Krish28062000/Active-vibration-control-hand-exoskeleton/docs/images/social_preview.png

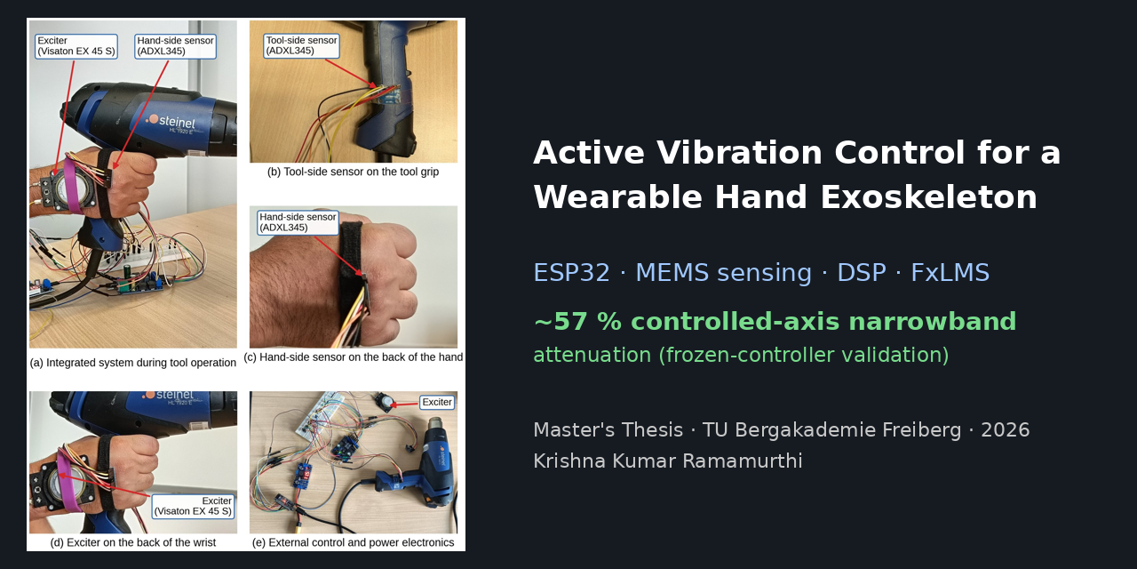
docs/images/social_preview.png
