Krish28062000/Active-vibration-control-hand-exoskeleton/data/01_sensor_validation/static_gravity_validation.xlsx

Sheet: Freeze Summary
TEST 01 — Static Triaxial Gravity Verification and Calibration Identification
Item | Freeze-status conclusion
Dataset | Latest selected ±X/±Y/±Z results; n=3 per pose; N=3200 per record
ADXL1 role | Tool/reference sensor
ADXL2 role | Hand/error sensor
Digital integrity | PASS — expected register state, no clipping, no late samples, no stuck data
Short-term repeatability | PASS — excellent for all selected active-axis poses
Axis polarity | PASS for all selected orientations
Raw absolute response | Axis-dependent; calibration required before final quantitative comparison
Dominant systematic effect | Z-axis static bias: negative for ADXL1, positive for ADXL2
Current coefficients | CANDIDATE ONLY — identified from the selected calibration dataset
Thesis freeze status | FREEZE methodology + raw findings; freeze final corrected accuracy only after independent validation
Scientific verdict
The selected six-position dataset demonstrates a stable and repeatable dual-ADXL345 measurement chain. Improved physical alignment reduced several transverse components, while the characteristic Z-axis polarity asymmetry remained. This supports a systematic offset/sensitivity interpretation rather than random instability. The present dataset is therefore suitable for identifying candidate per-axis bias and scale coefficients. However, the same data must not be used as independent proof of corrected accuracy. A fresh post-calibration six-position verification is required before the corrected sensor accuracy is frozen for the thesis.
KPI | ADXL1 | ADXL2 | Interpretation
Maximum active-axis repeat CV (%) | 0.125 | 0.134 | Both < 0.2% in selected dataset
Candidate Z bias (m/s²) | -0.689 | 1.523 | Large, opposite-sign static bias
Candidate Z bias (mg) | -70.237 | 155.274 | Preliminary installed-system estimate
Candidate Z span error (%) | -2.858 | -1.146 | Far smaller than the raw +Z/−Z error
Selected records | 18.000 | 18.000 | 36 total records
Invalid selected records | 0.000 | 0.000 | All selected records structurally valid
Important: the final two mislabeled −Z records in the 10:44 log are NOT part of the selected dataset. They are preserved in the Excluded Superseded sheet.

Sheet: Selected Results
Sensor | Role | Orientation | Active axis | Mean X (m/s²) | Mean Y (m/s²) | Mean Z (m/s²) | Vector norm (m/s²) | Active mean (m/s²) | Active error (%) | Norm error (%) | Between-repeat SD active | Active CV (%) | Raw transverse magnitude | Valid repeats | Status
ADXL1 | Tool/reference | +X | X | 9.6295 | -0.3378 | -0.0915 | 9.6394 | 9.6295 | -1.8060 | -1.7060 | 0.0036 | 0.0379 | 0.3499 | 3 | COMPLETE
ADXL1 | Tool/reference | -X | X | -9.5102 | 0.5747 | -0.9444 | 9.5774 | -9.5102 | 3.0230 | -2.3370 | 0.0064 | 0.0672 | 1.1055 | 3 | COMPLETE
ADXL1 | Tool/reference | +Y | Y | -0.2187 | 9.8075 | -1.4193 | 9.9149 | 9.8075 | 0.0090 | 1.1040 | 0.0011 | 0.0112 | 1.4360 | 3 | COMPLETE
ADXL1 | Tool/reference | -Y | Y | 0.2489 | -9.5546 | -2.4756 | 9.8750 | -9.5546 | 2.5700 | 0.6970 | 0.0119 | 0.1246 | 2.4881 | 3 | COMPLETE
ADXL1 | Tool/reference | +Z | Z | 0.7166 | 0.1705 | 8.8376 | 8.8725 | 8.8376 | -9.8820 | -9.5250 | 0.0110 | 0.1248 | 0.7366 | 3 | COMPLETE
ADXL1 | Tool/reference | -Z | Z | 0.2017 | 0.0421 | -10.2152 | 10.2184 | -10.2152 | -4.1660 | 4.1990 | 0.0035 | 0.0344 | 0.2060 | 3 | COMPLETE
ADXL2 | Hand/error | +X | X | 9.8054 | -0.2317 | 1.5060 | 9.9277 | 9.8054 | -0.0130 | 1.2350 | 0.0035 | 0.0359 | 1.5238 | 3 | COMPLETE
ADXL2 | Hand/error | -X | X | -9.9235 | 0.8846 | 0.9486 | 10.0117 | -9.9235 | -1.1920 | 2.0910 | 0.0035 | 0.0356 | 1.2971 | 3 | COMPLETE
ADXL2 | Hand/error | +Y | Y | 0.0006 | 10.2268 | 0.1351 | 10.2304 | 10.2268 | 4.2850 | 4.3210 | 0.0022 | 0.0215 | 0.1351 | 3 | COMPLETE
ADXL2 | Hand/error | -Y | Y | -0.2651 | -9.6018 | 0.3026 | 9.6142 | -9.6018 | 2.0890 | -1.9620 | 0.0032 | 0.0334 | 0.4022 | 3 | COMPLETE
ADXL2 | Hand/error | +Z | Z | 0.0035 | 0.3134 | 11.2170 | 11.2245 | 11.2170 | 14.3810 | 14.4580 | 0.0150 | 0.1339 | 0.3134 | 3 | COMPLETE
ADXL2 | Hand/error | -Z | Z | -0.3386 | -0.0223 | -8.1715 | 8.1806 | -8.1715 | 16.6730 | -16.5810 | 0.0080 | 0.0974 | 0.3394 | 3 | COMPLETE

Sheet: Calibration Parameters
Sensor | Role | Axis | +g selected mean | −g selected mean | Candidate bias b (m/s²) | Candidate bias (mg) | Measured sensitivity ratio s | Span error (%) | Correction gain K=1/s | Correction equation | Freeze status | Constant | Value
ADXL1 | Tool/reference | X | 9.629546 | -9.510226 | 0.059660 | 6.083627 | 0.975857 | -2.414321 | 1.024741 | aX,corr = 1.024741 × (aX,raw − (0.059660)) | Candidate — independent validation required | g (m/s²) | 9.80665
ADXL1 | Tool/reference | Y | 9.807509 | -9.554607 | 0.126451 | 12.894413 | 0.987193 | -1.280682 | 1.012973 | aY,corr = 1.012973 × (aY,raw − (0.126451)) | Candidate — independent validation required
ADXL1 | Tool/reference | Z | 8.837584 | -10.215163 | -0.688790 | -70.236982 | 0.971420 | -2.858025 | 1.029421 | aZ,corr = 1.029421 × (aZ,raw − (-0.688790)) | Candidate — independent validation required
ADXL2 | Hand/error | X | 9.805357 | -9.923497 | -0.059070 | -6.023464 | 1.005892 | 0.589161 | 0.994143 | aX,corr = 0.994143 × (aX,raw − (-0.059070)) | Candidate — independent validation required
ADXL2 | Hand/error | Y | 10.226844 | -9.601801 | 0.312521 | 31.868324 | 1.010980 | 1.097954 | 0.989140 | aY,corr = 0.989140 × (aY,raw − (0.312521)) | Candidate — independent validation required
ADXL2 | Hand/error | Z | 11.216983 | -8.171547 | 1.522718 | 155.274023 | 0.988540 | -1.146008 | 1.011593 | aZ,corr = 1.011593 × (aZ,raw − (1.522718)) | Candidate — independent validation required
Definitions: bᵢ=(aᵢ⁺+aᵢ⁻)/2; sᵢ=(aᵢ⁺−aᵢ⁻)/(2g); Kᵢ=1/sᵢ; aᵢ,corr=Kᵢ(aᵢ,raw−bᵢ), with g=9.80665 m/s².

Sheet: Repeatability Integrity
Repeatability and Data-Integrity Assessment
Sensor | Orientation | Active mean | Between SD | CV (%) | Assessment | Integrity metric | Result | Verdict
ADXL1 | +X | 9.6295 | 0.0036 | 0.0379 | Excellent | Selected records | 36 | PASS
ADXL1 | -X | -9.5102 | 0.0064 | 0.0672 | Excellent | Clipping events | 0 | PASS
ADXL1 | +Y | 9.8075 | 0.0011 | 0.0112 | Excellent | Late samples | 0 | PASS
ADXL1 | -Y | -9.5546 | 0.0119 | 0.1246 | Excellent | Raw data changed | All selected runs = 1 | PASS
ADXL1 | +Z | 8.8376 | 0.0110 | 0.1248 | Excellent | Register before/after | All selected runs = 1/1 | PASS
ADXL1 | -Z | -10.2152 | 0.0035 | 0.0344 | Excellent | Max lateness | ≤ 2 µs in selected latest runs | PASS
ADXL2 | +X | 9.8054 | 0.0035 | 0.0359 | Excellent | Selected invalid runs | 0 | PASS
ADXL2 | -X | -9.9235 | 0.0035 | 0.0356 | Excellent
ADXL2 | +Y | 10.2268 | 0.0022 | 0.0215 | Excellent
ADXL2 | -Y | -9.6018 | 0.0032 | 0.0334 | Excellent
ADXL2 | +Z | 11.2170 | 0.0150 | 0.1339 | Excellent
ADXL2 | -Z | -8.1715 | 0.0080 | 0.0974 | Excellent

Sheet: Selected Raw Repeats
Sensor | Role | Orientation | Repeat | N | Mean X | SD X | Mean Y | SD Y | Mean Z | SD Z | Mean norm | SD norm | Active axis | Measured active | Active error % | Norm error % | Clip | Late | Max late µs | Raw changed | Reg before | Reg after | Status
ADXL1 | Tool/reference | +X | 1 | 3200 | 9.629490 | 0.137651 | -0.320907 | 0.189651 | -0.073193 | 0.163088 | 9.638324 | 0.140052 | X | 9.629490 | -1.807000 | -1.716000 | 0 | 0 | 2 | 1 | 1 | 1 | VALID
ADXL1 | Tool/reference | +X | 2 | 3200 | 9.625928 | 0.138254 | -0.427924 | 0.182347 | -0.068126 | 0.161009 | 9.638707 | 0.140891 | X | 9.625928 | -1.843000 | -1.713000 | 0 | 0 | 2 | 1 | 1 | 1 | VALID
ADXL1 | Tool/reference | +X | 3 | 3200 | 9.633219 | 0.139519 | -0.264447 | 0.176655 | -0.133144 | 0.185968 | 9.641152 | 0.141348 | X | 9.633219 | -1.769000 | -1.688000 | 0 | 0 | 2 | 1 | 1 | 1 | VALID
ADXL1 | Tool/reference | -X | 1 | 3200 | -9.502920 | 0.138622 | 0.694618 | 0.156763 | -0.903106 | 0.177857 | 9.573873 | 0.141206 | X | -9.502920 | 3.097000 | -2.374000 | 0 | 0 | 2 | 1 | 1 | 1 | VALID
ADXL1 | Tool/reference | -X | 2 | 3200 | -9.514752 | 0.133558 | 0.525356 | 0.162528 | -0.963415 | 0.169516 | 9.580678 | 0.135079 | X | -9.514752 | 2.977000 | -2.304000 | 0 | 0 | 2 | 1 | 1 | 1 | VALID
ADXL1 | Tool/reference | -X | 3 | 3200 | -9.513007 | 0.124207 | 0.504081 | 0.147009 | -0.966618 | 0.160840 | 9.577718 | 0.126335 | X | -9.513007 | 2.994000 | -2.334000 | 0 | 0 | 2 | 1 | 1 | 1 | VALID
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
ADXL2 | Hand/error | -Z | 3 | 3200 | -0.342397 | 0.140209 | -0.029999 | 0.116046 | -8.162424 | 0.212657 | 8.171689 | 0.212452 | Z | -8.162424 | 16.766000 | -16.672000 | 0 | 0 | 2 | 1 | 1 | 1 | VALID

Sheet: Excluded Superseded
Excluded / Superseded Observations — Preserve for Audit Trail
Status | Sensor | Command | Observed Z | Reason | Use in calculations | Source | Comment
INVALID | ADXL1 | -Z | +8.480 m/s² | Physical sign inconsistent with commanded −Z | NO | 10:44 log | Likely +Z-up pose; active error ≈186%
INVALID | ADXL2 | -Z | +10.995 m/s² | Physical sign inconsistent with commanded −Z | NO | 10:44 log | Likely +Z-up pose; active error ≈212%
SUPERSEDED | ADXL1 | -Z | −10.136 m/s² | Replaced by cleaner latest −Z pose | NO for final coefficients | 10:44 log | Retain as repeat evidence
SUPERSEDED | ADXL2 | -Z | −8.115 m/s² | Replaced by cleaner latest −Z pose | NO for final coefficients | 10:44 log | Retain as repeat evidence
SUPERSEDED | ADXL1 | +Z | +8.803 m/s² | Replaced by later +Z pose with smaller transverse components | NO for final coefficients | 10:44 log | Retain as repeat evidence

Sheet: Thesis Main Tables
Main-Thesis Tables — Recommended Final Presentation
Table 4.x — Static gravity response of the selected dual-accelerometer dataset |  |  |  |  |  |  |  |  |  | Sensor-axis | +g measured | −g measured | Ideal +g | Sensor-axis | Candidate bias (m/s²)
Sensor | Axis | Positive pose | Negative pose | +g mean | −g mean | Bias (m/s²) | Sensitivity ratio | Span error % | Correction gain | ADXL1-X | 9.6295 | -9.5102 | 9.8066 | ADXL1-X | 0.0597
ADXL1 | X | +X | -X | 9.6295 | -9.5102 | 0.0597 | 0.9759 | -2.4143 | 1.0247 | ADXL1-Y | 9.8075 | -9.5546 | 9.8066 | ADXL1-Y | 0.1265
ADXL1 | Y | +Y | -Y | 9.8075 | -9.5546 | 0.1265 | 0.9872 | -1.2807 | 1.0130 | ADXL1-Z | 8.8376 | -10.2152 | 9.8066 | ADXL1-Z | -0.6888
ADXL1 | Z | +Z | -Z | 8.8376 | -10.2152 | -0.6888 | 0.9714 | -2.8580 | 1.0294 | ADXL2-X | 9.8054 | -9.9235 | 9.8066 | ADXL2-X | -0.0591
ADXL2 | X | +X | -X | 9.8054 | -9.9235 | -0.0591 | 1.0059 | 0.5892 | 0.9941 | ADXL2-Y | 10.2268 | -9.6018 | 9.8066 | ADXL2-Y | 0.3125
ADXL2 | Y | +Y | -Y | 10.2268 | -9.6018 | 0.3125 | 1.0110 | 1.0980 | 0.9891 | ADXL2-Z | 11.2170 | -8.1715 | 9.8066 | ADXL2-Z | 1.5227
ADXL2 | Z | +Z | -Z | 11.2170 | -8.1715 | 1.5227 | 0.9885 | -1.1460 | 1.0116 | Ideal |  | -9.8066 | 9.8066
Table 4.y — Repeatability and measurement-integrity summary
Metric | ADXL1 | ADXL2 | Overall | Recommended main-text statement | Location
Maximum selected active-axis CV (%) | 0.1248 | 0.1339 | 0.1339 | All selected poses remained well below 0.5% CV. | Main text
Clipping events | 0 | 0 | 0 | No clipping was observed. | Main text
Late samples | 0 | 0 | 0 | No late samples were observed in the selected records. | Main text
Register integrity | PASS | PASS | PASS | Sensor configuration remained unchanged before/after records. | Main text
Raw repeats | 18 | 18 | 36 | Three independent records were acquired per pose. | Methods/results
Recommended figures
Figure | Plot | Reason
Figure 4.x | Measured +g/−g active-axis response with ideal ±9.80665 m/s² reference | Makes polarity asymmetry and offset immediately visible
Figure 4.y | Candidate bias b for X/Y/Z of ADXL1 and ADXL2 | Shows opposite-sign Z bias clearly
Figure 4.z (after validation) | Raw vs corrected gravity error using independent validation data | Do not generate final version from calibration data itself

Sheet: Thesis Draft
Draft Thesis Subsection — Candidate for Freeze after Supervisor/User Validation
Suggested subsection title
4.2.x Static Triaxial Verification and Calibration of the ADXL345 Measurement Channels
Purpose and protocol
Before the dynamic vibration experiments, the two ADXL345 measurement channels were evaluated under static gravitational loading. ADXL1 was used as the tool-side reference sensor and ADXL2 as the hand-side error sensor. Each accelerometer was successively oriented with its positive and negative X, Y and Z axes aligned as closely as practicable with the gravity vector. Three independent records were acquired for each orientation, with 3200 samples per record. In addition to the acceleration statistics, the firmware monitored sample timing, clipping, raw-data activity and the sensor configuration registers before and after every record.
Measurement integrity and repeatability
All 36 records selected for the final calibration dataset were structurally valid. No clipping or late samples were observed, the raw-data activity check remained valid, and the ADXL345 configuration registers retained the expected values throughout the measurements. The active-axis means were highly repeatable within each orientation. The maximum between-repeat coefficient of variation in the selected dataset remained below 0.2%, indicating that the principal deviations from the ideal ±g response were systematic rather than random.
Observed static response
The improved six-position measurements produced substantially cleaner axis alignment than the preliminary hand-held trial, particularly for the X orientations and the final Z orientations. Nevertheless, the raw response remained sensor- and axis-dependent. ADXL1 exhibited a negative Z-axis bias, whereas ADXL2 exhibited a positive Z-axis bias. Using the selected +Z and −Z measurements, the preliminary bias estimates were approximately -0.689 m/s² for ADXL1 and 1.523 m/s² for ADXL2. In contrast, the corresponding Z-axis span errors were only -2.86% and -1.15%, respectively. The opposite-polarity asymmetry therefore cannot be interpreted simply as a large sensitivity error.
Calibration model
For each sensor axis i, the static bias was estimated as b_i=(a_i+ + a_i−)/2 and the measured sensitivity ratio as s_i=(a_i+ − a_i−)/(2g), where g=9.80665 m/s². The corresponding correction gain was K_i=1/s_i, giving the linear correction a_i,corr=K_i(a_i,raw−b_i). These coefficients are reported as candidate installed-system calibration parameters. They are not yet treated as final validated constants because the calibration and verification data must remain independent.
Interpretation and limitation
The static experiment verifies sensor polarity, short-term repeatability, acquisition integrity and the presence of installed-system offset and sensitivity differences. It does not by itself establish dynamic amplitude accuracy at the vibration-control frequency. Dynamic suitability is therefore verified separately through the subsequent stationary-noise, same-body dual-sensor and controlled-frequency vibration experiments. A fresh six-position run with the candidate coefficients enabled is required before the corrected static accuracy is frozen.
Result statement to freeze
The dual-ADXL345 measurement chain passed the static integrity and repeatability verification. The selected data showed highly repeatable but axis-dependent raw acceleration values, with the largest systematic effect occurring as opposite-sign Z-axis bias in the two accelerometers. A per-axis offset-and-scale calibration model was therefore identified. Final corrected accuracy will be reported only after independent post-calibration six-position validation.

Sheet: Validation Plan
Independent Post-Calibration Validation — Required Before Final Freeze
Step | Action | Data to save | Decision metric | Status | Thesis use
1 | Apply candidate b and K coefficients in firmware; keep raw values in output | RAW XYZ + CAL XYZ | Code audit | Pending | Methodology
2 | Fresh +X/−X/+Y/−Y/+Z/−Z run for ADXL1 | 3 records/pose | Correct sign + repeatability | Pending | Verification
3 | Fresh +X/−X/+Y/−Y/+Z/−Z run for ADXL2 | 3 records/pose | Correct sign + repeatability | Pending | Verification
4 | Compare corrected active-axis and vector norm to g | Summary statistics | Project target: ≤3%, preferably ≤2% | Pending | Results
5 | Confirm clipping/timing/register integrity | Validity flags | All PASS | Pending | Results
6 | Freeze calibration constants only after independent pass | Versioned constants | Pass/Fail | Pending | Thesis freeze
7 | Proceed to stationary noise-floor Test 02 | 10 stationary records | Noise floor | Pending | Section 4.2
The ≤3% / preferably ≤2% target is a project-defined engineering acceptance target, not an ISO requirement or an ADXL345 datasheet accuracy specification.

Sheet: Sources
Source | Type | Use in workbook/thesis | URL / provenance
Latest full experimental log | Primary experimental data | X/Y/+Z selected records and integrity evidence | Pasted text(20260817-104409).txt
Latest ADXL1 −Z rerun | Primary experimental data | Replaces earlier ADXL1 −Z for coefficient identification | Conversation result immediately preceding this workbook
Latest ADXL2 −Z rerun | Primary experimental data | Replaces earlier ADXL2 −Z for coefficient identification | Conversation result immediately preceding ADXL1 −Z rerun
ADXL345 Rev. G datasheet | Manufacturer primary source | Full-resolution scale, offset registers, calibration discussion | https://www.analog.com/media/en/technical-documentation/data-sheets/adxl345.pdf
AN-1057 | Manufacturer application note | Gravity projection, offset/sensitivity mismatch context | https://www.analog.com/en/resources/app-notes/an-1057.html
