Krish28062000/Active-vibration-control-hand-exoskeleton/data/01_sensor_validation/stationary_noise_floor.xlsx

Sheet: Executive Verdict
TEST 02 V2 — Stationary Noise-Floor Characterization: Thesis Audit
 |  |  |  | Channel | V1 broadband | V2 broadband | V2 screened? | Channel | Mean 268 Hz | Max 268 Hz | Sensor | Measured Fs | Nominal Fs
Assessment item | Verdict |  |  | ADXL1-X | 0.126601896 | 0.3107549826 | 10 clean | ADXL1-X | 0.008062325816 | 0.02148821933 | ADXL1 | 1542.684616 | 1600
Campaign completion | 10/10 records collected for both sensors |  |  | ADXL1-Y | 0.1459826628 | 0.3218261857 | 10 clean | ADXL1-Y | 0.0107056123 | 0.02399554162 | ADXL2 | 1584.808629 | 1600
Register integrity | PASS — all before/after checks valid |  |  | ADXL1-Z | 0.1550978445 | 0.4282262204 | 10 clean | ADXL1-Z | 0.01361392689 | 0.02549054899
Clipping | PASS — zero clipping in all records |  |  | ADXL2-X | 0.122140815 | 0.3783184634 | 8 clean | ADXL2-X | 0.01219186968 | 0.02042336316
DATA_READY timeouts | PASS — zero timeouts |  |  | ADXL2-Y | 0.128609652 | 0.4266211372 | 8 clean | ADXL2-Y | 0.01163107507 | 0.02839383365
Fresh-sample method | Improved versus V1 — DATA_READY synchronized |  |  | ADXL2-Z | 0.2110683135 | 0.80198192 | 8 clean | ADXL2-Z | 0.02436242281 | 0.04858208975
Measured effective sample rate | ADXL1 ≈1542.685 Hz; ADXL2 ≈1584.809 Hz
Sampling-rate stability | Excellent between records (CV <0.03%)
Timing anomaly | ADXL2 records 4 and 8 contain ~2× normal maximum interval
Broadband system noise | Repeatable, but materially higher than V1
268 Hz floor | Measurable; ADXL2-Z is highest channel
Final thesis status | NOT YET FINAL — timing-screening/final acquisition method must be closed
Move to next experimental test? | NO — close Test 02 first; do not freeze current firmware summary blindly
Central scientific finding
V2 confirms that the stationary measurement chain is stable at the communication level and reveals a substantially larger system-level broadband noise floor than V1. The largest stationary noise occurs on ADXL2-Z. However, two ADXL2 campaign records contain a single approximately double-duration sampling interval that the firmware did not reject. Because those records also raise the 268-Hz statistics, the unfiltered 10-record V2 summary must not be frozen as the final narrowband noise-floor result. The workbook therefore preserves the firmware summary and separately reports a timing-screened reanalysis.
KPI | ADXL1 | ADXL2 | Interpretation
Mean effective Fs (Hz) | 1542.684616 | 1584.808629 | Measured from DATA_READY timing
Deviation from nominal 1600 Hz (%) | -3.582211 | -0.949461 | Stable sensor-specific rate difference
SD of effective Fs (Hz) | 0.321089 | 0.474170 | Very small record-to-record variation
Mean interval-jitter SD (µs) | 8.602610 | 9.156511 | Host detection/timing variability
Timing-anomaly records | 0.000000 | 2.000000 | ADXL2 records 4 and 8
Mean 268-Hz noise, Z (m/s²) | 0.013614 | 0.024362 | Firmware 10-record summary
Max 268-Hz noise, Z (m/s²) | 0.025491 | 0.048582 | Firmware 10-record summary

Sheet: V2 Firmware Summary
Sensor | Role | Axis | n | Mean broadband SD | SD broadband SD | Max broadband SD | Mean P2P | Max P2P | Mean 268-Hz amplitude | SD 268-Hz amplitude | Max 268-Hz amplitude | Mean strongest FFT amplitude | Max strongest FFT amplitude
ADXL1 | Tool/reference | X | 10 | 0.310755 | 0.005955 | 0.324431 | 2.149422 | 2.371248 | 0.008062 | 0.005797 | 0.021488 | 0.084211 | 0.117795
ADXL1 | Tool/reference | Y | 10 | 0.321826 | 0.008506 | 0.345255 | 2.248861 | 2.447740 | 0.010706 | 0.006447 | 0.023996 | 0.087561 | 0.108521
ADXL1 | Tool/reference | Z | 10 | 0.428226 | 0.014316 | 0.467542 | 2.891393 | 3.289150 | 0.013614 | 0.005124 | 0.025491 | 0.136393 | 0.173144
ADXL2 | Hand/error | X | 10 | 0.378318 | 0.007719 | 0.397541 | 2.554828 | 2.830199 | 0.012192 | 0.004272 | 0.020423 | 0.093852 | 0.118307
ADXL2 | Hand/error | Y | 10 | 0.426621 | 0.010985 | 0.454931 | 2.608373 | 2.830199 | 0.011631 | 0.007254 | 0.028394 | 0.104457 | 0.122876
ADXL2 | Hand/error | Z | 10 | 0.801982 | 0.021575 | 0.849777 | 5.553310 | 6.042858 | 0.024362 | 0.011651 | 0.048582 | 0.264975 | 0.323547

Sheet: Sampling Integrity
Record | Sensor | Role | Mean interval (µs) | SD interval (µs) | Min interval (µs) | Max interval (µs) | Effective Fs (Hz) | Fs deviation from 1600 (%) | Max/mean interval ratio | Timing screen | Clip count | DATA_READY timeouts | Raw changed | Reg before | Reg after | Firmware status
1 | ADXL1 | Tool/reference | 648.2503 | 8.5415 | 632.0000 | 658.0000 | 1542.6140 | -3.5866 | 1.0150 | PASS | 0 | 0 | 1 | 1 | 1 | VALID
1 | ADXL2 | Hand/error | 631.2603 | 8.0654 | 614.0000 | 641.0000 | 1584.1325 | -0.9917 | 1.0154 | PASS | 0 | 0 | 1 | 1 | 1 | VALID
2 | ADXL1 | Tool/reference | 648.2017 | 8.5796 | 632.0000 | 658.0000 | 1542.7297 | -3.5794 | 1.0151 | PASS | 0 | 0 | 1 | 1 | 1 | VALID
2 | ADXL2 | Hand/error | 631.1714 | 8.1667 | 614.0000 | 642.0000 | 1584.3556 | -0.9778 | 1.0172 | PASS | 0 | 0 | 1 | 1 | 1 | VALID
3 | ADXL1 | Tool/reference | 648.2078 | 8.6427 | 632.0000 | 660.0000 | 1542.7151 | -3.5803 | 1.0182 | PASS | 0 | 0 | 1 | 1 | 1 | VALID
3 | ADXL2 | Hand/error | 631.1670 | 8.1641 | 614.0000 | 640.0000 | 1584.3667 | -0.9771 | 1.0140 | PASS | 0 | 0 | 1 | 1 | 1 | VALID
4 | ADXL1 | Tool/reference | 648.2110 | 8.6203 | 632.0000 | 658.0000 | 1542.7076 | -3.5808 | 1.0151 | PASS | 0 | 0 | 1 | 1 | 1 | VALID
4 | ADXL2 | Hand/error | 631.1790 | 12.7387 | 614.0000 | 1255.0000 | 1584.3366 | -0.9790 | 1.9883 | TIMING_ANOMALY | 0 | 0 | 1 | 1 | 1 | VALID
5 | ADXL1 | Tool/reference | 648.1858 | 8.6257 | 632.0000 | 660.0000 | 1542.7674 | -3.5770 | 1.0182 | PASS | 0 | 0 | 1 | 1 | 1 | VALID
5 | ADXL2 | Hand/error | 630.8818 | 8.2772 | 614.0000 | 640.0000 | 1585.0830 | -0.9323 | 1.0145 | PASS | 0 | 0 | 1 | 1 | 1 | VALID
6 | ADXL1 | Tool/reference | 648.2059 | 8.6427 | 632.0000 | 658.0000 | 1542.7198 | -3.5800 | 1.0151 | PASS | 0 | 0 | 1 | 1 | 1 | VALID
6 | ADXL2 | Hand/error | 630.8994 | 8.2867 | 614.0000 | 641.0000 | 1585.0388 | -0.9351 | 1.0160 | PASS | 0 | 0 | 1 | 1 | 1 | VALID
7 | ADXL1 | Tool/reference | 648.1839 | 8.5854 | 632.0000 | 658.0000 | 1542.7721 | -3.5767 | 1.0151 | PASS | 0 | 0 | 1 | 1 | 1 | VALID
7 | ADXL2 | Hand/error | 630.8828 | 8.2653 | 614.0000 | 642.0000 | 1585.0805 | -0.9325 | 1.0176 | PASS | 0 | 0 | 1 | 1 | 1 | VALID
8 | ADXL1 | Tool/reference | 648.0967 | 8.6933 | 632.0000 | 658.0000 | 1542.9796 | -3.5638 | 1.0153 | PASS | 0 | 0 | 1 | 1 | 1 | VALID
8 | ADXL2 | Hand/error | 630.9705 | 12.9004 | 614.0000 | 1265.0000 | 1584.8603 | -0.9462 | 2.0048 | TIMING_ANOMALY | 0 | 0 | 1 | 1 | 1 | VALID
9 | ADXL1 | Tool/reference | 648.0872 | 8.6373 | 632.0000 | 658.0000 | 1543.0023 | -3.5624 | 1.0153 | PASS | 0 | 0 | 1 | 1 | 1 | VALID
9 | ADXL2 | Hand/error | 630.7485 | 8.3426 | 614.0000 | 640.0000 | 1585.4180 | -0.9114 | 1.0147 | PASS | 0 | 0 | 1 | 1 | 1 | VALID
10 | ADXL1 | Tool/reference | 648.5763 | 8.4577 | 632.0000 | 659.0000 | 1541.8386 | -3.6351 | 1.0161 | PASS | 0 | 0 | 1 | 1 | 1 | VALID
10 | ADXL2 | Hand/error | 630.7499 | 8.3579 | 614.0000 | 641.0000 | 1585.4143 | -0.9116 | 1.0163 | PASS | 0 | 0 | 1 | 1 | 1 | VALID
Screening rule used in this workbook: max interval / mean interval > 1.5 is flagged as a missed-update-like timing anomaly. This is a project data-quality rule for this dataset, not an ADXL345 manufacturer specification.

Sheet: All Record Metrics
Record | Sensor | Role | Axis | Mean LSB | Mean m/s² nominal | SD LSB | Broadband SD m/s² nominal | P2P LSB | P2P m/s² nominal | Target Hz | 268-Hz amp LSB | 268-Hz amp m/s² nominal | Strongest FFT peak Hz | FFT peak amp LSB | FFT peak amp m/s² nominal | Timing screen
1 | ADXL1 | Tool/reference | X | 16.766113 | 0.641236 | 8.012322 | 0.306439 | 58.000000 | 2.218264 | 268.000000 | 0.286392 | 0.010953 | 531.026790 | 1.671636 | 0.063933 | PASS
1 | ADXL1 | Tool/reference | Y | -4.147461 | -0.158624 | 8.326766 | 0.318465 | 60.000000 | 2.294756 | 268.000000 | 0.138038 | 0.005279 | 530.650180 | 1.822985 | 0.069722 | PASS
1 | ADXL1 | Tool/reference | Z | -265.617676 | -10.158796 | 11.153598 | 0.426580 | 74.000000 | 2.830199 | 268.000000 | 0.422466 | 0.016158 | 534.039710 | 2.870936 | 0.109802 | PASS
1 | ADXL2 | Hand/error | X | -247.991699 | -9.484674 | 9.811057 | 0.375233 | 64.000000 | 2.447740 | 268.000000 | 0.364829 | 0.013953 | 443.216770 | 2.361376 | 0.090313 | PASS
1 | ADXL2 | Hand/error | Y | -27.344727 | -1.045825 | 10.967921 | 0.419478 | 68.000000 | 2.600724 | 268.000000 | 0.210000 | 0.008032 | 441.669760 | 2.496608 | 0.095485 | PASS
1 | ADXL2 | Hand/error | Z | -25.228027 | -0.964869 | 21.147052 | 0.808789 | 156.000000 | 5.966366 | 268.000000 | 0.973804 | 0.037244 | 441.669760 | 6.303309 | 0.241076 | PASS
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
10 | ADXL2 | Hand/error | Z | -25.098633 | -0.959921 | 22.218760 | 0.849777 | 144.000000 | 5.507415 | 268.000000 | 0.563146 | 0.021538 | 490.410150 | 8.459633 | 0.323547 | PASS

Sheet: Quality-Screened Reanalysis
Timing-Screened Reanalysis of V2
Sensor | Axis | Clean n | Mean broadband SD | SD broadband SD | Mean 268-Hz amp | SD 268-Hz amp | Max 268-Hz amp | Mean strongest FFT amp | Max strongest FFT amp | Firmware n | Firmware mean 268-Hz | Change after screening (%) | Status
ADXL1 | X | 10 | 0.310755 | 0.005955 | 0.008062 | 0.005797 | 0.021488 | 0.084211 | 0.117795 | 10.000000 | 0.008062 | 0.000000 | 10 clean records
ADXL1 | Y | 10 | 0.321826 | 0.008506 | 0.010706 | 0.006447 | 0.023996 | 0.087561 | 0.108521 | 10.000000 | 0.010706 | 2.802269528e-09 | 10 clean records
ADXL1 | Z | 10 | 0.428226 | 0.014316 | 0.013614 | 0.005124 | 0.025491 | 0.136393 | 0.173144 | 10.000000 | 0.013614 | 7.345457576e-10 | 10 clean records
ADXL2 | X | 8 | 0.378008 | 0.008589 | 0.012425 | 0.004750 | 0.020423 | 0.096291 | 0.118307 | 10.000000 | 0.012192 | 1.914858 | INSUFFICIENT CLEAN n — replacement records required
ADXL2 | Y | 8 | 0.427110 | 0.012037 | 0.008417 | 0.002066 | 0.012695 | 0.108609 | 0.122876 | 10.000000 | 0.011631 | -27.633522 | INSUFFICIENT CLEAN n — replacement records required
ADXL2 | Z | 8 | 0.802437 | 0.024263 | 0.020694 | 0.008460 | 0.037244 | 0.273464 | 0.323547 | 10.000000 | 0.024362 | -15.059515 | INSUFFICIENT CLEAN n — replacement records required
Important: screening has a material effect on ADXL2 Y/Z at 268 Hz because records 4 and 8 are the timing-anomalous records. Therefore the original V2 10-record narrowband summary should not be frozen without replacement clean records.

Sheet: V1 vs V2
V1 vs V2 Comparison — Why V2 Changed the Observed Noise
Sensor | Axis | V1 broadband SD | V2 broadband SD | V2/V1 broadband ratio | V1 mean 268-Hz amp | V2 mean 268-Hz amp | V2/V1 target ratio | V1 max 268-Hz amp | V2 max 268-Hz amp | Interpretation
ADXL1 | X | 0.126602 | 0.310755 | 2.454584 | 0.004632 | 0.008062 | 1.740695 | 0.006763 | 0.021488 | V2 captures fresh sensor updates; V1 likely understated broadband variation
ADXL1 | Y | 0.145983 | 0.321826 | 2.204551 | 0.004207 | 0.010706 | 2.544597 | 0.008966 | 0.023996 | V2 captures fresh sensor updates; V1 likely understated broadband variation
ADXL1 | Z | 0.155098 | 0.428226 | 2.761007 | 0.003920 | 0.013614 | 3.472997 | 0.012994 | 0.025491 | V2 captures fresh sensor updates; V1 likely understated broadband variation
ADXL2 | X | 0.122141 | 0.378318 | 3.097396 | 0.005395 | 0.012192 | 2.259984 | 0.011157 | 0.020423 | V2 captures fresh sensor updates; V1 likely understated broadband variation
ADXL2 | Y | 0.128610 | 0.426621 | 3.317178 | 0.005907 | 0.011631 | 1.969135 | 0.011142 | 0.028394 | V2 captures fresh sensor updates; V1 likely understated broadband variation
ADXL2 | Z | 0.211068 | 0.801982 | 3.799632 | 0.009614 | 0.024362 | 2.534054 | 0.018612 | 0.048582 | V2 captures fresh sensor updates; V1 likely understated broadband variation

Sheet: Spectral Diagnostics
V2 Strongest Spectral Components by Record
Record | ADXL1 X peak Hz | ADXL1 Y peak Hz | ADXL1 Z peak Hz | ADXL2 X peak Hz | ADXL2 Y peak Hz | ADXL2 Z peak Hz | ADXL1 common-peak spread Hz | ADXL2 X-Z spread Hz | ADXL1 effective Fs | ADXL2 effective Fs | Timing note
1 | 531.027 | 530.650 | 534.040 | 443.217 | 441.670 | 441.670 | 3.390 | 1.547 | 1542.614 | 1584.133
2 | 539.353 | 539.353 | 539.353 | 449.855 | 685.806 | 449.855 | 0.000 | 0.000 | 1542.730 | 1584.356
3 | 535.205 | 535.205 | 537.464 | 451.405 | 453.726 | 453.726 | 2.260 | 2.321 | 1542.715 | 1584.367
4 | 534.072 | 534.072 | 534.449 | 467.642 | 467.642 | 467.642 | 0.377 | 0.000 | 1542.708 | 1584.337 | ADXL2 timing anomaly
5 | 539.743 | 540.119 | 540.119 | 480.633 | 480.633 | 480.633 | 0.377 | 0.000 | 1542.767 | 1585.083
6 | 538.219 | 538.219 | 539.726 | 475.976 | 632.313 | 475.976 | 1.507 | 0.000 | 1542.720 | 1585.039
7 | 540.874 | 540.874 | 540.874 | 475.215 | 475.215 | 475.215 | 0.000 | 0.000 | 1542.772 | 1585.081
8 | 548.481 | 546.974 | 548.481 | 487.530 | 482.887 | 487.530 | 1.507 | 0.000 | 1542.980 | 1584.860 | ADXL2 timing anomaly
9 | 546.229 | 546.229 | 546.229 | 492.347 | 492.734 | 492.734 | 0.000 | 0.387 | 1543.002 | 1585.418
10 | 505.916 | 508.927 | 509.680 | 490.410 | 490.410 | 490.410 | 3.764 | 0.000 | 1541.839 | 1585.414
Interpretation
ADXL1 shows a strong common spectral component across X/Y/Z, mainly near 531–548 Hz for records 1–9, before shifting near 506–510 Hz in record 10. ADXL2 X and Z also share a common dominant component that drifts from about 442 Hz toward about 493 Hz across the campaign. Because the strongest frequency is often shared by multiple axes of the same sensor, the feature is more consistent with a common mechanical/electrical/system contribution than independent white sensor noise. The current experiment does not identify its physical source; the statement should remain descriptive.

Sheet: Thesis Main Tables
Recommended Thesis Tables — Test 02
Table 4.x — Stationary measurement noise (V2 firmware-reported summary; not yet final freeze)
Sensor | Axis | Broadband RMS noise | Between-record SD | Max broadband RMS | Mean 268-Hz floor | SD 268-Hz floor | Max 268-Hz floor | Mean strongest spectral amplitude | Max strongest spectral amplitude | Clean n | Freeze status
ADXL1 | X | 0.310755 | 0.005955 | 0.324431 | 0.008062 | 0.005797 | 0.021488 | 0.084211 | 0.117795 | 10 | Candidate
ADXL1 | Y | 0.321826 | 0.008506 | 0.345255 | 0.010706 | 0.006447 | 0.023996 | 0.087561 | 0.108521 | 10 | Candidate
ADXL1 | Z | 0.428226 | 0.014316 | 0.467542 | 0.013614 | 0.005124 | 0.025491 | 0.136393 | 0.173144 | 10 | Candidate
ADXL2 | X | 0.378318 | 0.007719 | 0.397541 | 0.012192 | 0.004272 | 0.020423 | 0.093852 | 0.118307 | 8 | Not final — timing anomaly
ADXL2 | Y | 0.426621 | 0.010985 | 0.454931 | 0.011631 | 0.007254 | 0.028394 | 0.104457 | 0.122876 | 8 | Not final — timing anomaly
ADXL2 | Z | 0.801982 | 0.021575 | 0.849777 | 0.024362 | 0.011651 | 0.048582 | 0.264975 | 0.323547 | 8 | Not final — timing anomaly
Table 4.y — Sampling integrity and measured effective data rate
Sensor | Nominal ODR | Measured mean Fs | SD Fs | Deviation from nominal | Mean jitter SD | Timing anomaly records | Status
ADXL1 | 1600.0000 | 1542.6846 | 0.3211 | -3.5822 | 8.6026 | None | PASS
ADXL2 | 1600.0000 | 1584.8086 | 0.4742 | -0.9495 | 9.1565 | 4, 8 | REQUIRES SCREENING
Overall |  |  |  |  |  |  | Communication/register integrity PASS; spectral dataset not fully clean

Sheet: Thesis Draft
Thesis Draft — Stationary Noise-Floor Verification
Purpose and method
Following the static sensor verification, the stationary noise of the dual-accelerometer measurement chain was characterized with the tool and actuator inactive. Both ADXL345 devices remained in the final measurement architecture. Each sensor was configured at a nominal output data rate of 1600 Hz and 4096 fresh samples were acquired per record using DATA_READY-synchronized access. Ten records were collected for each sensor. For every axis, the mean-removed time-domain standard deviation, peak-to-peak variation, exact-frequency amplitude at 268 Hz, and the strongest FFT component were calculated.
Acquisition integrity
All campaign records passed the firmware checks for clipping, DATA_READY timeout, raw-data activity and register integrity. The measured mean effective sampling rates were 1542.685 Hz for ADXL1 and 1584.809 Hz for ADXL2. Record-to-record sampling-rate variation was small (SD 0.321 Hz and 0.474 Hz, respectively). However, detailed timing review identified one approximately double-duration sampling interval in ADXL2 records 4 and 8. These records were therefore flagged for frequency-domain quality screening rather than being silently accepted as equivalent to the remaining records.
Stationary-noise result
The firmware-reported mean broadband stationary noise ranged from 0.311 to 0.428 m/s² for ADXL1 and from 0.378 to 0.802 m/s² for ADXL2. The largest stationary noise occurred on ADXL2-Z, with a mean broadband standard deviation of 0.802 m/s². At the 268 Hz control-frequency probe, the firmware-reported mean amplitudes ranged from 0.0081 to 0.0244 m/s² across the six channels.
Spectral observations
The dominant stationary spectral component was not distributed randomly across frequency. ADXL1 generally showed a common strongest component across all three axes near 0.53–0.55 kHz, while ADXL2 X and Z showed a common component that shifted from approximately 0.44 to 0.49 kHz over the campaign. These components are reported as system-level stationary spectral features. The present dataset does not by itself determine whether their origin is mechanical, electrical, supply-related, or associated with the acquisition implementation.
Thesis freeze limitation
The communication integrity and approximate system-level broadband noise behavior can be retained as verified observations. The unfiltered ten-record 268 Hz and FFT summary should not yet be frozen as the final detection-floor dataset because two ADXL2 records contain timing anomalies that were not rejected by the V2 firmware. A final acquisition pass must enforce a timing/FIFO validity criterion before the 268 Hz detection threshold is fixed.

Sheet: Audit Trail
Data Selection and Audit Trail
Item | Sensor | Record(s) | Firmware status | Workbook screen | Reason | Use | Action
V2 campaign | ADXL1 | 1–10 | VALID | PASS | No long-interval anomaly | Use as candidate dataset | Retain
V2 campaign | ADXL2 | 1–3,5–7,9–10 | VALID | PASS | Timing consistent | Use as candidate dataset | Retain
V2 campaign | ADXL2 | 4 | VALID | TIMING_ANOMALY | max interval 1255 µs vs mean 631.179 µs | Do not use in final spectral summary | Replace
V2 campaign | ADXL2 | 8 | VALID | TIMING_ANOMALY | max interval 1265 µs vs mean 630.971 µs | Do not use in final spectral summary | Replace
V1 dataset | Both | 1–10 | VALID | SUPERSEDED | Host-scheduled asynchronous acquisition | Pilot/audit trail only | Do not mix with V2 final values
Calibration constants | Both | — | — | NOT APPLIED | Noise output uses nominal 0.0039 g/LSB | Preserve raw/nominal scale | Rescale later if needed
Final Test 02 status | Both | — | — | OPEN | Need final timing-safe acquisition / replacement clean records | Not frozen | Close before next test

Sheet: Sources
Source | Type | Purpose | Provenance / URL
Test 02 V2 log | Primary experimental data | All V2 values and timing records | Pasted text(20260817-112922).txt
Test 02 V1 log | Primary experimental data | V1 vs V2 comparison | Pasted text(20260817-111801).txt
ADXL345 Rev. G datasheet | Manufacturer primary source | ODR/bandwidth, async reading, upper-rate formatting, noise performance | https://www.analog.com/media/en/technical-documentation/data-sheets/adxl345.pdf
Quality-screening rule | Project analysis rule | max interval / mean interval >1.5 flags missed-update-like record | Defined for this workbook; not a manufacturer limit
Nominal conversion | Firmware/test configuration | 0.0039 g/LSB × 9.80665 m/s² | Program-reported nominal conversion

Sheet: Manufacturer Context
ADXL345 Manufacturer Context — Interpretation, Not Acceptance Limits
Item | Datasheet context | ADXL1 observed | ADXL2 observed | Interpretation | Pass/fail use | Source section | Note
ODR / bandwidth | 1600 Hz ODR corresponds to 800 Hz bandwidth |  |  | High ODR intentionally admits wide-band noise | Context only | Output Data Rate and Bandwidth
Normal-power noise trend | >100 Hz: noise rises ~√2 for each ODR doubling |  |  | Higher 1600-Hz noise is expected relative to low ODR | Context only | Noise Performance
Approx. typical X/Y noise at 1600 Hz | ~3 LSB rms by extrapolating the stated 400-Hz example | 8.270 | 10.523 | Installed-system values exceed the simple typical trend | Do NOT fail sensor solely from this | Noise Performance | Includes environment, mounting, supply and acquisition chain
Approx. typical Z noise at 1600 Hz | ~4.4 LSB rms by extrapolating the stated 400-Hz example | 11.197 | 20.969 | Z is the noisiest measured channel, especially ADXL2-Z | Do NOT treat as manufacturer-limit violation | Noise Performance | System-level measurement
Asynchronous reads | Use FIFO stream mode or synchronize to DATA_READY |  |  | V2 improves on V1 by synchronizing fresh data | Method requirement | Asynchronous Data Readings
1600-Hz data formatting | In full-resolution operation the output LSB is always 0 |  |  | Upper-rate formatting differs from ≤800 Hz | Document configuration | Data Formatting of Upper Data Rates
Power/ground | Supply and ground noise can affect acceleration output |  |  | Potential contributors must remain controlled | Experimental control | Power Supply Decoupling | No causal attribution made from this test alone
Important interpretation
The manufacturer noise information describes typical device behavior under specified conditions and is not an acceptance limit for this installed dual-sensor system. The present experiment measures the complete stationary measurement chain, so environmental vibration, mounting, supply/ground noise and digital activity may all contribute. The thesis should therefore call these values the 'stationary system noise floor' rather than the intrinsic ADXL345 self-noise.
