Krish28062000/Active-vibration-control-hand-exoskeleton/data/02_actuator_characterization/m3_dataset.xlsx

Sheet: M3 Summary
M3 — Dual-ADXL Controlled-Visaton Consistency | Final Frozen Dataset
Test ID | M3 — Dual-ADXL rigid-body / controlled-source consistency
Final dataset | 12 independent Visaton ON/OFF cycles; clean campaign after reset
Command | 268.000 Hz; DAC sine peak = 19.00
Source | User-provided final Serial Monitor log: Pasted text(20260817-143523).txt
Physical interpretation constraint | ADXL1 and ADXL2 were at different locations on the Visaton plate; local vibration amplitude can legitimately differ by position.
Primary objective | Verify that both ADXL measurement chains recover the same controlled vibration frequency with stable, valid acquisition; characterize—not force—cross-location amplitude agreement.
Final verdict | GOAL ACHIEVED for M3 measurement-chain consistency. Frequency agreement and acquisition integrity are excellent. Absolute amplitude equality is NOT required or claimed across different Visaton locations.
Key Results — final 12-run campaign
Valid runs | 12 | ADXL1 mean resultant (m/s²) | 4.407043 | Pooled comparable XYZ R² | 0.991788
ADXL1 mean frequency (Hz) | 268.028160 | ADXL2 mean resultant (m/s²) | 4.778675 | Pooled comparable XYZ slope | 1.115671
ADXL2 mean frequency (Hz) | 268.027481 | Mean resultant SymDiff (%) | 8.097417 | Mean Sync ADXL1 | 0.904042
Mean |ADXL2-ADXL1| (Hz) | 0.005651 | Mean resultant A2/A1 | 1.084663 | Mean Sync ADXL2 | 0.929417
Interpretation for thesis
Frequency agreement | PASS — mean absolute inter-sensor frequency difference = 0.005651 Hz; maximum = 0.015348 Hz. Both sensors resolve the same controlled 268 Hz excitation.
Acquisition validity | PASS — 12/12 runs valid; no clipping, zero-triplet corruption, or stuck-sample failure was reported.
Resultant amplitude | Mean cross-location resultant symmetric difference = 8.097%; maximum = 10.285%. This is acceptable for characterizing two different plate locations and is not evidence of sensor failure.
Y-axis | Excellent cross-location agreement: mean A2/A1 = 0.9850 and mean symmetric difference = 2.183% across all 12 qualified runs.
Z-axis | Systematic location-dependent response: mean A2/A1 = 1.1112; mean symmetric difference = 10.514%. Very low within-record CV shows this offset is stable/physical rather than random noise.
X-axis | Weakest component and lowest synchronous ratio. Only 9/12 points were quality-qualified; percentage differences are therefore less reliable and should not dominate M3 interpretation.
Pooled amplitude relationship | Strong linear relationship across qualified XYZ points: ADXL2_A = 1.115671·ADXL1_A − 0.103558, R² = 0.991788. The slope >1 reflects systematic local-response difference, not necessarily accelerometer gain error.
Final M3 conclusion | M3 is complete. The dual-ADXL chain is validated for common-frequency detection and repeatable narrowband measurement. Cross-location absolute amplitudes must be interpreted as local mechanical responses, not as a requirement for equality.

Sheet: Simple Run Table
Final M3 Run Table — Requested Frequency, Measured Frequency and Resultant Amplitude
Run | Commanded Frequency (Hz) | ADXL1 Frequency (Hz) | ADXL2 Frequency (Hz) | ADXL1 Resultant Amplitude (m/s²) | ADXL2 Resultant Amplitude (m/s²) | Run | |ADXL2-ADXL1| Frequency (Hz) | Resultant SymDiff (%)
1 | 268.000000 | 268.018438 | 268.033283 | 4.470147 | 4.670297 | 1 | 0.014845 | 4.379437148
2 | 268.000000 | 268.025227 | 268.023129 | 4.507902 | 4.694980 | 2 | 0.002098 | 4.065639438
3 | 268.000000 | 268.025295 | 268.032226 | 4.490005 | 4.760418 | 3 | 0.006931 | 5.846500209
4 | 268.000000 | 268.024035 | 268.028537 | 4.445474 | 4.778792 | 4 | 0.004502 | 7.226981529
5 | 268.000000 | 268.029665 | 268.019457 | 4.488425 | 4.825244 | 5 | 0.010208 | 7.232788711
6 | 268.000000 | 268.031417 | 268.028650 | 4.418816 | 4.835310 | 6 | 0.002767 | 9.001260627
7 | 268.000000 | 268.021410 | 268.021148 | 4.366385 | 4.775406 | 7 | 0.000262 | 8.94837784
8 | 268.000000 | 268.027846 | 268.020550 | 4.368759 | 4.820048 | 8 | 0.007296 | 9.822580886
9 | 268.000000 | 268.048820 | 268.049039 | 4.319815 | 4.786199 | 9 | 0.000219 | 10.24342813
10 | 268.000000 | 268.037342 | 268.021993 | 4.348750 | 4.810927 | 10 | 0.015349 | 10.09155672
11 | 268.000000 | 268.027011 | 268.027958 | 4.338376 | 4.796246 | 11 | 0.000947 | 10.0249359
12 | 268.000000 | 268.021414 | 268.023800 | 4.321661 | 4.790237 | 12 | 0.002386 | 10.28492637
Mean | 268.000000 | 268.028160 | 268.027481 | 4.407043 | 4.778675

Sheet: Full Run Data
run | valid | command_hz | actual_nco_hz | dac | f1_fft_hz | f2_fft_hz | f1_cmd_error_hz | f2_cmd_error_hz | delta_f_hz | fft_snr1_db | fft_snr2_db | A1_X | A1_Y | A1_Z | A1_VEC | A2_X | A2_Y | A2_Z | A2_VEC | relDiff_X_pct | relDiff_Y_pct | relDiff_Z_pct | relDiff_VEC_pct | ratio_VEC_A2_A1 | sync1 | sync2 | cv1_X_pct | cv1_Y_pct | cv1_Z_pct | cv2_X_pct | cv2_Y_pct | cv2_Z_pct | abs_delta_f_hz | abs_f1_cmd_error_hz | abs_f2_cmd_error_hz | vector_diff_calc_pct | ratio_X_qualified | ratio_Y_qualified | ratio_Z_qualified
1 | 1 | 268.000000 | 267.999999 | 19.000000 | 268.018438 | 268.033283 | 0.018439 | 0.033284 | 0.014845 | 33.107000 | 30.663000 | 0.347966 | 2.191520 | 3.880512 | 4.470147 | 0.420244 | 2.040762 | 4.179756 | 4.670297 | 18.817000 | 7.124000 | 7.425000 | 4.379000 | 1.044775 | 0.912200 | 0.929400 | 9.770000 | 3.581000 | 1.271000 | 7.770000 | 2.427000 | 1.443000 | 0.014845 | 0.018439 | 0.033284 | 123.216923 | 1.207716 | 0.931208 | 1.077115
2 | 1 | 268.000000 | 267.999999 | 19.000000 | 268.025227 | 268.023129 | 0.025228 | 0.023131 | -0.002098 | 32.898000 | 30.928000 | 0.322131 | 2.229248 | 3.904851 | 4.507902 | 0.410359 | 2.097619 | 4.180244 | 4.694980 | 24.090000 | 6.084000 | 6.812000 | 4.066000 | 1.041500 | 0.909300 | 0.925500 | 8.110000 | 3.496000 | 0.945000 | 10.478000 | 2.233000 | 0.800000 | 0.002098 | 0.025228 | 0.023131 | 136.947794 | 1.273889 | 0.940954 | 1.070526
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
12 | 1 | 268.000000 | 267.999999 | 19.000000 | 268.021414 | 268.023800 | 0.021415 | 0.023801 | 0.002386 | 32.763000 | 28.211000 | 0.294395 | 1.951249 | 3.844830 | 4.321661 | 0.278112 | 1.975214 | 4.355175 | 4.790237 | 5.688000 | 1.221000 | 12.447000 | 10.285000 | 1.108425 | 0.896200 | 0.926400 | 5.971000 | 3.900000 | 0.631000 | 8.604000 | 1.062000 | 0.813000 | 0.002386 | 0.021415 | 0.023801 | 27.300405 | 0.944690 | 1.012282 | 1.132735

Sheet: Axis Analysis
Axis-by-Axis M3 Analysis — Final 12 Runs
Axis | Qualified points | Mean ADXL1 (m/s²) | Mean ADXL2 (m/s²) | Mean A2/A1 | Mean SymDiff (%) | Mean CV ADXL1 (%) | Mean CV ADXL2 (%)
X | 9 | 0.281 | 0.321 | 1.138 | 14.255 | 8.234 | 8.468
Y | 12 | 2.067 | 2.034 | 0.985 | 2.182 | 2.861 | 1.848
Z | 12 | 3.881 | 4.313 | 1.111 | 10.514 | 0.711 | 0.709
Resultant | 12 | 4.407 | 4.779 | 1.085 | 8.097 | 1.610 | 1.050
Trend | Interpretation
X | Smallest/weakest component. Sync is much lower than Y/Z, and runs 8, 9, 11 were flagged LOW/UNSTABLE_COMPONENT. Relative percentage disagreement is therefore amplified.
Y | Best cross-location amplitude agreement. Ratio stays close to unity and both channels have low within-record CV.
Z | Dominant axis. ADXL2 is systematically higher at its plate location, but both sensors show exceptionally low CV. This is consistent with a real spatial response difference.
Resultant | Mean symmetric difference stays below the predeclared 10% criterion (8.097%). Ratio changes gradually from ~1.045 early to ~1.108 late, indicating mild mechanical settling/redistribution rather than measurement-chain failure.

Sheet: Quality & Integrity
Measurement Quality and Acquisition Integrity
Metric | Final result | Assessment
Valid runs | 12 / 12 | PASS
ADXL1 mean FFT SNR | 32.882 dB | Strong
ADXL2 mean FFT SNR | 30.062 dB | Strong
Mean |ADXL2 f - ADXL1 f| | 0.005651 Hz | Excellent
Maximum |ADXL2 f - ADXL1 f| | 0.015348 Hz | Excellent
Mean weighted sync ADXL1 | 0.9040 | Strong
Mean weighted sync ADXL2 | 0.9294 | Strong
Zero-triplet corruption | 0 in all final runs | PASS
Clipping | 0 in all final runs | PASS
Stagnant samples | maximum reported = 1 | PASS
Quadrature duration | ~1599.44–1599.45 ms | As expected for 2560 samples @ 1600 Hz
Important methodological note | Meaning
Amplitude equality | Not required across different physical locations of the Visaton plate; local modal/bending/rocking response can produce legitimate amplitude differences.
Cross-sensor phase | Not used as an M3 acceptance metric because the two ADXL345s do not have hardware-synchronised sample clocks.
Frequency regression | Do not interpret the single-frequency frequency-scatter regression slope/R² as a calibration metric; all measurements are clustered near one controlled frequency.
Amplitude regression | Pooled qualified XYZ regression R² = 0.991788 shows a very strong linear relationship; slope = 1.115671 represents systematic cross-location response difference.
Use in later tests | Treat each accelerometer as a local measurement channel at its own physical point. Do not apply a global amplitude correction factor based on M3.

Sheet: Thesis Notes
Thesis-Ready M3 Documentation Notes
Recommended status | M3 — DONE / FROZEN
Purpose | To verify consistency of two ADXL345 measurement channels under a common controlled narrowband excitation generated by the Visaton actuator.
Excitation | 268 Hz commanded; actual NCO ≈ 267.999999 Hz; DAC sine peak 19; 12 independent actuator ON/OFF cycles.
Frequency result | ADXL1 mean = 268.028160 Hz; ADXL2 mean = 268.027481 Hz. Mean absolute inter-sensor difference = 0.005651 Hz; maximum = 0.015348 Hz.
Amplitude result | Mean resultant amplitudes: ADXL1 = 4.407043 m/s², ADXL2 = 4.778675 m/s². Mean resultant ratio A2/A1 = 1.084663; mean symmetric difference = 8.097%.
Spatial-response interpretation | Because the accelerometers occupy different locations on the Visaton plate, equal amplitudes are not expected. The axis-dependent differences are interpreted as local structural response plus any sensor/mounting variation, not automatically as sensor error.
Strongest agreement | Y axis: mean A2/A1 = 0.9850; mean symmetric difference = 2.183%.
Dominant systematic difference | Z axis: mean A2/A1 = 1.1112; mean symmetric difference = 10.514%, while within-record CV is only ~0.71% for both sensors. The difference is stable and therefore consistent with a physical location effect.
Weak-axis caution | X is the weakest component and has lower synchronisation; only 9/12 X comparisons were quality-qualified. X percentage errors should not dominate the thesis verdict.
Repeatability | Across runs, resultant CV = 1.61% for ADXL1 and 1.05% for ADXL2. The latter half of the campaign is even more stable, indicating mild initial mechanical settling.
Final conclusion | The M3 goal is achieved: both channels identify the same controlled vibration frequency with high precision, strong SNR, repeatable narrowband response and clean acquisition. The test does not establish cross-location amplitude equality, and such equality is not required for the later tool-side/hand-side architecture.
