Krish28062000/Active-vibration-control-hand-exoskeleton/data/02_actuator_characterization/m6_m8_broadband_dataset.xlsx

Sheet: Executive_Summary
KK Exoskeleton — M6/M8 & Broadband Characterization Master Dataset
Item | Frozen interpretation | Key metric | Value
Primary control-band dataset | 12 runs, 240–320 Hz, complete locked f0 tool/hand measurements | Narrowband runs | 12
Broadband characterization dataset | 8 runs, 20–750 Hz, multi-frequency source characterization | Mean locked f0 (Hz) | 268.545
M6 verdict | DONE — frequency family is repeatable but not perfectly fixed; tracking is required | SD f0 (Hz) | 1.185
M8 verdict | DONE — repeated tool/hand baseline at the same f0 is complete at resultant and local-axis level | f0 range (Hz) | 4.604
Coordinate-system caveat | Tool and hand axes are rotated; do not interpret X/X, Y/Y, Z/Z ratios as directional transmissibility | f0 CV (%) | 0.441
Primary scalar transfer metric | Use Hand resultant / Tool resultant at the same f0 as baseline spatial amplitude ratio | Mean tool resultant @ f0 (m/s² peak) | 2.872
 |  | Mean hand resultant @ f0 (m/s² peak) | 1.530
 |  | Mean H/T resultant ratio | 0.537
Thesis interpretation / decision
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
