Krish28062000/Active-vibration-control-hand-exoskeleton/data/01_sensor_validation/tool_hand_frequency_amplitude_9_runs.xlsx

Sheet: Results Table
Tool–Hand Frequency and Amplitude Comparison Across Experimental Runs
Tool ON, Visaton OFF | ADXL1: tool reference | ADXL2: back-of-hand error sensor | f = frequency (Hz), A = peak acceleration (m/s²)
Run | Tool X f / A | Tool Y f / A | Tool Z f / A | Tool f₀ Candidate (Hz) | Status | Hand X f / A | Hand Y f / A | Hand Z f / A | Hand X @ f₀ | Hand Y @ f₀ | Hand Z @ f₀ | Hand Vector @ f₀
1 | 267.559 / 2.767 | 267.546 / 1.498 | 196.737 / 0.957 | 267.326 | LOCKED | 267.577 / 0.965 | 267.630 / 0.849 | 267.433 / 0.401 | 0.928 | 0.840 | 0.407 | 1.316
2 | 267.095 / 2.846 | 267.112 / 1.566 | 734.230 / 0.890 | 267.212 | LOCKED | 267.130 / 0.905 | 267.089 / 0.856 | 267.262 / 0.410 | 0.925 | 0.854 | 0.395 | 1.319
3 | 269.016 / 2.590 | 190.009 / 1.773 | 189.997 / 1.172 | 268.691 | NOT LOCKED | 538.157 / 0.713 | 269.079 / 0.764 | 268.902 / 0.361 | — | — | — | 1.189
4 | 268.564 / 2.534 | 268.557 / 1.681 | 193.291 / 1.015 | 269.139 | NOT LOCKED | 536.994 / 0.775 | 268.478 / 0.707 | 268.614 / 0.453 | — | — | — | 1.208
5 | 268.647 / 2.415 | 268.681 / 1.807 | 268.663 / 0.897 | 268.705 | LOCKED | 268.639 / 0.891 | 268.672 / 0.755 | 192.113 / 0.163 | 1.070 | 0.753 | 0.312 | 1.345
6 | 268.046 / 2.252 | 268.056 / 1.612 | 268.038 / 0.751 | 267.701 | LOCKED | 268.128 / 1.061 | 268.096 / 0.633 | 282.975 / 0.169 | 1.128 | 0.779 | 0.209 | 1.387
7 | 268.545 / 2.444 | 268.544 / 1.780 | 461.005 / 0.975 | 268.410 | LOCKED | 268.538 / 1.151 | 268.512 / 0.767 | 134.322 / 0.181 | 1.191 | 0.813 | 0.150 | 1.450
8 | 271.992 / 1.379 | 272.045 / 1.811 | 173.406 / 0.868 | 272.492 | NOT LOCKED | 271.988 / 1.044 | 272.008 / 0.575 | 271.791 / 0.248 | — | — | — | 1.302
9 | 270.288 / 1.705 | 184.383 / 1.783 | 184.297 / 1.128 | 269.607 | NOT LOCKED | 270.275 / 0.860 | 270.284 / 0.674 | 270.195 / 0.391 | — | — | — | 1.103

Sheet: Structured Data
Run | Tool X Frequency (Hz) | Tool X Amplitude (m/s²) | Tool Y Frequency (Hz) | Tool Y Amplitude (m/s²) | Tool Z Frequency (Hz) | Tool Z Amplitude (m/s²) | Tool f0 Candidate (Hz) | Status | Hand X Dominant Frequency (Hz) | Hand X Dominant Amplitude (m/s²) | Hand Y Dominant Frequency (Hz) | Hand Y Dominant Amplitude (m/s²) | Hand Z Dominant Frequency (Hz) | Hand Z Dominant Amplitude (m/s²) | Hand X Amplitude @ f0 (m/s²) | Hand Y Amplitude @ f0 (m/s²) | Hand Z Amplitude @ f0 (m/s²) | Hand Vector Amplitude @ f0 (m/s²)
1 | 267.559 | 2.767 | 267.546 | 1.498 | 196.737 | 0.957 | 267.326 | LOCKED | 267.577 | 0.965 | 267.630 | 0.849 | 267.433 | 0.401 | 0.928 | 0.840 | 0.407 | 1.316
2 | 267.095 | 2.846 | 267.112 | 1.566 | 734.230 | 0.890 | 267.212 | LOCKED | 267.130 | 0.905 | 267.089 | 0.856 | 267.262 | 0.410 | 0.925 | 0.854 | 0.395 | 1.319
3 | 269.016 | 2.590 | 190.009 | 1.773 | 189.997 | 1.172 | 268.691 | NOT LOCKED | 538.157 | 0.713 | 269.079 | 0.764 | 268.902 | 0.361 |  |  |  | 1.189
4 | 268.564 | 2.534 | 268.557 | 1.681 | 193.291 | 1.015 | 269.139 | NOT LOCKED | 536.994 | 0.775 | 268.478 | 0.707 | 268.614 | 0.453 |  |  |  | 1.208
5 | 268.647 | 2.415 | 268.681 | 1.807 | 268.663 | 0.897 | 268.705 | LOCKED | 268.639 | 0.891 | 268.672 | 0.755 | 192.113 | 0.163 | 1.070 | 0.753 | 0.312 | 1.345
6 | 268.046 | 2.252 | 268.056 | 1.612 | 268.038 | 0.751 | 267.701 | LOCKED | 268.128 | 1.061 | 268.096 | 0.633 | 282.975 | 0.169 | 1.128 | 0.779 | 0.209 | 1.387
7 | 268.545 | 2.444 | 268.544 | 1.780 | 461.005 | 0.975 | 268.410 | LOCKED | 268.538 | 1.151 | 268.512 | 0.767 | 134.322 | 0.181 | 1.191 | 0.813 | 0.150 | 1.450
8 | 271.992 | 1.379 | 272.045 | 1.811 | 173.406 | 0.868 | 272.492 | NOT LOCKED | 271.988 | 1.044 | 272.008 | 0.575 | 271.791 | 0.248 |  |  |  | 1.302
9 | 270.288 | 1.705 | 184.383 | 1.783 | 184.297 | 1.128 | 269.607 | NOT LOCKED | 270.275 | 0.860 | 270.284 | 0.674 | 270.195 | 0.391 |  |  |  | 1.103

Sheet: Notes
Documentation Notes
Item | Definition / Interpretation
Tool X/Y/Z f / A | Independent dominant FFT peak frequency and its peak acceleration amplitude on ADXL1 attached to the tool.
Tool f₀ Candidate | Refined triaxial tool candidate frequency selected by the FFT + quadrature validation stage.
Hand X/Y/Z f / A | Independent dominant FFT peak frequency and peak acceleration amplitude on ADXL2 at the back of the hand.
Hand X/Y/Z @ f₀ | Exact-frequency quadrature amplitude on each hand axis at the selected tool candidate frequency. Values are only available when the analyser formally locked f₀.
Hand Vector @ f₀ | Triaxial vector amplitude at the selected tool candidate: √(X² + Y² + Z²).
LOCKED | Candidate passed auto-selection criteria and full per-axis amplitude-at-f₀ output was exported.
NOT LOCKED | Candidate was recommended but the analyser reported ambiguity; individual X/Y/Z @ f₀ values were therefore not exported.
Source | Experimental serial-log dataset supplied by the user, 14 August 2026.
