Krish28062000/Active-vibration-control-hand-exoskeleton/data/02_actuator_characterization/visaton_3axis_characterization.xlsx

Sheet: Executive Summary
Visaton EX 45 S — 3-Axis Standalone Characterization
Thesis-ready analysis of the user-provided fixed-frequency DAC characterization log (100–350 Hz, DAC 10–15, one independent record per DAC point).
Dataset KPI | Value | High-confidence conclusions supported by this dataset
Source file | Pasted text(20260811-184604).txt | 1. Frequency generation and vector-frequency identification are excellent: all accepted points remain extremely close to the commanded frequency.
Frequencies tested | 11 | 2. The installed actuator response is genuinely frequency dependent in direction; no single fixed X/Y/Z direction describes the complete 100–350 Hz range.
DAC levels per frequency | 6 | 3. 100 Hz changes from Z-dominant at DAC 10–11 to X-dominant from DAC 12 upward, accompanied by a strong ≈200 Hz second harmonic.
Total measurement points | 66 | 4. 125 Hz is consistently Y-dominant over DAC 10–15; a strong ≈375 Hz third-harmonic component appears on Z at higher DAC.
Independent repeats per DAC | 1 | 5. 150 Hz transitions from Z-dominant to Y-dominant near DAC 14 and shows a large amplitude jump around DAC 12→13, indicating amplitude-dependent/nonlinear behavior.
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
