Krish28062000/Active-vibration-control-hand-exoskeleton/firmware/05_fxlms_final/fxlms_v1_4r_auto60/fxlms_v1_4r_auto60.ino

/*
  ============================================================================
  KK-EXOSKELETON - INTEGRATED NARROWBAND FFT/QUADRATURE + V5.1R MATCHER
  + QUICK TRIAXIAL DAC AUTHORITY SWEEP + SINGLE-FREQUENCY COMPLEX FXLMS V1.4R AUTO60 AXIS CHARACTERIZATION
  ============================================================================

  V1.4R AUTO60 VALIDATION CHANGE
    The proven V1.4 selected-axis FxLMS controller is retained. Fresh baseline
    acquisition may now retry transiently rejected blocks (up to 10 attempts
    to obtain the original 5 good windows, original >=4 minimum preserved).
    After the normal 10-s independent frozen-W validation, if the SELECTED AXIS
    itself achieves >=20% attenuation, the firmware automatically continues
    for an additional 60 s with the SAME frozen Wbest and live ADXL1 reference.
    No user command is required between the 10-s and 60-s stages. Vector remains
    diagnostic telemetry only and is NOT used for W selection or AUTO60 trigger.

  V1.4 AXIS-CHARACTERIZATION CHANGE
    The V1.3 secondary-path identification, live-reference tracking, complex
    normalized FxLMS update, STARTUP/LEARN/FINE/HOLD states, DAC ceiling,
    saturation handling, error-quality holds and frozen validation are retained.
    Wbest qualification is now based on sustained attenuation of the MANUALLY
    SELECTED X/Y/Z error axis only. X/Y/Z/vector amplitudes are still measured
    and logged continuously, but ordinary 10-20% vector deterioration no longer
    rejects Wbest, slows adaptation, or terminates an axis-characterization run.
    The existing >150% baseline-growth guard and absolute software guards remain
    as emergency protection. This mode characterizes single-axis capability and
    cross-axis redistribution; it is NOT the future triaxial-energy controller.

  V1.3 BASE RETAINED
    The V1.2 secondary-path identification and core complex normalized FxLMS
    equation are retained. V1.3 adds a supervisory layer: STARTUP/LEARN/FINE/
    HOLD states, rolling system-level Wbest retention, vector-aware supervision,
    temporary error-quality hold instead of 0.48-s abort, a baseline/S_hat-based
    live-control ceiling independent of the identification probe, complete reject
    logging, frozen-W validation using new data, and optional A-B-A-B causal
    validation with command b.

  V1.2 SECONDARY-ID CHANGE RETAINED
    The validated d (quick DAC sweep) and c (V5.1R amplitude matcher) remain
    OPTIONAL diagnostics for FxLMS. The secondary-path command i is now made
    robust against the exact V1.1 failure observed experimentally: it surveys
    safe probe levels, ranks coherent candidates, uses five-window robust
    statistics, retries one unstable phase measurement, and falls back to the
    next-ranked candidate instead of aborting immediately. The normal workflow:

      TOOL ON  -> a
      choose   -> x / y / z
      TOOL OFF -> i
      TOOL ON  -> l 20

    Optional diagnostic path:
      a -> d -> x/y/z -> c -> i -> l 20

  PURPOSE
    Preserve the validated Stage-A narrowband FFT/quadrature discovery, quick
    triaxial DAC authority sweep, V5.1R amplitude matcher, legacy tracked phase
    sweep, dual-ADXL SPI path, safety logic and 10 kHz phase-continuous NCO.
    FxLMS minimizes the live ADXL2 selected-axis residual without requiring an
    actuator-only amplitude match while the tool is running.

  SECONDARY-PATH IDENTIFICATION WITHOUT c - V1.2 ROBUST SEARCH
    Command i no longer stops at the first barely acceptable actuator probe.
    It surveys safe DAC levels 5..21, measures five windows per level, removes
    one clearly inconsistent window when possible, ranks coherent candidates,
    then performs robust 0/90/0 secondary-path identification. A failed phase
    is retried once; if it remains unstable, i automatically falls back to the
    next-ranked probe. d and c remain optional diagnostics.

  IMPORTANT
    - d and c remain available and unchanged as diagnostics/thesis-development
      tools.
    - legacy command w still requires c, because that experiment deliberately
      starts from the matched fixed-amplitude state.
    - FxLMS command amplitude and phase are determined by the complex weight W
      and the live normalized ADXL1 reference phasor r: U = W*r.
    - ADXL2 X/Y/Z and vector are still logged continuously.
    - If mounting/hand mechanics change materially, re-run i before l.
  ============================================================================
*/

#include <Arduino.h>
#include <SPI.h>
#include <arduinoFFT.h>
#include <math.h>
#include <ctype.h>
#include <stdlib.h>
#include <string.h>

/*
  ============================================================================
  KK-EXOSKELETON - UNIVERSAL XYZ ADAPTIVE AMPLITUDE MATCHER V5.1R ROBUST LOCAL-REBRACKET - ARDUINO 1.8.x COMPILE FIX
  ESP32 Arduino Core 3.x + ADXL345 SPI + TPA3116D2 + Visaton EX 45 S
  ============================================================================

  DESIGN GOAL
    Reliably acquire and regulate one selected exact-frequency acceleration
    component (X, Y or Z) even when the physical DAC -> acceleration mapping
    drifts between runs or slowly changes during a run.

  FINAL ARCHITECTURE
    1) phase-continuous 10 kHz hardware-timer NCO;
    2) exact-command-frequency NCO-referenced X/Y/Z I/Q measurement;
    3) robust same-DAC repeated-point validation;
    4) hybrid sign-bracketed root finder (secant/regula-falsi + bisection);
    5) robust local dA/dDAC slope memory;
    6) slow, conservative PI amplitude servo around the continuously running NCO;
    7) automatic transient confirmation and bounded reacquisition;
    8) closed-loop amplitude-hold statistics with quantization-aware regulation;
    9) final triaxial vector FFT frequency verification;
   10) V5.1 candidate confirmation + state-aware plant-change guard;
   11) verified trial/revert DAC corrections;
   12) conservative warm-start from the last proven same-condition solution;
   13) bounded local re-bracketing after a moved bracket, before any full restart.

  IMPORTANT CONTROL PRINCIPLE
    DAC is NOT the controlled physical quantity.
    The selected exact-frequency acceleration is controlled.
    Therefore DAC is allowed to move slowly during closed-loop regulation.

  IMPORTANT PHASE PRINCIPLE
    Frequency/phase generation never restarts while matching or tracking.
    Amplitude table changes occur only at NCO phase wrap (near sine zero),
    avoiding a mid-cycle amplitude discontinuity.

  IMPORTANT MEASUREMENT PRINCIPLE
    The same canonical estimator is used throughout acquisition and regulation:
      3 windows x 512 samples/window at 1600 samples/s.
    Timing-bad windows are discarded individually; clean windows remain usable.
    Amplitude validity is determined from the exact-frequency amplitude estimator,
    repeatability, sensor integrity and stability. Phase/Sync diagnostics do not gate
    amplitude acquisition or amplitude-hold PASS.

  IMPORTANT MEMORY PRINCIPLE
    All large FFT/sample buffers are global/static. No large search/history arrays
    are placed on the ESP32 loop-task stack. Closed-loop statistics use running
    accumulators instead of large local arrays. This directly avoids the stack
    corruption that produced the previous "Double exception" Guru Meditation.

  HARDWARE
    ADXL1 CS GPIO5   : forced HIGH, not read
    ADXL2 CS GPIO17  : rigidly mounted to Visaton/final actuator plate
    SPI SCK GPIO18
    SPI MISO GPIO19
    SPI MOSI GPIO23
    ADXL SPI: 5 MHz, MSBFIRST, SPI_MODE3 (preserved from working V4)
    ESP32 DAC GPIO25 -> TPA3116D2 -> Visaton EX 45 S

  SERIAL COMMANDS (115200 baud, Newline)
    f 268       set frequency [20...350 Hz]
    t 1.20      set selected-axis target peak acceleration [m/s^2]
    x / y / z   select control axis
    h 8         set closed-loop hold duration [5...30 s]
    n 5         set number of independent full runs [1...8]

    r           one COMPLETE run:
                acquire -> servo lock -> closed-loop hold -> FFT -> stop
    v           N independent COMPLETE runs

    m           acquire + servo lock only; leave actuator running
    k 30        track current acquired target for 5...600 s
    q 15        fixed-DAC 3-record diagnostic at DAC 15
    g           final local triaxial FFT at current running command

    p           settings/status
    s           emergency stop
    ?           help

  RECOMMENDED FIRST VALIDATION
    f 272
    t 1.20
    z
    h 8
    n 1
    r

  Then, without moving the setup:
    n 5
    v
  ============================================================================
*/

// ============================================================================
// DATA TYPES
// ============================================================================

enum class ControlAxis : uint8_t { X_AXIS = 0, Y_AXIS = 1, Z_AXIS = 2 };

enum class AcquireStatus : uint8_t {
  OK,
  QUANTIZATION_LIMITED,
  TARGET_BELOW_RANGE,
  TARGET_ABOVE_RANGE,
  NONSTATIONARY,
  HARDWARE_FAULT,
  SAFETY_STOP,
  ABORTED
};

enum class ServoStatus : uint8_t {
  LOCKED,
  COMPLETED,
  NEEDS_REACQUIRE,
  AUTHORITY_LIMIT,
  HARDWARE_FAULT,
  SAFETY_STOP,
  ABORTED
};

enum class PhaseClass : uint8_t { STRONG, MODERATE, WEAK };

struct RawAcceleration {
  int16_t x;
  int16_t y;
  int16_t z;
};

struct AxisSyncResult {
  double amplitudeMs2;
  double phaseDeg;
  double syncRatio;
};

struct WindowResult {
  bool valid;
  bool communicationFault;
  bool rawClipped;
  bool timingFault;
  uint16_t zeroTriplets;
  uint16_t longestStagnantRun;
  uint32_t lateSamples;
  uint32_t maxLatenessUs;
  AxisSyncResult axis[3];
  double totalAmplitudeMs2;
};

struct ControlRecord {
  bool measured;
  bool amplitudeValid;
  bool phaseReadyStrong;
  bool communicationFault;
  bool rawClipped;
  bool safetyExceeded;
  bool timingRejected;
  uint8_t validWindows;
  uint8_t inlierCount;
  bool windowValid[3];
  double windowSelectedMs2[3];
  double dac;
  uint32_t timestampMs;

  double selectedMedianMs2;
  double selectedMeanMs2;
  double axisMeanMs2[3];
  double axisSync[3];
  double axisPhaseDeg[3];
  double selectedPhaseSdDeg;
  double totalMeanMs2;
  double madPercent;
  double cvPercent;
};

struct StablePoint {
  bool valid;
  bool stationary;
  bool phaseReadyStrong;
  bool safetyExceeded;
  bool hardwareFault;
  double dac;
  double amplitudeMs2;
  double pairDriftPercent;
  uint8_t recordsUsed;
  uint32_t timestampMs;
  double axisMeanMs2[3];
  double axisSync[3];
  double axisPhaseDeg[3];
  double totalMeanMs2;
  double selectedPhaseSdDeg;
};

struct AcquisitionResult {
  AcquireStatus status;
  bool success;
  StablePoint candidate;
  StablePoint low;
  StablePoint high;
  uint16_t recordsMeasured;
  uint16_t qualityRejects;
  uint8_t restarts;
  uint32_t elapsedMs;
};

struct PlantBaseline {
  bool valid;
  double dac;
  double selectedMs2;
  double selectedCvPercent;
  double axisMeanMs2[3];
  double totalMeanMs2;
};

struct WarmStartMemory {
  bool valid;
  ControlAxis axis;
  double frequencyHz;
  double targetMs2;
  double dac;
};

struct ServoState {
  double integralErrorMs2;
  int8_t persistentSign;
  uint8_t persistenceCount;
  uint8_t invalidCount;
  uint8_t unproductiveCorrections;

  // V5.1: a small same-DAC plant fingerprint established only from
  // confirmed stable records. It is a state detector, not a calibration map.
  PlantBaseline plantBaseline;

  // V5.1: every DAC correction is a bounded trial. Two post-step records
  // verify improvement before the new DAC is accepted and its slope is learned.
  bool trialPending;
  double trialOldDac;
  double trialOldAmp;
  double trialOldErrorPct;
  PlantBaseline trialOldBaseline;
  uint8_t trialValidCount;
  double trialAmp[2];
  double trialAxisSum[3];
  double trialTotalSum;
  double trialMaxCvPercent;

  bool havePrevious;
  ControlRecord previous;
};

struct RunningStats {
  uint16_t n;
  double mean;
  double m2;
  double minValue;
  double maxValue;
};

struct HoldResult {
  bool completed;
  bool amplitudePass;
  bool phaseSweepReady;
  ServoStatus status;
  uint16_t validRecords;
  uint16_t tightInBandRecords;
  uint16_t finalInBandRecords;
  uint16_t corrections;
  uint16_t reacquireEvents;

  double meanAmplitudeMs2;
  double sdAmplitudeMs2;
  double cvPercent;
  double meanErrorPercent;
  double tightInBandPercent;
  double finalInBandPercent;
  double rmsErrorPercent;
  double maxAbsErrorPercent;

  double meanSyncRatio;
  double phaseSpanDeg;
  double minAmplitudeMs2;
  double maxAmplitudeMs2;
  double minDac;
  double maxDac;
  double meanDac;
  PhaseClass phaseClass;
};

struct VectorFftResult {
  bool valid;
  double frequencyHz;
  double xAmplitudeMs2;
  double yAmplitudeMs2;
  double zAmplitudeMs2;
  double totalAmplitudeMs2;
  double snrDb;
  char dominantAxis;
};

struct CompleteRunResult {
  bool completed;
  bool amplitudePass;
  bool cancellationReady;
  bool matchLockAchieved;
  uint32_t matchLockTimeMs;
  uint32_t totalRunTimeMs;
  double finalDac;
  AcquisitionResult acquisition;
  HoldResult hold;
  VectorFftResult fft;
};


// ============================================================================
// INTEGRATED NARROWBAND DISCOVERY TYPES
// ============================================================================

struct DiscoveryTiming {
  uint32_t elapsedUs;
  double meanReadSeparationUs;
  uint32_t maxReadSeparationUs;
  uint32_t maxScheduleLatenessUs;
  uint32_t lateSampleCount;
  uint16_t zeroTriplets;
  uint16_t clippedSamples;
  bool valid;
};

struct DiscoveryAxisFFTResult {
  bool valid;
  uint16_t bin;
  double frequencyHz;
  double amplitudeMs2;
  double snrDb;
};

struct DiscoverySensorFFTResult {
  DiscoveryAxisFFTResult axis[3];
};

struct DiscoveryAxisQuadResult {
  bool valid;
  double referenceHz;
  double correctionHz;
  double refinedHz;
  double amplitudeMs2;
  double phaseDeg;

  // Whole-record synchronous ratio is retained as a DIAGNOSTIC only.  A
  // hand-held tool can drift in frequency/phase over the 1.6 s record, so
  // this quantity is deliberately NOT the primary acceptance gate in V1.3.
  double syncRatio;

  // Drift-tolerant synchronization: synchronous ratio is calculated inside
  // each 256-sample (~160 ms) block and the median is used for quality gating.
  double localMedianSyncRatio;
  uint8_t localGoodBlocks;

  double phaseFitRmseDeg;
};

struct DiscoverySensorAtF0 {
  DiscoveryAxisQuadResult axis[3];
  double vectorAmplitudeMs2;
  double J;
};

struct DiscoveryCandidate {
  bool fftValid;
  bool quadValid;
  uint8_t fftRank;
  uint16_t bin;
  double fftSeedHz;
  double fftVectorAmplitudeMs2;
  double fftSnrDb;
  double refinedHz;
  double toolVectorAmplitudeMs2;
  double handVectorAmplitudeMs2;

  // Long-record sync is retained for reporting; local sync is the principal
  // drift-tolerant quality metric used by the V1.3 discovery gate.
  double toolWeightedSync;
  double toolWeightedLocalSync;
  double toolWeightedPhaseRmseDeg;
  uint8_t supportAxes;

  // Independent FFT peak consensus around the candidate.  This prevents a
  // low-sync but clearly repeated X/Y/hand frequency family from being called
  // "ambiguous", while still rejecting isolated/spurious candidates.
  uint8_t toolFrequencyConsensusAxes;
  uint8_t handFrequencyConsensusAxes;

  double qualityScore;
  DiscoverySensorAtF0 toolAtCandidate;
  DiscoverySensorAtF0 handAtCandidate;
};

enum class IntegratedWorkflowState : uint8_t {
  NEED_BASELINE,
  AWAIT_AXIS,
  AWAIT_TOOL_OFF,
  MATCHING,
  AWAIT_PHASE_TOOL_ON,      // legacy tracked phase-sweep entry after c
  PHASE_SWEEP_RUNNING,
  AWAIT_SECONDARY_ID,       // TOOL OFF -> run i
  FXLMS_READY,              // secondary path identified; TOOL ON -> run l
  FXLMS_RUNNING
};

struct QuickDacPoint {
  bool valid;
  double dac;
  double axisMeanMs2[3];
  double axisCvPercent[3];
  double axisSync[3];
  double vectorMeanMs2;
};

struct PhaseHoldPoint {
  bool valid;
  double commandPhaseDeg;
  uint8_t validSamples;
  double selectedMeanMs2;
  double selectedSdMs2;
  double selectedCvPercent;
  double selectedMinMs2;
  double selectedMaxMs2;
  double axisMeanMs2[3];
  double axisCvPercent[3];
  double vectorMeanMs2;
  double vectorCvPercent;
  double selectedReductionPercent;
  double vectorChangePercent;
  double axisChangePercent[3];
};

// V2.0 Stage-C types: paired ADXL1/ADXL2 acquisition and tool-referenced tracking.
struct PairedTrackingWindow {
  bool valid;
  bool communicationFault;
  bool rawClipped;
  bool timingFault;
  uint32_t lateSamples;
  uint32_t maxLatenessUs;
  uint32_t centerUs;
  double commandOffsetMidDeg;
  AxisSyncResult toolAxis[3];
  AxisSyncResult handAxis[3];
  double handVectorMs2;
};

struct PhaseTrackerState {
  bool initialized;
  uint8_t referenceAxis;
  double lastToolPhaseDeg;
  uint32_t lastCenterUs;
  double filteredFrequencyErrorHz;
  uint16_t validUpdates;
  uint16_t rejectedUpdates;
};

struct TrackedPhasePoint {
  bool valid;
  double targetRelativePhaseDeg;
  uint8_t referenceAxis;
  uint8_t validSamples;
  double selectedMeanMs2;
  double selectedSdMs2;
  double selectedCvPercent;
  double selectedMinMs2;
  double selectedMaxMs2;
  double axisMeanMs2[3];
  double axisCvPercent[3];
  double vectorMeanMs2;
  double vectorCvPercent;
  double selectedReductionPercent;
  double vectorChangePercent;
  double axisChangePercent[3];
  double trackingErrorMeanDeg;
  double trackingErrorSdDeg;
  double trackingErrorMaxAbsDeg;
  double meanToolSync;
  double meanToolAmplitudeMs2;
};

// ============================================================================
// SINGLE-FREQUENCY COMPLEX FXLMS TYPES (V1.0)
// ============================================================================

struct FxComplex {
  double re;
  double im;
};

struct FxSecondaryPathProbe {
  bool valid;
  double commandPhaseDeg;
  uint8_t validWindows;
  double meanResponseMs2;
  double meanSync;
  double gainMs2PerDac;
  double phaseDeg;
  double gainCvPercent;
  double phaseSdDeg;
};

struct FxBaseline {
  bool valid;
  uint8_t validWindows;
  double axisMeanMs2[3];
  double vectorMeanMs2;
  double selectedMeanMs2;
  double referenceMeanMs2;
};

struct FxValidationResult {
  bool valid;
  uint16_t validWindows;
  double axisMeanMs2[3];
  double axisCvPercent[3];
  double vectorMeanMs2;
  double vectorCvPercent;
  double selectedMeanMs2;
  double selectedCvPercent;
  double selectedReductionPercent;
  double vectorReductionPercent;
};

// V1.3 supervisory state. The core complex FxLMS equation remains unchanged.
enum class FxAdaptiveState : uint8_t {
  STARTUP,
  LEARN,
  FINE,
  HOLD
};

struct FxRollingPerformance {
  double selectedReductionPct[5];
  double vectorReductionPct[5];
  FxComplex appliedW[5];
  uint8_t count;
  uint8_t head;
};

struct FxRollingSummary {
  bool full;
  double meanSelectedReductionPct;
  double meanVectorReductionPct;
  uint8_t positiveSelectedBlocks;
  uint8_t positiveVectorBlocks;
  uint8_t deepSelectedBlocks;
};

struct FxCausalSegmentResult {
  bool valid;
  uint16_t validWindows;
  double axisMeanMs2[3];
  double vectorMeanMs2;
  double referenceMeanMs2;
};


// ============================================================================
// HARDWARE
// ============================================================================

static const uint8_t PIN_CS_ADXL1 = 5;
static const uint8_t PIN_CS_ADXL2 = 17;
static const uint8_t PIN_SPI_SCK = 18;
static const uint8_t PIN_SPI_MISO = 19;
static const uint8_t PIN_SPI_MOSI = 23;
static const uint8_t PIN_VISATON_DAC = 25;

static const uint8_t REG_DEVID = 0x00;
static const uint8_t REG_BW_RATE = 0x2C;
static const uint8_t REG_POWER_CTL = 0x2D;
static const uint8_t REG_DATA_FORMAT = 0x31;
static const uint8_t REG_DATAX0 = 0x32;
static const uint8_t SPI_READ_BIT = 0x80;
static const uint8_t SPI_MB_BIT = 0x40;
static const uint8_t ADXL_DEVID_OK = 0xE5;

SPISettings adxlSpiSettings(5000000, MSBFIRST, SPI_MODE3);

// ============================================================================
// SENSOR / SAMPLE SETTINGS
// ============================================================================

static const double SAMPLE_RATE_HZ = 1600.0;
static const uint32_t SAMPLE_PERIOD_US = 625;

// Allow small scheduler/SPI jitter. A whole window is rejected only if more
// than a few samples exceed this threshold.
static const uint32_t LATE_SAMPLE_WARNING_US = 25;
static const uint8_t MAX_LATE_SAMPLES_PER_WINDOW = 4;

static const double ADXL_G_PER_LSB = 0.0039;
static const double GRAVITY_MS2 = 9.80665;
static const double ADXL_MS2_PER_LSB = ADXL_G_PER_LSB * GRAVITY_MS2;

// ADXL345 full-resolution +/-16 g is ~ +/-4100 counts, NOT +/-32768 counts.
// 4000 is therefore a useful conservative clipping warning threshold.
static const int16_t ADXL_RAW_CLIP_LIMIT = 4000;
static const uint16_t MAX_ZERO_TRIPLETS = 5;
static const uint16_t MAX_STAGNANT_RUN = 20;

// Software guardrails only; not certified safety limits.
static const double AXIS_SOFTWARE_GUARD_MS2 = 25.0;
static const double TOTAL_SOFTWARE_GUARD_MS2 = 30.0;

// ============================================================================
// NCO / COMMAND SETTINGS
// ============================================================================

static const double COMMAND_MIN_HZ = 20.0;
static const double COMMAND_MAX_HZ = 350.0;
static const double DAC_MIN = 3.0;
static const double DAC_MAX = 29.0;

// Keep the experimentally characterized command quantum for V3.
// 0.125 can be tested later as an optional experiment; it is not assumed here.
static const double DAC_QUANTUM = 0.25;

static const uint32_t DAC_UPDATE_RATE_HZ = 10000;
static const uint32_t TIMER_BASE_FREQUENCY_HZ = 1000000;
static const uint64_t TIMER_ALARM_TICKS = 100; // 1 MHz / 100 = 10 kHz

hw_timer_t *visatonTimer = nullptr;
volatile bool visatonRunning = false;
volatile uint32_t visatonPhaseAccumulator = 0;
volatile uint32_t visatonPhaseIncrement = 0;
volatile uint32_t visatonPhaseOffsetCurrent = 0;
volatile uint32_t visatonPhaseOffsetTarget = 0;

// Double-buffered tables: amplitude switches only at phase wrap.
uint8_t visatonSineTable[2][256];
volatile uint8_t activeSineTable = 0;
volatile uint8_t pendingSineTable = 1;
volatile bool amplitudeTablePending = false;

double currentDacAmplitude = 0.0;
double currentCommandFrequencyHz = 0.0;

// ============================================================================
// CANONICAL EXACT-FREQUENCY ESTIMATOR
// ============================================================================

static const uint16_t CONTROL_SAMPLES = 512;
static const uint8_t CONTROL_WINDOWS = 3;
static const uint8_t CONTROL_MIN_INLIERS = 2;
static const uint16_t WINDOW_GAP_MS = 20;

static const double WINDOW_OUTLIER_PERCENT = 15.0;
static const double RECORD_MAX_MAD_PERCENT = 10.0;
static const double RECORD_MAX_CV_PERCENT = 8.0;
static const double MIN_REPORT_AMPLITUDE_MS2 = 0.03;

// Phase readiness is separate from amplitude validity.
static const double PHASE_STRONG_MIN_SYNC = 0.80;
static const double PHASE_STRONG_MAX_RECORD_SD_DEG = 8.0;
static const double PHASE_MODERATE_MIN_SYNC = 0.65;

// ============================================================================
// SETTLING / STABLE-POINT SETTINGS
// ============================================================================

static const uint16_t SETTLE_BASE_MS = 400;
static const uint16_t SETTLE_PER_DAC_MS = 45;
static const uint16_t SETTLE_MAX_MS = 1400;
static const double SETTLE_MIN_CYCLES = 25.0;

// Up to 3 canonical records at the SAME DAC. The closest pair is accepted only
// if they agree sufficiently, allowing one transient record to be ignored.
static const uint8_t STABLE_POINT_MAX_RECORDS = 3;
static const double STABLE_PAIR_MAX_DRIFT_PERCENT = 6.0;

// ============================================================================
// HYBRID ACQUISITION SETTINGS
// ============================================================================

static const double COARSE_DAC_STEP = 2.0;
// V5 two-band logic:
//   PREFERRED: the target we actively try to reach during acquisition.
//   ACCEPTED : a safe fallback that is retained while one bounded interpolation
//              refinement is attempted. The fallback is restored if refinement
//              does not produce a genuinely better measured point.
static const double PREFERRED_BAND_PERCENT = 2.5;
static const double ACCEPTED_BAND_PERCENT = 5.0;
static const double REFINEMENT_IMPROVEMENT_EPS_PERCENT = 0.10;
static const uint8_t MAX_REFINE_ITERATIONS = 12;
static const uint8_t MAX_ACQUISITION_RESTARTS = 2;
static const uint32_t BRACKET_MAX_AGE_MS = 18000;
static const double SECANT_GUARD_FRACTION = 0.20;

// V5.1R local re-bracket recovery. If a previously valid bracket moves because
// the plant changes, do NOT immediately restart the whole DAC 3...29 scan.
// Re-measure near the old root and move only in the direction required to
// recover a fresh sign crossing. A full V5.1 restart remains the fallback.
static const double LOCAL_REBRACKET_STEP_DAC = 0.50;
static const double LOCAL_REBRACKET_RADIUS_DAC = 3.00;
static const uint8_t LOCAL_REBRACKET_MAX_STEPS = 6;

// Common-path / transient detection.
static const double SAME_DAC_ABRUPT_PERCENT = 20.0; // retained as a hard fallback guard
static const double COMMON_PATH_COLLAPSE_PERCENT = 35.0;

// V5.1 final-candidate confirmation. Keep this deliberately small: three
// canonical records, accepting at least two clean ones.
static const uint8_t CANDIDATE_CONFIRM_RECORDS = 3;
static const uint8_t CANDIDATE_CONFIRM_MIN_VALID = 2;
static const double CANDIDATE_CONFIRM_MAX_CV_PERCENT = 5.0;
static const double CANDIDATE_CONFIRM_MAX_SPREAD_PERCENT = 10.0;

// V5.1 adaptive same-DAC plant-change guard. Normal stable data in the new
// validation sets is usually ~1-3% variable; deliberate posture changes caused
// persistent ~10-17% shifts. The threshold therefore adapts to the confirmed
// baseline CV but is never made hypersensitive.
static const double PLANT_CHANGE_MIN_PERCENT = 8.0;
static const double PLANT_CHANGE_MAX_PERCENT = 15.0;
static const double PLANT_CHANGE_CV_GAIN = 3.0;
static const double PLANT_CHANGE_CV_OFFSET_PERCENT = 3.0;
static const double PLANT_VECTOR_CHANGE_PERCENT = 12.0;

// V5.1 verified correction: one step is only kept after two clean post-step
// records show a real improvement.
static const uint8_t TRIAL_VERIFY_RECORDS = 2;
static const double TRIAL_REQUIRED_IMPROVEMENT_PERCENT = 0.25;

// Warm-start is only a search-location hint. It is never trusted without a
// fresh same-DAC measurement and is used only for nearly identical conditions.
static const double WARM_START_MAX_FREQUENCY_DELTA_HZ = 1.0;
static const double WARM_START_MAX_TARGET_DELTA_PERCENT = 3.0;

// ============================================================================
// SLOW SERVO SETTINGS
// ============================================================================

static const double SERVO_DEADBAND_PERCENT = ACCEPTED_BAND_PERCENT; // hold stable accepted solutions
static const double SERVO_LOCK_BAND_PERCENT = ACCEPTED_BAND_PERCENT;
static const uint8_t SERVO_LOCK_CONSECUTIVE_RECORDS = 2;
static const uint8_t SERVO_ACQUIRE_MAX_RECORDS = 16;
static const uint8_t SERVO_ERROR_PERSISTENCE_RECORDS = 3; // modest errors must persist before correction
static const uint8_t SERVO_SEVERE_PERSISTENCE_RECORDS = 2;
static const double SERVO_QUANTIZATION_GUARD_MARGIN_PERCENT = 0.50;

// Conservative PI in amplitude space; divided by local slope to obtain DAC step.
static const double SERVO_KP = 0.45;
static const double SERVO_KI = 0.04;
static const double INTEGRAL_LIMIT_TARGET_FRACTION = 0.50;

static const double SERVO_NORMAL_MAX_STEP_DAC = 0.25;
static const double SERVO_SEVERE_MAX_STEP_DAC = 0.50;
static const double SERVO_SEVERE_ERROR_PERCENT = 10.0;

static const double MIN_VALID_SLOPE = 0.005;  // m/s^2 per DAC
static const double MAX_VALID_SLOPE = 10.0;
static const uint8_t MAX_SLOPE_HISTORY = 5;
static const uint8_t MAX_CONSECUTIVE_INVALID_SERVO_RECORDS = 3;
static const uint8_t MAX_UNPRODUCTIVE_CORRECTIONS = 2;
static const uint8_t MAX_RUNTIME_REACQUIRES = 2;

// ============================================================================
// CLOSED-LOOP HOLD / THESIS ACCEPTANCE
// ============================================================================

static const double HOLD_TIGHT_BAND_PERCENT = PREFERRED_BAND_PERCENT; // preferred reported band
static const double HOLD_FINAL_BAND_PERCENT = ACCEPTED_BAND_PERCENT; // primary accepted/pass band
static const double HOLD_MAX_CV_PERCENT = 5.0;
static const double HOLD_MAX_RMS_ERROR_PERCENT = 5.0; // primary time-domain tracking quality
// +/-5% in-band percentage is reported, not used as a binary gate.
static const uint8_t HOLD_MIN_VALID_RECORDS = 3;

// Stronger readiness gate for the next phase-sweep experiment. This does not
// alter the existing amplitude PASS definition.
static const double PHASE_READY_MIN_IN_BAND_PERCENT = 75.0;
static const double PHASE_READY_MAX_CV_PERCENT = 3.0;
static const double PHASE_READY_MAX_RMS_ERROR_PERCENT = 4.0;
static const uint16_t PHASE_READY_MAX_CORRECTIONS = 1;

// Phase classification from the closed-loop hold.
static const double HOLD_STRONG_SYNC = 0.80;
static const double HOLD_STRONG_PHASE_SPAN_DEG = 5.0;
static const double HOLD_MODERATE_SYNC = 0.65;
static const double HOLD_MODERATE_PHASE_SPAN_DEG = 10.0;

// ============================================================================
// FFT SETTINGS
// ============================================================================

static const uint16_t FFT_SAMPLES = 1024;
static const uint16_t HALF_BINS = FFT_SAMPLES / 2;
static const uint8_t FFT_FRAMES = 3;
static const double HAMMING_COHERENT_GAIN = 0.54;
static const double LOCAL_SEARCH_HALF_WIDTH_HZ = 8.0;
static const double FFT_MIN_AMPLITUDE_MS2 = 0.03;
static const double FFT_MIN_SNR_DB = 3.0;
static const uint8_t FFT_PEAK_EXCLUSION_BINS = 3;

// ============================================================================
// QUICK DAC AUTHORITY + 12-PHASE HOLD SETTINGS (V1.6)
// ============================================================================

// Fast actuator-only authority diagnostic before axis selection.
static const uint16_t QUICK_DAC_WINDOW_SAMPLES = 256;  // 160 ms
static const uint8_t QUICK_DAC_WINDOWS = 2;
static const uint16_t QUICK_DAC_WINDOW_GAP_MS = 15;
static const uint16_t QUICK_DAC_SETTLE_MS = 350;
static const double QUICK_DAC_MAX_CV_PERCENT = 8.0;
static const uint8_t QUICK_DAC_POINT_COUNT = 7;
static const double QUICK_DAC_LEVELS[QUICK_DAC_POINT_COUNT] = {
  5.0, 9.0, 13.0, 17.0, 21.0, 25.0, 29.0
};

// V1.6 Stage C deliberately trades speed for evidence quality.
// Twelve fixed command phases (0..330 deg in 30 deg steps) are each held for
// five seconds. Ten short exact-frequency triaxial windows are distributed
// across each hold so we can see mean response, variability and min/max rather
// than trusting a single 40 ms snapshot. There is still NO live phase tracking.
static const uint8_t PHASE_HOLD_POINT_COUNT = 12;
static const double PHASE_HOLD_STEP_DEG = 30.0;
static const uint32_t PHASE_HOLD_DURATION_MS = 5000;
static const uint8_t PHASE_HOLD_MEASUREMENTS = 10;
static const uint8_t PHASE_HOLD_MIN_VALID = 8;
static const uint16_t PHASE_HOLD_WINDOW_SAMPLES = 256; // 160 ms at 1600 Hz
static const uint16_t PHASE_HOLD_POST_SLEW_SETTLE_MS = 250;
static const uint16_t PHASE_HOLD_TOOL_STEADY_DELAY_MS = 1000;
static const uint16_t PHASE_HOLD_SAMPLE_PERIOD_MS = 500;

// Only the coarse reconnaissance stage is accelerated. A clean canonical
// record farther than 20% from target is sufficient to locate the target
// region. Inside +/-20%, the original robust 2-record / optional 3rd-record
// stable-pair logic is retained. Candidate confirmation and servo lock are
// unchanged.
static const double FAST_COARSE_SINGLE_RECORD_ERROR_PERCENT = 20.0;

// Experimental software abort ceilings only; they are NOT physiological limits.
static const double PHASE_AXIS_ABORT_MS2 = 8.0;
static const double PHASE_VECTOR_ABORT_MS2 = 10.0;

// Phase offset is slewed in the 10 kHz ISR rather than jumped instantaneously.
// 0.25 degree/tick => worst-case 180 degree move in about 72 ms.
static const uint32_t PHASE_SLEW_WORD_PER_ISR = 2982616UL;

// ============================================================================
// V2.0 TOOL-REFERENCED PHASE TRACKING SETTINGS
// ============================================================================
// 256 samples = 160 ms. This is short enough that the free-running tool phase
// moves only modestly within one window, while still containing ~40 cycles at
// the present 240..320 Hz operating band.
static const uint16_t TRACK_WINDOW_SAMPLES = 256;
static const uint32_t TRACK_LATE_SAMPLE_WARNING_US = 40;
static const uint8_t TRACK_MAX_LATE_SAMPLES = 8;

// ADXL1 reference-quality gates. These are deliberately compatible with the
// drift-tolerant local-sync behaviour already observed in Stage A.
static const double TRACK_MIN_TOOL_SYNC = 0.30;
static const double TRACK_MIN_TOOL_AMPLITUDE_MS2 = 0.04;
static const double TRACK_MIN_LIVE_TO_BASELINE_RATIO = 0.25;
static const double TRACK_MAX_LIVE_TO_BASELINE_RATIO = 4.00;

// Before Stage C, c measures actuator leakage into ADXL1 while the tool is OFF.
// <=25% is GOOD; 25..50% is MARGINAL but allowed; >50% is rejected because the
// reference could become dominated by the controller's own secondary field.
static const double TRACK_GOOD_REFERENCE_LEAK_RATIO = 0.25;
static const double TRACK_MAX_REFERENCE_LEAK_RATIO = 0.50;

// ============================================================================
// SINGLE-FREQUENCY COMPLEX NORMALIZED FXLMS SETTINGS (V1.0)
// ============================================================================
// These are conservative engineering starting values for the FIRST hardware
// experiment. They are not universal scientific acceptance thresholds.
static const uint16_t FX_BLOCK_SAMPLES = 256;              // 160 ms @ 1600 Hz
static const uint8_t FX_BASELINE_WINDOWS = 5;
static const uint8_t FX_BASELINE_MIN_VALID = 4;
static const uint8_t FX_SEC_PROBE_COUNT = 3;
static const double FX_SEC_PROBE_PHASES_DEG[FX_SEC_PROBE_COUNT] = {0.0, 90.0, 0.0};
// V1.2: five windows give enough redundancy to reject one mechanical transient.
static const uint8_t FX_SEC_WINDOWS_PER_PROBE = 5;
static const uint8_t FX_SEC_MIN_VALID_WINDOWS = 4;
static const uint16_t FX_SEC_SETTLE_MS = 300;
static const double FX_SEC_MIN_RESPONSE_MS2 = 0.05;
static const double FX_SEC_MIN_SYNC = 0.25;
static const double FX_SEC_MIN_MEAN_SYNC = 0.40;
static const double FX_SEC_PREFERRED_MEAN_SYNC = 0.55;
static const double FX_SEC_MAX_GAIN_CV_PERCENT = 10.0;
static const double FX_SEC_MAX_PHASE_SD_DEG = 15.0;
// Loose inlier gates only remove an obvious transient; final CV/phase gates stay strict.
static const double FX_SEC_OUTLIER_GAIN_DEV_PERCENT = 25.0;
static const double FX_SEC_OUTLIER_PHASE_DEV_DEG = 25.0;
static const uint8_t FX_SEC_PHASE_RETRIES = 1;

static const uint8_t FX_STARTUP_BLOCKS = 5;
static const double FX_STARTUP_MU = 0.005;
static const double FX_DEFAULT_NORMAL_MU = 0.020;
static const double FX_MIN_USER_MU = 0.001;
static const double FX_MAX_USER_MU = 0.100;
static const double FX_MAX_WEIGHT_STEP_DAC = 0.50;
static const double FX_NORMALIZATION_EPS = 1.0e-6;
static const double FX_COMMAND_QUANTUM_DAC = 0.25;
static const double FX_COMMAND_MAX_ABOVE_MATCH_DAC = 4.0;
// V1.2: c/d are optional. i surveys a safe range and chooses the BEST coherent
// moderate-amplitude identification point, not the first point that barely passes.
static const uint8_t FX_AUTO_PROBE_COUNT = 9;
static const double FX_AUTO_PROBE_LEVELS[FX_AUTO_PROBE_COUNT] = {
  5.0, 7.0, 9.0, 11.0, 13.0, 15.0, 17.0, 19.0, 21.0
};
static const double FX_AUTO_PROBE_MIN_RESPONSE_MS2 = 0.12;
static const double FX_AUTO_PROBE_MIN_RESPONSE_FRACTION = 0.40;
static const double FX_AUTO_PROBE_PREFERRED_RESPONSE_FRACTION = 0.60;
static const uint8_t FX_AUTO_MAX_CANDIDATES_TO_TRY = 3;
static const double FX_AUTO_DEFAULT_COMMAND_MAX_DAC = 15.0;
static const double FX_AUTO_HARD_COMMAND_MAX_DAC = 21.0;
static const double FX_MIN_ERROR_SYNC = 0.15;
// Near deep cancellation the selected residual phase naturally becomes noisy.
// In that region the safe action is to HOLD W, not classify success as a fault.
static const double FX_LOW_RESIDUAL_FRACTION = 0.25;
static const double FX_LOW_RESIDUAL_ABS_MS2 = 0.05;
static const uint8_t FX_MAX_CONSECUTIVE_INVALID = 3;
static const double FX_GROWTH_ABORT_FACTOR = 1.50;
static const uint8_t FX_GROWTH_ABORT_BLOCKS = 3;
static const uint32_t FX_VALIDATION_DURATION_MS = 10000;

// ============================================================================
// FXLMS V1.4R - ROBUST FRESH BASELINE + AUTOMATIC 60-S FROZEN PERSISTENCE
// ============================================================================
// IMPORTANT: no FxLMS learning law, mu, Wbest qualification, or vector/system
// selection is changed here. These additions only improve baseline acquisition
// robustness and extend validation AFTER the existing 10-s frozen confirmation.
static const uint8_t FX_BASELINE_MAX_ATTEMPTS = 10;
static const uint16_t FX_BASELINE_STEADY_DELAY_MS = 1000;
static const uint16_t FX_BASELINE_RETRY_GAP_MS = 40;

static const uint32_t FX_EXTENDED_FREEZE_DURATION_MS = 60000UL;
static const uint32_t FX_EXTENDED_FREEZE_SEGMENT_MS = 10000UL;
static const uint8_t FX_EXTENDED_FREEZE_SEGMENTS = 6;

static const uint8_t FX_MIN_ADAPT_SECONDS = 5;
static const uint8_t FX_MAX_ADAPT_SECONDS = 60;

// ============================================================================
// FXLMS V1.4 AXIS-CHARACTERIZATION SUPERVISORY SETTINGS
// ============================================================================
// These are explicit engineering starting values. They are logged and should be
// tuned only from repeated experiments; they are not claimed as universal laws.
static const double FX_V13_FINE_RESIDUAL_RATIO = 0.60;
static const double FX_V13_HOLD_ENTER_RATIO = 0.30;
static const double FX_V13_HOLD_EXIT_RATIO = 0.40;
static const uint8_t FX_V13_HOLD_EXIT_COHERENT_BLOCKS = 4;
static const uint8_t FX_V13_HOLD_EARLY_VALIDATE_BLOCKS = 12; // ~1.9 s @ 160 ms
static const double FX_V13_FINE_MU_FACTOR = 0.50;

static const uint8_t FX_V13_ROLLING_BLOCKS = 5;
// V1.4: Wbest is an AXIS-characterization controller. Vector remains telemetry,
// not an eligibility gate. 20% selected-axis reduction + 3/5 positive blocks
// prevents one lucky 160-ms block from being stored as a controller.
static const double FX_V13_BEST_MIN_SELECTED_REDUCTION_PCT = 20.0;
static const uint8_t FX_V13_BEST_MIN_POSITIVE_SELECTED_BLOCKS = 3;
static const double FX_V14_BEST_SELECTED_IMPROVEMENT_EPS_PCT = 0.25;

// V1.4 deliberately removes the former 10%/20% vector performance supervisor.
// The pre-existing FX_GROWTH_ABORT_FACTOR (=1.50) / FX_GROWTH_ABORT_BLOCKS (=3)
// and absolute sensor/software guards remain as emergency protection only.

// Poor error coherence is held temporarily rather than causing an immediate
// 0.48-s abort. Reference/sensor/safety failures still have independent aborts.
static const uint8_t FX_V13_MAX_ERROR_QUALITY_HOLD_BLOCKS = 15; // ~2.4 s
static const uint8_t FX_V13_MAX_REFERENCE_REJECT_BLOCKS = 5;    // ~0.8 s

// Identification amplitude and live-control authority are deliberately separate.
static const double FX_V13_AUTHORITY_FACTOR = 1.50;
static const double FX_V13_CONTROL_CEILING_MIN_DAC = 3.0;
static const double FX_V13_CONTROL_CEILING_HARD_DAC = 15.0;

// Optional A-B-A-B causal validation after a successful frozen-W run.
static const uint32_t FX_V13_CAUSAL_OFF_MS = 5000;
static const uint32_t FX_V13_CAUSAL_ON_MS = 10000;


// Phase tracker. A tool/NCO frequency difference larger than this is treated as
// a bad phase estimate for this narrowband proof test rather than chased.
static const double TRACK_MAX_ABS_FREQ_ERROR_HZ = 1.50;
static const double TRACK_FREQ_LPF_ALPHA = 0.35;
static const double TRACK_ACCEPT_ERROR_DEG = 12.0;
static const uint8_t TRACK_MAX_CONSECUTIVE_BAD_WINDOWS = 5;

// Automatic tracked sweep: coarse -> fine -> tracked verification.
static const uint8_t TRACK_COARSE_POINT_COUNT = 12;
static const double TRACK_COARSE_STEP_DEG = 30.0;
static const uint8_t TRACK_COARSE_VALID_WINDOWS = 8;
static const double TRACK_FINE_HALF_RANGE_DEG = 30.0;
static const double TRACK_FINE_STEP_DEG = 10.0;
static const uint8_t TRACK_FINE_VALID_WINDOWS = 6;
static const uint8_t TRACK_FINAL_VALID_WINDOWS = 30; // ~4.8 s of accepted windows
static const uint8_t TRACK_WARMUP_WINDOWS_PER_POINT = 2;
static const uint8_t TRACK_EXTRA_ATTEMPTS = 8;
static const uint16_t TRACK_TOOL_STEADY_DELAY_MS = 1000;

// ============================================================================
// GLOBAL / STATIC MEMORY - LARGE BUFFERS NEVER LIVE ON TASK STACK
// ============================================================================

int16_t rawX[FFT_SAMPLES];
int16_t rawY[FFT_SAMPLES];
int16_t rawZ[FFT_SAMPLES];
uint32_t phaseReference[FFT_SAMPLES];
uint32_t phaseOffsetReference[FFT_SAMPLES]; // V2.0: actual command offset sampled with the NCO

double fftReal[FFT_SAMPLES];
double fftImag[FFT_SAMPLES];
double spectrumX[HALF_BINS];
double spectrumY[HALF_BINS];
double spectrumZ[HALF_BINS];
ArduinoFFT<double> FFT(fftReal, fftImag, FFT_SAMPLES, SAMPLE_RATE_HZ);

double slopeHistory[MAX_SLOPE_HISTORY];
uint8_t slopeCount = 0;

// User settings/state.
double testFrequencyHz = 268.0;
double targetAmplitudeMs2 = 1.00;
ControlAxis controlAxis = ControlAxis::Z_AXIS;
uint8_t holdSeconds = 8;
uint8_t independentRuns = 5;

bool automaticTestRunning = false;
bool emergencyStopRequested = false;
bool targetAcquired = false;
StablePoint lockedPoint = {};
StablePoint lastBracketLow = {};
StablePoint lastBracketHigh = {};

// V5.1 state. Warm memory is deliberately tiny: one last proven operating
// point, not a DAC->amplitude calibration curve.
WarmStartMemory warmStartMemory = {};
PlantBaseline lockedPlantBaseline = {};

// Fixed serial command buffer avoids String heap fragmentation.
static const uint8_t COMMAND_BUFFER_SIZE = 96;
char commandBuffer[COMMAND_BUFFER_SIZE];
uint8_t commandLength = 0;

// Automatic tests run inside a blocking command. Keep a separate tiny line
// parser for emergency-stop input so an arbitrary character 's' embedded in
// unrelated serial text cannot stop the actuator. The intended command is a
// standalone line: s + Newline (or S + Newline).
static const uint8_t EMERGENCY_BUFFER_SIZE = 12;
char emergencyCommandBuffer[EMERGENCY_BUFFER_SIZE];
uint8_t emergencyCommandLength = 0;

// ============================================================================
// INTEGRATED NARROWBAND DISCOVERY SETTINGS / STATIC MEMORY
// ============================================================================

static const double DISC_SEARCH_MIN_HZ = 240.0;
static const double DISC_SEARCH_MAX_HZ = 320.0;
static const uint8_t DISC_TOP_CANDIDATES = 5;
static const uint8_t DISC_PEAK_EXCLUSION_BINS = 3;
static const double DISC_MIN_FFT_SNR_DB = 8.0;
static const double DISC_MIN_SIGNAL_AMPLITUDE_MS2 = 0.03;
static const uint16_t DISC_QUAD_BLOCK_N = 256;
static const uint8_t DISC_QUAD_BLOCKS = 10;
static const uint16_t DISC_QUAD_N = DISC_QUAD_BLOCK_N * DISC_QUAD_BLOCKS;
static const double DISC_FFT_RESOLUTION_HZ = SAMPLE_RATE_HZ / static_cast<double>(FFT_SAMPLES);
static const double DISC_QUAD_MAX_CORRECTION_HZ = DISC_FFT_RESOLUTION_HZ;
static const double DISC_QUAD_MAX_PHASE_RMSE_DEG = 35.0;

// --------------------------------------------------------------------------
// V1.3A DRIFT-TOLERANT ASCII-SAFE QUALITY GATES
// --------------------------------------------------------------------------
// The old V1.2 auto-lock required whole-record weighted SyncRatio >= 0.50.
// Real hand-held records repeatedly showed one obvious 268..273 Hz family but
// whole-record ratios around 0.3..0.4 because the tool frequency/phase wanders
// during the ~1.6 s quadrature record.  V1.3 does NOT simply lower that old
// threshold.  Instead it separates local periodicity from long-record drift:
//   * local block sync = periodicity over each ~160 ms block
//   * phase-fit RMSE    = orderly long-record phase/frequency evolution
//   * FFT consensus     = independent axes/sensors agreeing on the same family
//   * candidate ratio   = protection against genuinely competing frequencies
static const double DISC_LOCAL_GOOD_BLOCK_SYNC = 0.20;
static const double DISC_LOCAL_AXIS_MIN_MEDIAN_SYNC = 0.25;
static const double DISC_SUPPORT_AXIS_MIN_LOCAL_SYNC = 0.30;
static const uint8_t DISC_LOCAL_MIN_GOOD_BLOCKS = 5;       // >= 50% of 10 blocks
static const double DISC_AUTO_LOCK_MIN_WEIGHTED_LOCAL_SYNC = 0.30;
static const double DISC_AUTO_LOCK_SCORE_RATIO = 1.35;
static const uint8_t DISC_AUTO_LOCK_MIN_SUPPORT_AXES = 1;

// FFT interpolation is finer than a raw bin, but a tolerance of two raw FFT
// bins is intentionally used so natural short-term tool drift does not destroy
// cross-axis consensus.  It is still far narrower than the 240..320 Hz band.
static const double DISC_FREQ_CONSENSUS_TOL_HZ = 2.0 * DISC_FFT_RESOLUTION_HZ;
static const uint8_t DISC_MIN_TOOL_FREQ_CONSENSUS_AXES = 1;
static const uint8_t DISC_MIN_TOTAL_FREQ_CONSENSUS_AXES = 3;
static const uint32_t DISC_LATE_SAMPLE_WARNING_US = 10;
static const uint16_t DISC_MAX_ZERO_TRIPLETS_PER_RECORD = 20;
static const uint8_t DISC_MAX_FRAME_RETRIES = 2;

// First 1024 entries are reused for FFT frames; all 2560 entries are reused for
// the uninterrupted quadrature record. Large arrays remain global/static.
int16_t discToolX[DISC_QUAD_N];
int16_t discToolY[DISC_QUAD_N];
int16_t discToolZ[DISC_QUAD_N];
int16_t discHandX[DISC_QUAD_N];
int16_t discHandY[DISC_QUAD_N];
int16_t discHandZ[DISC_QUAD_N];

// MEMORY REUSE (V1.3): Stage A discovery and Stage B matcher never need
// their tool spectra at the same time. Reuse the matcher's three spectrum
// buffers instead of reserving another 12,288 bytes of DRAM.
#define discToolSpecX spectrumX
#define discToolSpecY spectrumY
#define discToolSpecZ spectrumZ

// ADXL2/hand discovery spectra must coexist with the tool spectra while
// Stage A is being analysed, so these remain dedicated.
double discHandSpecX[HALF_BINS];
double discHandSpecY[HALF_BINS];
double discHandSpecZ[HALF_BINS];

// MEMORY REUSE (V1.3): after the three FFT frames are accumulated, fftReal
// is no longer needed as FFT work memory until a later, separate stage. Use
// its first HALF_BINS entries as the tool vector spectrum. This saves another
// 4,096 bytes. A hand vector spectrum was never consumed by the algorithm,
// so the unused 4,096-byte buffer has been removed entirely.
#define discToolVectorSpectrum fftReal

DiscoveryCandidate discoveryCandidates[DISC_TOP_CANDIDATES];
uint8_t discoveryCandidateCount = 0;
DiscoverySensorFFTResult discoveryToolFFT = {};
DiscoverySensorFFTResult discoveryHandFFT = {};
DiscoverySensorAtF0 baselineToolAtF0 = {};
DiscoverySensorAtF0 baselineHandAtF0 = {};

double baselineF0Hz = 0.0;
bool baselineValid = false;
bool baselineAxisSelected = false;
IntegratedWorkflowState integratedWorkflowState = IntegratedWorkflowState::NEED_BASELINE;
double frozenMatchDac = 0.0;
double frozenMatchMeasuredMs2 = 0.0;
double lastBestPhaseDeg = 0.0;
double lastBestPhaseResidualMs2 = 0.0;
bool lastPhaseSweepValid = false;
bool quickDacSweepDone = false;
QuickDacPoint quickDacPoints[QUICK_DAC_POINT_COUNT] = {};
bool quickAxisReachable[3] = {false, false, false};
double quickAxisEstimatedDac[3] = {0.0, 0.0, 0.0};

// V2.0 reference-leakage / phase-reference state.
bool phaseReferenceLeakageValid = false;
double phaseReferenceLeakageMs2[3] = {0.0, 0.0, 0.0};
double phaseReferenceLeakRatio[3] = {999.0, 999.0, 999.0};
uint8_t phaseReferenceAxis = 0;
bool phaseReferenceAxisValid = false;

// FxLMS state. The secondary path is represented by ONE complex gain at f0.
bool fxSecondaryPathValid = false;
double fxSecondaryGainMs2PerDac = 0.0;
double fxSecondaryPhaseDeg = 0.0;
FxComplex fxSecondaryPath = {0.0, 0.0};
double fxProbeDac = 0.0;
double fxCommandMaxDac = 0.0;
double fxNormalMu = FX_DEFAULT_NORMAL_MU;
FxComplex fxLastControllerW = {0.0, 0.0};
bool fxLastRunValid = false;
FxBaseline fxLastRunBaseline = {};
bool fxLastSystemCandidateValid = false;
double fxLastControlCeilingDac = 0.0;

// V1.4R validation snapshots. The 60-s test is automatically executed only
// after the existing independent 10-s frozen validation itself qualifies the
// selected axis (>=20% attenuation). Vector remains diagnostic only.
FxValidationResult fxLastFrozen10Result = {};
FxValidationResult fxLastExtended60Result = {};
bool fxLastExtended60Valid = false;


// ============================================================================
// BASIC HELPERS
// ============================================================================

double clampDouble(double value, double low, double high) {
  if (value < low) return low;
  if (value > high) return high;
  return value;
}

double quantizeDac(double value) {
  value = clampDouble(value, DAC_MIN, DAC_MAX);
  value = round(value / DAC_QUANTUM) * DAC_QUANTUM;
  return clampDouble(value, DAC_MIN, DAC_MAX);
}

double wrapDegrees(double value) {
  while (value >= 180.0) value -= 360.0;
  while (value < -180.0) value += 360.0;
  return value;
}

double percentDifference(double a, double b) {
  double denom = 0.5 * (fabs(a) + fabs(b));
  if (denom < 1.0e-12) return 999.0;
  return 100.0 * fabs(a - b) / denom;
}

double targetErrorPercent(double measured) {
  if (targetAmplitudeMs2 < 1.0e-12) return 999.0;
  return 100.0 * (measured - targetAmplitudeMs2) / targetAmplitudeMs2;
}

bool inTargetBand(double measured, double percent) {
  double f = percent / 100.0;
  return measured >= targetAmplitudeMs2 * (1.0 - f) &&
         measured <= targetAmplitudeMs2 * (1.0 + f);
}

uint8_t axisIndex() {
  return static_cast<uint8_t>(controlAxis);
}

char axisChar() {
  if (controlAxis == ControlAxis::X_AXIS) return 'X';
  if (controlAxis == ControlAxis::Y_AXIS) return 'Y';
  return 'Z';
}

char dominantAxis(double x, double y, double z) {
  if (x >= y && x >= z) return 'X';
  if (y >= x && y >= z) return 'Y';
  return 'Z';
}

void sortSmall(double *values, uint8_t count) {
  for (uint8_t i = 1; i < count; i++) {
    double key = values[i];
    int j = static_cast<int>(i) - 1;
    while (j >= 0 && values[j] > key) {
      values[j + 1] = values[j];
      j--;
    }
    values[j + 1] = key;
  }
}

double medianSmall(const double *source, uint8_t count) {
  if (count == 0) return 0.0;
  double work[8];
  if (count > 8) count = 8;
  for (uint8_t i = 0; i < count; i++) work[i] = source[i];
  sortSmall(work, count);
  if (count & 1U) return work[count / 2];
  return 0.5 * (work[count / 2 - 1] + work[count / 2]);
}

double meanSmall(const double *values, uint8_t count) {
  if (count == 0) return 0.0;
  double sum = 0.0;
  for (uint8_t i = 0; i < count; i++) sum += values[i];
  return sum / static_cast<double>(count);
}

double sampleSdSmall(const double *values, uint8_t count, double mean) {
  if (count < 2) return 0.0;
  double ss = 0.0;
  for (uint8_t i = 0; i < count; i++) {
    double d = values[i] - mean;
    ss += d * d;
  }
  return sqrt(ss / static_cast<double>(count - 1));
}

double circularMeanDeg(const double *angles, uint8_t count) {
  if (count == 0) return 0.0;
  double c = 0.0, s = 0.0;
  for (uint8_t i = 0; i < count; i++) {
    double r = angles[i] * PI / 180.0;
    c += cos(r);
    s += sin(r);
  }
  return wrapDegrees(atan2(s, c) * 180.0 / PI);
}

double circularSdDeg(const double *angles, uint8_t count, double meanDeg) {
  if (count < 2) return 0.0;
  double diff[8];
  for (uint8_t i = 0; i < count; i++) diff[i] = wrapDegrees(angles[i] - meanDeg);
  double m = meanSmall(diff, count);
  return sampleSdSmall(diff, count, m);
}

void resetRunningStats(RunningStats &s) {
  s.n = 0;
  s.mean = 0.0;
  s.m2 = 0.0;
  s.minValue = 1.0e99;
  s.maxValue = -1.0e99;
}

void pushRunningStats(RunningStats &s, double value) {
  s.n++;
  double delta = value - s.mean;
  s.mean += delta / static_cast<double>(s.n);
  double delta2 = value - s.mean;
  s.m2 += delta * delta2;
  if (value < s.minValue) s.minValue = value;
  if (value > s.maxValue) s.maxValue = value;
}

double runningSd(const RunningStats &s) {
  if (s.n < 2) return 0.0;
  return sqrt(s.m2 / static_cast<double>(s.n - 1));
}

void clearSlopeHistory() {
  slopeCount = 0;
  for (uint8_t i = 0; i < MAX_SLOPE_HISTORY; i++) slopeHistory[i] = 0.0;
}

void pushSlope(double slope) {
  if (!isfinite(slope) || slope < MIN_VALID_SLOPE || slope > MAX_VALID_SLOPE) return;
  if (slopeCount < MAX_SLOPE_HISTORY) {
    slopeHistory[slopeCount++] = slope;
  } else {
    for (uint8_t i = 1; i < MAX_SLOPE_HISTORY; i++) slopeHistory[i - 1] = slopeHistory[i];
    slopeHistory[MAX_SLOPE_HISTORY - 1] = slope;
  }
}

double medianSlope() {
  if (slopeCount == 0) return 0.0;
  return medianSmall(slopeHistory, slopeCount);
}

void clearTrialState(ServoState &s) {
  s.trialPending = false;
  s.trialValidCount = 0;
  s.trialAmp[0] = s.trialAmp[1] = 0.0;
  for (uint8_t a = 0; a < 3; a++) s.trialAxisSum[a] = 0.0;
  s.trialTotalSum = 0.0;
  s.trialMaxCvPercent = 0.0;
}

bool warmStartUsable() {
  if (!warmStartMemory.valid) return false;
  if (warmStartMemory.axis != controlAxis) return false;
  if (fabs(warmStartMemory.frequencyHz - testFrequencyHz) >
      WARM_START_MAX_FREQUENCY_DELTA_HZ) return false;
  double targetDeltaPct = 100.0 * fabs(warmStartMemory.targetMs2 - targetAmplitudeMs2) /
                          fmax(targetAmplitudeMs2, 1.0e-12);
  return targetDeltaPct <= WARM_START_MAX_TARGET_DELTA_PERCENT;
}

void rememberWarmStart(double dac) {
  warmStartMemory.valid = true;
  warmStartMemory.axis = controlAxis;
  warmStartMemory.frequencyHz = testFrequencyHz;
  warmStartMemory.targetMs2 = targetAmplitudeMs2;
  warmStartMemory.dac = quantizeDac(dac);
}

void setPlantBaselineFromRecords(PlantBaseline &b, const ControlRecord recs[], uint8_t count) {
  b = {};
  if (count == 0) return;
  double amps[3];
  double mean = 0.0;
  for (uint8_t i = 0; i < count; i++) {
    amps[i] = recs[i].selectedMedianMs2;
    mean += amps[i];
    for (uint8_t a = 0; a < 3; a++) b.axisMeanMs2[a] += recs[i].axisMeanMs2[a];
    b.totalMeanMs2 += recs[i].totalMeanMs2;
  }
  mean /= count;
  for (uint8_t a = 0; a < 3; a++) b.axisMeanMs2[a] /= count;
  b.totalMeanMs2 /= count;
  b.valid = true;
  b.dac = recs[count - 1].dac;
  b.selectedMs2 = mean;
  b.selectedCvPercent = count >= 2 && mean > 1.0e-12
      ? 100.0 * sampleSdSmall(amps, count, mean) / mean : 0.0;
}

void setPlantBaselineFromTrialAverages(PlantBaseline &b, const ServoState &s, double dac) {
  b = {};
  if (s.trialValidCount == 0) return;
  b.valid = true;
  b.dac = dac;
  b.selectedMs2 = (s.trialAmp[0] + s.trialAmp[1]) / s.trialValidCount;
  for (uint8_t a = 0; a < 3; a++) b.axisMeanMs2[a] = s.trialAxisSum[a] / s.trialValidCount;
  b.totalMeanMs2 = s.trialTotalSum / s.trialValidCount;
  double drift = s.trialValidCount >= 2 ? percentDifference(s.trialAmp[0], s.trialAmp[1]) : 0.0;
  b.selectedCvPercent = drift / sqrt(2.0); // two-point CV proxy, conservative enough for guarding
}

double plantChangeThresholdPercent(const PlantBaseline &b) {
  double adaptive = PLANT_CHANGE_CV_GAIN * b.selectedCvPercent +
                    PLANT_CHANGE_CV_OFFSET_PERCENT;
  return clampDouble(adaptive, PLANT_CHANGE_MIN_PERCENT, PLANT_CHANGE_MAX_PERCENT);
}

bool plantStateMismatch(const PlantBaseline &b, const ControlRecord &r, bool printDiag) {
  if (!b.valid || !r.amplitudeValid) return false;
  if (fabs(b.dac - r.dac) > 1.0e-9) return false;

  double selectedChange = percentDifference(b.selectedMs2, r.selectedMedianMs2);
  double threshold = plantChangeThresholdPercent(b);
  double totalChange = percentDifference(b.totalMeanMs2, r.totalMeanMs2);
  uint8_t changedAxes = 0;
  for (uint8_t a = 0; a < 3; a++) {
    if (b.axisMeanMs2[a] < 0.03 && r.axisMeanMs2[a] < 0.03) continue;
    if (percentDifference(b.axisMeanMs2[a], r.axisMeanMs2[a]) >=
        PLANT_VECTOR_CHANGE_PERCENT) changedAxes++;
  }

  bool vectorEvidence = totalChange >= PLANT_VECTOR_CHANGE_PERCENT || changedAxes >= 2;
  bool strongSelectedEvidence = selectedChange >= threshold + 4.0;
  bool mismatch = selectedChange >= threshold && (vectorEvidence || strongSelectedEvidence);

  if (printDiag && selectedChange >= threshold) {
    Serial.print("PLANT_STATE_CHECK | selected change "); Serial.print(selectedChange, 2);
    Serial.print(" % | adaptive threshold "); Serial.print(threshold, 2);
    Serial.print(" % | vector change "); Serial.print(totalChange, 2);
    Serial.print(" % | changed axes "); Serial.println(changedAxes);
  }
  return mismatch;
}

const char *phaseClassText(PhaseClass p) {
  if (p == PhaseClass::STRONG) return "STRONG";
  if (p == PhaseClass::MODERATE) return "MODERATE";
  return "WEAK";
}

// ============================================================================
// ADXL345 SPI
// ============================================================================

void writeRegister(uint8_t reg, uint8_t value) {
  SPI.beginTransaction(adxlSpiSettings);
  digitalWrite(PIN_CS_ADXL2, LOW);
  SPI.transfer(reg & 0x3F);
  SPI.transfer(value);
  digitalWrite(PIN_CS_ADXL2, HIGH);
  SPI.endTransaction();
}

uint8_t readRegister(uint8_t reg) {
  SPI.beginTransaction(adxlSpiSettings);
  digitalWrite(PIN_CS_ADXL2, LOW);
  SPI.transfer(SPI_READ_BIT | (reg & 0x3F));
  uint8_t value = SPI.transfer(0x00);
  digitalWrite(PIN_CS_ADXL2, HIGH);
  SPI.endTransaction();
  return value;
}

RawAcceleration readRawXYZ() {
  RawAcceleration r = {};
  SPI.beginTransaction(adxlSpiSettings);
  digitalWrite(PIN_CS_ADXL2, LOW);
  SPI.transfer(SPI_READ_BIT | SPI_MB_BIT | (REG_DATAX0 & 0x3F));
  uint8_t x0 = SPI.transfer(0), x1 = SPI.transfer(0);
  uint8_t y0 = SPI.transfer(0), y1 = SPI.transfer(0);
  uint8_t z0 = SPI.transfer(0), z1 = SPI.transfer(0);
  digitalWrite(PIN_CS_ADXL2, HIGH);
  SPI.endTransaction();
  r.x = static_cast<int16_t>((static_cast<uint16_t>(x1) << 8) | x0);
  r.y = static_cast<int16_t>((static_cast<uint16_t>(y1) << 8) | y0);
  r.z = static_cast<int16_t>((static_cast<uint16_t>(z1) << 8) | z0);
  return r;
}

bool verifyAdxl2(bool printDetails) {
  uint8_t devid = readRegister(REG_DEVID);
  uint8_t format = readRegister(REG_DATA_FORMAT);
  uint8_t rate = readRegister(REG_BW_RATE);
  uint8_t power = readRegister(REG_POWER_CTL);

  bool ok = devid == ADXL_DEVID_OK &&
            ((format & 0x0F) == 0x0B) &&
            ((rate & 0x1F) == 0x0E) &&
            ((power & 0x08) != 0);

  if (printDetails || !ok) {
    Serial.print("ADXL2 DEVID=0x"); Serial.print(devid, HEX);
    Serial.print(" DATA_FORMAT=0x"); Serial.print(format, HEX);
    Serial.print(" BW_RATE=0x"); Serial.print(rate, HEX);
    Serial.print(" POWER_CTL=0x"); Serial.println(power, HEX);
  }
  return ok;
}

bool initializeAdxl2() {
  writeRegister(REG_POWER_CTL, 0x00);
  delay(10);
  if (readRegister(REG_DEVID) != ADXL_DEVID_OK) return false;
  writeRegister(REG_DATA_FORMAT, 0x0B); // FULL_RES, +/-16 g, 4-wire SPI
  writeRegister(REG_BW_RATE, 0x0E);     // 1600 Hz ODR
  writeRegister(REG_POWER_CTL, 0x08);   // measurement mode
  delay(30);
  return verifyAdxl2(true);
}


// Generic shared-SPI helpers used only by the integrated dual-ADXL discovery.
// The frozen V5.1R matcher continues to use its original ADXL2-only functions.
void deselectBothAdxl() {
  digitalWrite(PIN_CS_ADXL1, HIGH);
  digitalWrite(PIN_CS_ADXL2, HIGH);
}

void dualWriteRegister(uint8_t csPin, uint8_t reg, uint8_t value) {
  SPI.beginTransaction(adxlSpiSettings);
  deselectBothAdxl();
  digitalWrite(csPin, LOW);
  SPI.transfer(reg & 0x3F);
  SPI.transfer(value);
  digitalWrite(csPin, HIGH);
  SPI.endTransaction();
}

uint8_t dualReadRegister(uint8_t csPin, uint8_t reg) {
  SPI.beginTransaction(adxlSpiSettings);
  deselectBothAdxl();
  digitalWrite(csPin, LOW);
  SPI.transfer(SPI_READ_BIT | (reg & 0x3F));
  uint8_t value = SPI.transfer(0x00);
  digitalWrite(csPin, HIGH);
  SPI.endTransaction();
  return value;
}

RawAcceleration dualReadRawXYZ(uint8_t csPin) {
  RawAcceleration r = {};
  SPI.beginTransaction(adxlSpiSettings);
  deselectBothAdxl();
  digitalWrite(csPin, LOW);
  SPI.transfer(SPI_READ_BIT | SPI_MB_BIT | (REG_DATAX0 & 0x3F));
  uint8_t x0 = SPI.transfer(0x00), x1 = SPI.transfer(0x00);
  uint8_t y0 = SPI.transfer(0x00), y1 = SPI.transfer(0x00);
  uint8_t z0 = SPI.transfer(0x00), z1 = SPI.transfer(0x00);
  digitalWrite(csPin, HIGH);
  SPI.endTransaction();
  r.x = static_cast<int16_t>((static_cast<uint16_t>(x1) << 8) | x0);
  r.y = static_cast<int16_t>((static_cast<uint16_t>(y1) << 8) | y0);
  r.z = static_cast<int16_t>((static_cast<uint16_t>(z1) << 8) | z0);
  return r;
}

bool verifyReferenceAdxl1(bool printDetails) {
  uint8_t devid = dualReadRegister(PIN_CS_ADXL1, REG_DEVID);
  uint8_t format = dualReadRegister(PIN_CS_ADXL1, REG_DATA_FORMAT);
  uint8_t rate = dualReadRegister(PIN_CS_ADXL1, REG_BW_RATE);
  uint8_t power = dualReadRegister(PIN_CS_ADXL1, REG_POWER_CTL);
  bool ok = devid == ADXL_DEVID_OK &&
            ((format & 0x0F) == 0x0B) &&
            ((rate & 0x1F) == 0x0E) &&
            ((power & 0x08) != 0);
  if (printDetails || !ok) {
    Serial.print("ADXL1 DEVID=0x"); Serial.print(devid, HEX);
    Serial.print(" DATA_FORMAT=0x"); Serial.print(format, HEX);
    Serial.print(" BW_RATE=0x"); Serial.print(rate, HEX);
    Serial.print(" POWER_CTL=0x"); Serial.println(power, HEX);
  }
  return ok;
}

bool initializeReferenceAdxl1() {
  dualWriteRegister(PIN_CS_ADXL1, REG_POWER_CTL, 0x00);
  delay(10);
  if (dualReadRegister(PIN_CS_ADXL1, REG_DEVID) != ADXL_DEVID_OK) return false;
  dualWriteRegister(PIN_CS_ADXL1, REG_DATA_FORMAT, 0x0B);
  dualWriteRegister(PIN_CS_ADXL1, REG_BW_RATE, 0x0E);
  dualWriteRegister(PIN_CS_ADXL1, REG_POWER_CTL, 0x08);
  delay(30);
  return verifyReferenceAdxl1(true);
}

bool verifyBothIntegratedSensorsOrRecover() {
  bool a = verifyReferenceAdxl1(false);
  bool b = verifyAdxl2(false);
  if (a && b) return true;
  Serial.println("Dual-ADXL configuration check failed. Reinitializing both sensors once...");
  a = initializeReferenceAdxl1();
  b = initializeAdxl2();
  return a && b;
}

// ============================================================================
// PHASE-CONTINUOUS HARDWARE-TIMER NCO
// ============================================================================

void buildSineTable(uint8_t bank, double dacAmplitude) {
  // V5.1R callers still pass quantized DAC >= 3.0. FxLMS additionally needs
  // a true zero-amplitude table while keeping the phase accumulator alive.
  dacAmplitude = clampDouble(dacAmplitude, 0.0, DAC_MAX);
  for (uint16_t i = 0; i < 256; i++) {
    double theta = 2.0 * PI * static_cast<double>(i) / 256.0;
    int code = 128 + static_cast<int>(lround(dacAmplitude * sin(theta)));
    code = constrain(code, 0, 255);
    visatonSineTable[bank][i] = static_cast<uint8_t>(code);
  }
}

void ARDUINO_ISR_ATTR visatonTimerISR() {
  if (!visatonRunning) return;

  uint32_t previous = visatonPhaseAccumulator;
  uint32_t next = previous + visatonPhaseIncrement;
  visatonPhaseAccumulator = next;

  // Only switch amplitude at phase wrap, near sine zero.
  if (amplitudeTablePending && next < previous) {
    activeSineTable = pendingSineTable;
    amplitudeTablePending = false;
  }

  // Slew phase offset along the shortest circular direction. This avoids a
  // full-size instantaneous waveform jump when the phase sweep changes target.
  int32_t phaseDiff = static_cast<int32_t>(visatonPhaseOffsetTarget -
                                           visatonPhaseOffsetCurrent);
  if (phaseDiff > static_cast<int32_t>(PHASE_SLEW_WORD_PER_ISR)) {
    visatonPhaseOffsetCurrent += PHASE_SLEW_WORD_PER_ISR;
  } else if (phaseDiff < -static_cast<int32_t>(PHASE_SLEW_WORD_PER_ISR)) {
    visatonPhaseOffsetCurrent -= PHASE_SLEW_WORD_PER_ISR;
  } else {
    visatonPhaseOffsetCurrent = visatonPhaseOffsetTarget;
  }

  uint32_t commandPhase = next + visatonPhaseOffsetCurrent;
  uint8_t index = static_cast<uint8_t>(commandPhase >> 24);
  dacWrite(PIN_VISATON_DAC, visatonSineTable[activeSineTable][index]);
}

bool initializeVisatonTimer() {
  visatonTimer = timerBegin(TIMER_BASE_FREQUENCY_HZ);
  if (visatonTimer == nullptr) return false;
  timerAttachInterrupt(visatonTimer, &visatonTimerISR);
  timerAlarm(visatonTimer, TIMER_ALARM_TICKS, true, 0);
  return true;
}

double actualNcoFrequencyHz() {
  return static_cast<double>(visatonPhaseIncrement) *
         static_cast<double>(DAC_UPDATE_RATE_HZ) / 4294967296.0;
}

bool startVisatonInitial(double frequencyHz, double dacAmplitude) {
  frequencyHz = clampDouble(frequencyHz, COMMAND_MIN_HZ, COMMAND_MAX_HZ);
  dacAmplitude = quantizeDac(dacAmplitude);

  visatonRunning = false;
  amplitudeTablePending = false;
  activeSineTable = 0;
  pendingSineTable = 1;
  buildSineTable(0, dacAmplitude);
  buildSineTable(1, dacAmplitude);

  visatonPhaseAccumulator = 0;
  visatonPhaseOffsetCurrent = 0;
  visatonPhaseOffsetTarget = 0;
  visatonPhaseIncrement = static_cast<uint32_t>(
      frequencyHz * 4294967296.0 / static_cast<double>(DAC_UPDATE_RATE_HZ));
  currentCommandFrequencyHz = frequencyHz;
  currentDacAmplitude = dacAmplitude;
  dacWrite(PIN_VISATON_DAC, 128);
  visatonRunning = true;
  return true;
}

bool checkEmergencyStop();

bool waitForPendingAmplitude(uint32_t timeoutMs) {
  uint32_t start = millis();
  while (amplitudeTablePending) {
    if (checkEmergencyStop()) return false;
    if (millis() - start > timeoutMs) return false;
    delay(1);
  }
  return true;
}

bool setVisatonAmplitudeContinuous(double dacAmplitude) {
  dacAmplitude = quantizeDac(dacAmplitude);

  if (!visatonRunning || fabs(currentCommandFrequencyHz - testFrequencyHz) > 1.0e-9) {
    return startVisatonInitial(testFrequencyHz, dacAmplitude);
  }

  if (fabs(dacAmplitude - currentDacAmplitude) < 1.0e-9) return true;

  if (!waitForPendingAmplitude(200)) return false;
  uint8_t inactive = static_cast<uint8_t>(1U - activeSineTable);
  buildSineTable(inactive, dacAmplitude);
  pendingSineTable = inactive;
  amplitudeTablePending = true;

  // At 20 Hz one wrap is <=50 ms; 180 ms is generous.
  if (!waitForPendingAmplitude(180)) return false;
  currentDacAmplitude = dacAmplitude;
  return true;
}

// FxLMS-specific command helpers. They deliberately allow amplitude = 0 while
// preserving the same 10 kHz phase-continuous NCO and double-buffered table
// architecture used by V5.1R. The validated matcher functions above are not
// changed and still enforce DAC_MIN = 3.
double quantizeFxCommandAmplitude(double value) {
  value = clampDouble(value, 0.0, DAC_MAX);
  value = round(value / FX_COMMAND_QUANTUM_DAC) * FX_COMMAND_QUANTUM_DAC;
  return clampDouble(value, 0.0, DAC_MAX);
}

bool startVisatonFxInitial(double frequencyHz, double dacAmplitude) {
  frequencyHz = clampDouble(frequencyHz, COMMAND_MIN_HZ, COMMAND_MAX_HZ);
  dacAmplitude = quantizeFxCommandAmplitude(dacAmplitude);

  visatonRunning = false;
  amplitudeTablePending = false;
  activeSineTable = 0;
  pendingSineTable = 1;
  buildSineTable(0, dacAmplitude);
  buildSineTable(1, dacAmplitude);

  visatonPhaseAccumulator = 0;
  visatonPhaseIncrement = static_cast<uint32_t>(
      frequencyHz * 4294967296.0 / static_cast<double>(DAC_UPDATE_RATE_HZ));
  visatonPhaseOffsetCurrent = 0;
  visatonPhaseOffsetTarget = 0;
  currentCommandFrequencyHz = frequencyHz;
  currentDacAmplitude = dacAmplitude;
  dacWrite(PIN_VISATON_DAC, 128);
  visatonRunning = true;
  return true;
}

bool setVisatonFxAmplitudeContinuous(double dacAmplitude) {
  dacAmplitude = quantizeFxCommandAmplitude(dacAmplitude);
  if (!visatonRunning || fabs(currentCommandFrequencyHz - testFrequencyHz) > 1.0e-9) {
    return startVisatonFxInitial(testFrequencyHz, dacAmplitude);
  }
  if (fabs(dacAmplitude - currentDacAmplitude) < 1.0e-9) return true;
  if (!waitForPendingAmplitude(200)) return false;
  uint8_t inactive = static_cast<uint8_t>(1U - activeSineTable);
  buildSineTable(inactive, dacAmplitude);
  pendingSineTable = inactive;
  amplitudeTablePending = true;
  if (!waitForPendingAmplitude(180)) return false;
  currentDacAmplitude = dacAmplitude;
  return true;
}


void stopVisaton() {
  visatonRunning = false;
  amplitudeTablePending = false;
  visatonPhaseAccumulator = 0;
  visatonPhaseIncrement = 0;
  visatonPhaseOffsetCurrent = 0;
  visatonPhaseOffsetTarget = 0;
  currentDacAmplitude = 0.0;
  currentCommandFrequencyHz = 0.0;
  dacWrite(PIN_VISATON_DAC, 128);
}

uint32_t phaseDegreesToWord(double degrees) {
  while (degrees >= 360.0) degrees -= 360.0;
  while (degrees < 0.0) degrees += 360.0;
  return static_cast<uint32_t>(degrees * 4294967296.0 / 360.0);
}

double phaseWordToDegreesSigned(uint32_t word) {
  double degrees = static_cast<double>(word) * 360.0 / 4294967296.0;
  return wrapDegrees(degrees);
}

double getCurrentVisatonPhaseOffsetDeg() {
  noInterrupts();
  uint32_t word = visatonPhaseOffsetCurrent;
  interrupts();
  return phaseWordToDegreesSigned(word);
}

void setVisatonPhaseOffsetTargetDeg(double degrees) {
  uint32_t word = phaseDegreesToWord(degrees);
  noInterrupts();
  visatonPhaseOffsetTarget = word;
  interrupts();
}

bool waitForPhaseOffsetSettled(uint32_t timeoutMs, double toleranceDeg) {
  uint32_t startMs = millis();
  while (millis() - startMs < timeoutMs) {
    if (checkEmergencyStop()) return false;
    noInterrupts();
    uint32_t current = visatonPhaseOffsetCurrent;
    uint32_t target = visatonPhaseOffsetTarget;
    interrupts();
    double errorDeg = fabs(static_cast<double>(static_cast<int32_t>(target - current)) *
                           360.0 / 4294967296.0);
    if (errorDeg <= toleranceDeg) return true;
    delay(1);
  }
  return false;
}

bool setVisatonFrequencyContinuous(double frequencyHz) {
  if (!visatonRunning) return false;
  frequencyHz = clampDouble(frequencyHz, COMMAND_MIN_HZ, COMMAND_MAX_HZ);
  uint32_t increment = static_cast<uint32_t>(
      frequencyHz * 4294967296.0 / static_cast<double>(DAC_UPDATE_RATE_HZ));
  noInterrupts();
  visatonPhaseIncrement = increment;
  interrupts();
  currentCommandFrequencyHz = frequencyHz;
  return true;
}

// ============================================================================
// EMERGENCY STOP / SETTLING
// ============================================================================

bool checkEmergencyStop() {
  if (emergencyStopRequested) return true;
  if (!automaticTestRunning) return false;

  bool stopSeen = false;
  while (Serial.available()) {
    char c = static_cast<char>(Serial.read());
    if (c == '\r') continue;

    if (c == '\n') {
      emergencyCommandBuffer[emergencyCommandLength] = '\0';

      // Trim surrounding spaces/tabs and require the ENTIRE command to be s/S.
      char *p = emergencyCommandBuffer;
      while (*p == ' ' || *p == '\t') p++;
      char *tail = p + strlen(p);
      while (tail > p && (tail[-1] == ' ' || tail[-1] == '\t')) *--tail = '\0';

      if ((p[0] == 's' || p[0] == 'S') && p[1] == '\0') stopSeen = true;
      emergencyCommandLength = 0;
      emergencyCommandBuffer[0] = '\0';
    } else if (emergencyCommandLength + 1 < EMERGENCY_BUFFER_SIZE) {
      emergencyCommandBuffer[emergencyCommandLength++] = c;
    } else {
      // Overflow means this is not a valid emergency line; discard safely.
      emergencyCommandLength = 0;
      emergencyCommandBuffer[0] = '\0';
    }
  }

  if (stopSeen) {
    emergencyStopRequested = true;
    stopVisaton();
    Serial.println("\nEMERGENCY STOP - VISATON OFF.");
    return true;
  }
  return false;
}

bool interruptibleDelay(uint32_t durationMs) {
  uint32_t start = millis();
  while (millis() - start < durationMs) {
    if (checkEmergencyStop()) return false;
    delay(2);
  }
  return true;
}

uint16_t adaptiveSettleMs(double oldDac, double newDac) {
  double commandPart = SETTLE_BASE_MS + SETTLE_PER_DAC_MS * fabs(newDac - oldDac);
  double cyclePart = SETTLE_MIN_CYCLES * 1000.0 / fmax(testFrequencyHz, 1.0);
  return static_cast<uint16_t>(clampDouble(fmax(commandPart, cyclePart),
                                           SETTLE_BASE_MS, SETTLE_MAX_MS));
}

// ============================================================================
// EXACT-COMMAND-FREQUENCY NCO-REFERENCED I/Q
// ============================================================================

void calculateSyncAxis(const int16_t samples[], const uint32_t phaseRef[],
                       uint16_t sampleCount, AxisSyncResult &result) {
  result = {};
  if (sampleCount < 32) return;

  double meanRaw = 0.0;
  for (uint16_t i = 0; i < sampleCount; i++) meanRaw += samples[i];
  meanRaw /= static_cast<double>(sampleCount);

  double I = 0.0;
  double Q = 0.0;
  double windowSum = 0.0;
  double acSq = 0.0;
  const double PHASE_TO_RAD = 2.0 * PI / 4294967296.0;

  for (uint16_t i = 0; i < sampleCount; i++) {
    double value = (static_cast<double>(samples[i]) - meanRaw) * ADXL_MS2_PER_LSB;
    double w = 0.5 - 0.5 * cos(2.0 * PI * static_cast<double>(i) /
                                static_cast<double>(sampleCount - 1));
    double theta = static_cast<double>(phaseRef[i]) * PHASE_TO_RAD;
    I += value * w * cos(theta);
    Q += value * w * sin(theta);
    windowSum += w;
    acSq += value * value;
  }

  if (windowSum <= 0.0) return;

  result.amplitudeMs2 = 2.0 * sqrt(I * I + Q * Q) / windowSum;

  // Reference convention:
  // generated command = sin(theta)
  // measured = A*sin(theta + phi)
  // therefore I ~ sin(phi), Q ~ cos(phi), so phi = atan2(I,Q).
  result.phaseDeg = wrapDegrees(atan2(I, Q) * 180.0 / PI);

  double acRms = sqrt(acSq / static_cast<double>(sampleCount));
  double fittedRms = result.amplitudeMs2 / sqrt(2.0);
  result.syncRatio = acRms > 1.0e-12 ? fittedRms / acRms : 0.0;
  result.syncRatio = clampDouble(result.syncRatio, 0.0, 1.0);
}

WindowResult acquireWindow(uint16_t sampleCount) {
  WindowResult result = {};
  if (sampleCount < 32 || sampleCount > FFT_SAMPLES) return result;

  if (!verifyAdxl2(false)) {
    result.communicationFault = true;
    return result;
  }

  uint32_t nextSampleUs = micros();
  RawAcceleration previous = {};
  bool havePrevious = false;
  uint16_t stagnantRun = 0;

  for (uint16_t i = 0; i < sampleCount; i++) {
    while (static_cast<int32_t>(micros() - nextSampleUs) < 0) {}
    uint32_t actualUs = micros();
    uint32_t lateness = actualUs - nextSampleUs;
    if (lateness > result.maxLatenessUs) result.maxLatenessUs = lateness;
    if (lateness > LATE_SAMPLE_WARNING_US) result.lateSamples++;
    nextSampleUs += SAMPLE_PERIOD_US;

    phaseReference[i] = visatonPhaseAccumulator;
    RawAcceleration raw = readRawXYZ();
    rawX[i] = raw.x;
    rawY[i] = raw.y;
    rawZ[i] = raw.z;

    if (raw.x == 0 && raw.y == 0 && raw.z == 0) result.zeroTriplets++;

    if (abs(static_cast<int>(raw.x)) >= ADXL_RAW_CLIP_LIMIT ||
        abs(static_cast<int>(raw.y)) >= ADXL_RAW_CLIP_LIMIT ||
        abs(static_cast<int>(raw.z)) >= ADXL_RAW_CLIP_LIMIT) {
      result.rawClipped = true;
    }

    if (havePrevious && raw.x == previous.x && raw.y == previous.y && raw.z == previous.z) {
      stagnantRun++;
      if (stagnantRun > result.longestStagnantRun) result.longestStagnantRun = stagnantRun;
    } else {
      stagnantRun = 0;
    }

    previous = raw;
    havePrevious = true;
  }

  if (!verifyAdxl2(false) ||
      result.zeroTriplets > MAX_ZERO_TRIPLETS ||
      result.longestStagnantRun > MAX_STAGNANT_RUN) {
    result.communicationFault = true;
  }

  result.timingFault = result.lateSamples > MAX_LATE_SAMPLES_PER_WINDOW;

  calculateSyncAxis(rawX, phaseReference, sampleCount, result.axis[0]);
  calculateSyncAxis(rawY, phaseReference, sampleCount, result.axis[1]);
  calculateSyncAxis(rawZ, phaseReference, sampleCount, result.axis[2]);

  result.totalAmplitudeMs2 = sqrt(
      result.axis[0].amplitudeMs2 * result.axis[0].amplitudeMs2 +
      result.axis[1].amplitudeMs2 * result.axis[1].amplitudeMs2 +
      result.axis[2].amplitudeMs2 * result.axis[2].amplitudeMs2);

  result.valid = !result.communicationFault && !result.rawClipped && !result.timingFault;
  return result;
}

ControlRecord measureControlRecord(double dac, bool settleIfChanged) {
  ControlRecord result = {};
  result.measured = true;
  result.dac = quantizeDac(dac);

  if (!verifyAdxl2(false)) {
    result.communicationFault = true;
    return result;
  }

  double oldDac = currentDacAmplitude;
  bool commandChanged = !visatonRunning ||
                        fabs(currentCommandFrequencyHz - testFrequencyHz) > 1.0e-9 ||
                        fabs(currentDacAmplitude - result.dac) > 1.0e-9;

  if (commandChanged) {
    if (!setVisatonAmplitudeContinuous(result.dac)) return result;
    if (settleIfChanged && !interruptibleDelay(adaptiveSettleMs(oldDac, result.dac))) return result;
  }

  WindowResult windows[CONTROL_WINDOWS];
  uint8_t validIndex[CONTROL_WINDOWS];
  double selected[CONTROL_WINDOWS];
  uint8_t validCount = 0;

  for (uint8_t w = 0; w < CONTROL_WINDOWS; w++) {
    windows[w] = acquireWindow(CONTROL_SAMPLES);
    result.windowValid[w] = windows[w].valid;
    result.windowSelectedMs2[w] = windows[w].axis[axisIndex()].amplitudeMs2;

    if (windows[w].communicationFault) result.communicationFault = true;
    if (windows[w].rawClipped) result.rawClipped = true;
    if (windows[w].timingFault) result.timingRejected = true;

    for (uint8_t a = 0; a < 3; a++) {
      if (windows[w].axis[a].amplitudeMs2 > AXIS_SOFTWARE_GUARD_MS2) result.safetyExceeded = true;
    }
    if (windows[w].totalAmplitudeMs2 > TOTAL_SOFTWARE_GUARD_MS2) result.safetyExceeded = true;

    if (result.safetyExceeded) {
      stopVisaton();
      return result;
    }

    if (windows[w].valid) {
      validIndex[validCount] = w;
      selected[validCount] = windows[w].axis[axisIndex()].amplitudeMs2;
      validCount++;
    }

    if (w + 1 < CONTROL_WINDOWS && !interruptibleDelay(WINDOW_GAP_MS)) return result;
  }

  result.validWindows = validCount;
  if (validCount < CONTROL_MIN_INLIERS) return result;

  result.selectedMedianMs2 = medianSmall(selected, validCount);
  if (result.selectedMedianMs2 < MIN_REPORT_AMPLITUDE_MS2) return result;

  double deviation[CONTROL_WINDOWS];
  for (uint8_t i = 0; i < validCount; i++) deviation[i] = fabs(selected[i] - result.selectedMedianMs2);
  double mad = medianSmall(deviation, validCount);
  result.madPercent = 100.0 * 1.4826 * mad / fmax(result.selectedMedianMs2, 1.0e-12);

  double acceptedSelected[CONTROL_WINDOWS];
  double phaseByAxis[3][CONTROL_WINDOWS];
  double sumAxis[3] = {0.0, 0.0, 0.0};
  double sumSync[3] = {0.0, 0.0, 0.0};
  double sumTotal = 0.0;
  uint8_t inliers = 0;

  for (uint8_t i = 0; i < validCount; i++) {
    double diffPct = 100.0 * fabs(selected[i] - result.selectedMedianMs2) /
                     fmax(result.selectedMedianMs2, 1.0e-12);
    if (diffPct > WINDOW_OUTLIER_PERCENT) continue;

    uint8_t idx = validIndex[i];
    acceptedSelected[inliers] = selected[i];
    for (uint8_t a = 0; a < 3; a++) {
      sumAxis[a] += windows[idx].axis[a].amplitudeMs2;
      sumSync[a] += windows[idx].axis[a].syncRatio;
      phaseByAxis[a][inliers] = windows[idx].axis[a].phaseDeg;
    }
    sumTotal += windows[idx].totalAmplitudeMs2;
    inliers++;
  }

  result.inlierCount = inliers;
  if (inliers < CONTROL_MIN_INLIERS) return result;

  result.selectedMeanMs2 = meanSmall(acceptedSelected, inliers);
  result.cvPercent = result.selectedMeanMs2 > 1.0e-12
      ? 100.0 * sampleSdSmall(acceptedSelected, inliers, result.selectedMeanMs2) /
        result.selectedMeanMs2
      : 999.0;

  for (uint8_t a = 0; a < 3; a++) {
    result.axisMeanMs2[a] = sumAxis[a] / inliers;
    result.axisSync[a] = sumSync[a] / inliers;
    result.axisPhaseDeg[a] = circularMeanDeg(phaseByAxis[a], inliers);
  }

  result.totalMeanMs2 = sumTotal / inliers;
  uint8_t selectedAxis = axisIndex();
  result.selectedPhaseSdDeg = circularSdDeg(phaseByAxis[selectedAxis], inliers,
                                            result.axisPhaseDeg[selectedAxis]);
  result.timestampMs = millis();

  // SyncRatio intentionally excluded from amplitude validity.
  result.amplitudeValid = !result.communicationFault && !result.rawClipped &&
                          !result.safetyExceeded &&
                          result.selectedMedianMs2 >= MIN_REPORT_AMPLITUDE_MS2 &&
                          result.madPercent <= RECORD_MAX_MAD_PERCENT &&
                          result.cvPercent <= RECORD_MAX_CV_PERCENT;

  result.phaseReadyStrong = result.amplitudeValid &&
                            result.axisSync[selectedAxis] >= PHASE_STRONG_MIN_SYNC &&
                            result.selectedPhaseSdDeg <= PHASE_STRONG_MAX_RECORD_SD_DEG;
  return result;
}

void printControlRecord(const char *label, uint16_t index, const ControlRecord &r) {
  bool haveAggregate = r.inlierCount >= CONTROL_MIN_INLIERS &&
                       r.selectedMedianMs2 >= MIN_REPORT_AMPLITUDE_MS2;

  Serial.print(label); Serial.print(" #"); Serial.print(index);
  Serial.print(" | DAC "); Serial.print(r.dac, 2);
  Serial.print(" | CTRL "); Serial.print(axisChar()); Serial.print(" ");

  if (haveAggregate) {
    Serial.print(r.selectedMedianMs2, 5);
    Serial.print(" | err "); Serial.print(targetErrorPercent(r.selectedMedianMs2), 2); Serial.print(" %");
    Serial.print(" | X/Y/Z ");
    Serial.print(r.axisMeanMs2[0], 5); Serial.print(" / ");
    Serial.print(r.axisMeanMs2[1], 5); Serial.print(" / ");
    Serial.print(r.axisMeanMs2[2], 5);
    Serial.print(" | CV "); Serial.print(r.cvPercent, 2);
    Serial.print(" | MAD "); Serial.print(r.madPercent, 2);
  } else {
    // A rejected/unavailable estimate is NOT a physical zero.
    Serial.print("N/A | err N/A | X/Y/Z N/A / N/A / N/A | CV N/A | MAD N/A");
  }

  Serial.print(" | inliers "); Serial.print(r.inlierCount);

  if (r.safetyExceeded) Serial.println(" | SAFETY_STOP");
  else if (r.communicationFault) Serial.println(" | SPI/STALE_DATA_FAULT");
  else if (r.rawClipped) Serial.println(" | RAW_CLIPPING");
  else if (!r.amplitudeValid) Serial.println(" | AMPLITUDE_QUALITY_REJECT");
  else if (inTargetBand(r.selectedMedianMs2, PREFERRED_BAND_PERCENT)) Serial.println(" | PREFERRED");
  else if (inTargetBand(r.selectedMedianMs2, ACCEPTED_BAND_PERCENT)) Serial.println(" | ACCEPTED");
  else Serial.println(" | VALID");

  // Only print per-window detail when the canonical record was rejected. This
  // preserves V4's 3x512 estimator while making rejection causes observable.
  if (!r.amplitudeValid) {
    Serial.print("  WINDOW_DIAG ");
    for (uint8_t w = 0; w < CONTROL_WINDOWS; w++) {
      Serial.print("W"); Serial.print(w + 1); Serial.print("=");
      if (r.windowValid[w]) Serial.print(r.windowSelectedMs2[w], 5);
      else Serial.print("N/A");
      if (w + 1 < CONTROL_WINDOWS) Serial.print(" | ");
    }
    Serial.println();
  }
}

// ============================================================================
// SAME-DAC STABLE POINT
// ============================================================================

StablePoint aggregateStablePair(const ControlRecord &a, const ControlRecord &b, double driftPct) {
  StablePoint p = {};
  p.valid = true;
  p.stationary = true;
  p.phaseReadyStrong = a.phaseReadyStrong && b.phaseReadyStrong;
  p.dac = a.dac;
  p.amplitudeMs2 = 0.5 * (a.selectedMedianMs2 + b.selectedMedianMs2);
  p.pairDriftPercent = driftPct;
  p.recordsUsed = 2;
  p.timestampMs = b.timestampMs;
  p.totalMeanMs2 = 0.5 * (a.totalMeanMs2 + b.totalMeanMs2);
  p.selectedPhaseSdDeg = fmax(a.selectedPhaseSdDeg, b.selectedPhaseSdDeg);

  for (uint8_t axis = 0; axis < 3; axis++) {
    p.axisMeanMs2[axis] = 0.5 * (a.axisMeanMs2[axis] + b.axisMeanMs2[axis]);
    p.axisSync[axis] = 0.5 * (a.axisSync[axis] + b.axisSync[axis]);
    double angles[2] = {a.axisPhaseDeg[axis], b.axisPhaseDeg[axis]};
    p.axisPhaseDeg[axis] = circularMeanDeg(angles, 2);
  }
  return p;
}

StablePoint stablePointFromSingleCoarseRecord(const ControlRecord &r) {
  StablePoint p = {};
  if (!r.amplitudeValid) return p;
  p.valid = true;
  p.stationary = false; // one record is reconnaissance only, not proof of stationarity
  p.phaseReadyStrong = r.phaseReadyStrong;
  p.dac = r.dac;
  p.amplitudeMs2 = r.selectedMedianMs2;
  p.pairDriftPercent = 0.0;
  p.recordsUsed = 1;
  p.timestampMs = r.timestampMs;
  p.totalMeanMs2 = r.totalMeanMs2;
  p.selectedPhaseSdDeg = r.selectedPhaseSdDeg;
  for (uint8_t a = 0; a < 3; a++) {
    p.axisMeanMs2[a] = r.axisMeanMs2[a];
    p.axisSync[a] = r.axisSync[a];
    p.axisPhaseDeg[a] = r.axisPhaseDeg[a];
  }
  return p;
}

StablePoint measureCoarseAdaptivePoint(double dac, const char *label, uint16_t &recordCounter) {
  StablePoint out = {};
  out.dac = quantizeDac(dac);
  ControlRecord validRecords[STABLE_POINT_MAX_RECORDS];
  uint8_t validCount = 0;

  for (uint8_t attempt = 0; attempt < STABLE_POINT_MAX_RECORDS; attempt++) {
    ControlRecord rec = measureControlRecord(out.dac, true);
    recordCounter++;
    printControlRecord(label, recordCounter, rec);

    if (rec.safetyExceeded) { out.safetyExceeded = true; return out; }
    if (rec.communicationFault || rec.rawClipped) { out.hardwareFault = true; return out; }
    if (!rec.amplitudeValid) continue;

    validRecords[validCount++] = rec;
    double absErr = fabs(targetErrorPercent(rec.selectedMedianMs2));
    if (absErr > FAST_COARSE_SINGLE_RECORD_ERROR_PERCENT && validCount == 1) {
      Serial.print("  FAST_COARSE: |error|="); Serial.print(absErr, 1);
      Serial.println(" % > 20% -> one clean canonical record accepted for coarse location only.");
      return stablePointFromSingleCoarseRecord(rec);
    }

    if (validCount >= 2) {
      double bestDrift = 1.0e99;
      int bestI = -1, bestJ = -1;
      for (uint8_t i = 0; i < validCount; i++) {
        for (uint8_t j = i + 1; j < validCount; j++) {
          double d = percentDifference(validRecords[i].selectedMedianMs2,
                                       validRecords[j].selectedMedianMs2);
          if (d < bestDrift) { bestDrift = d; bestI = i; bestJ = j; }
        }
      }
      if (bestI >= 0 && bestDrift <= STABLE_PAIR_MAX_DRIFT_PERCENT) {
        return aggregateStablePair(validRecords[bestI], validRecords[bestJ], bestDrift);
      }
    }
  }

  out.stationary = false;
  return out;
}

StablePoint measureStablePoint(double dac, const char *label, uint16_t &recordCounter) {
  StablePoint out = {};
  out.dac = quantizeDac(dac);

  ControlRecord validRecords[STABLE_POINT_MAX_RECORDS];
  uint8_t validCount = 0;

  for (uint8_t attempt = 0; attempt < STABLE_POINT_MAX_RECORDS; attempt++) {
    ControlRecord rec = measureControlRecord(out.dac, true);
    recordCounter++;
    printControlRecord(label, recordCounter, rec);

    if (rec.safetyExceeded) {
      out.safetyExceeded = true;
      return out;
    }
    if (rec.communicationFault || rec.rawClipped) {
      out.hardwareFault = true;
      return out;
    }
    if (!rec.amplitudeValid) continue;

    validRecords[validCount++] = rec;

    // As soon as any pair is sufficiently consistent, accept the closest pair.
    if (validCount >= 2) {
      double bestDrift = 1.0e99;
      int bestI = -1, bestJ = -1;
      for (uint8_t i = 0; i < validCount; i++) {
        for (uint8_t j = i + 1; j < validCount; j++) {
          double d = percentDifference(validRecords[i].selectedMedianMs2,
                                       validRecords[j].selectedMedianMs2);
          if (d < bestDrift) {
            bestDrift = d;
            bestI = i;
            bestJ = j;
          }
        }
      }
      if (bestI >= 0 && bestDrift <= STABLE_PAIR_MAX_DRIFT_PERCENT) {
        return aggregateStablePair(validRecords[bestI], validRecords[bestJ], bestDrift);
      }
    }
  }

  out.stationary = false;
  return out;
}

void printStablePoint(const char *label, const StablePoint &p) {
  Serial.print(label);
  Serial.print(" | DAC "); Serial.print(p.dac, 2);
  Serial.print(" | amp "); Serial.print(p.amplitudeMs2, 5);
  Serial.print(" | pair drift "); Serial.print(p.pairDriftPercent, 2); Serial.print(" %");
  Serial.print(" | Sync "); Serial.print(p.axisSync[axisIndex()], 3);
  if (!p.valid) Serial.println(" | INVALID/NONSTATIONARY");
  else Serial.println(" | STABLE");
}

// ============================================================================
// TRANSIENT / TRANSFER-STATE DETECTORS
// ============================================================================

bool commonPathCollapse(const StablePoint &previous, const StablePoint &current) {
  if (!previous.valid || !current.valid) return false;
  if (current.dac <= previous.dac + 1.0e-9) return false;
  if (previous.totalMeanMs2 < 0.10) return false;

  double threshold = 1.0 - COMMON_PATH_COLLAPSE_PERCENT / 100.0;
  if (current.totalMeanMs2 / previous.totalMeanMs2 > threshold) return false;

  uint8_t collapsedAxes = 0;
  for (uint8_t a = 0; a < 3; a++) {
    if (previous.axisMeanMs2[a] < 0.08) continue;
    if (current.axisMeanMs2[a] / previous.axisMeanMs2[a] < threshold) collapsedAxes++;
  }
  return collapsedAxes >= 2;
}

bool sameDacAbruptChange(const ControlRecord &previous, const ControlRecord &current) {
  if (!previous.amplitudeValid || !current.amplitudeValid) return false;
  if (fabs(previous.dac - current.dac) > 1.0e-9) return false;

  if (percentDifference(previous.selectedMedianMs2, current.selectedMedianMs2) <
      SAME_DAC_ABRUPT_PERCENT) return false;

  double totalChange = percentDifference(previous.totalMeanMs2, current.totalMeanMs2);
  uint8_t changedAxes = 0;
  for (uint8_t a = 0; a < 3; a++) {
    if (percentDifference(previous.axisMeanMs2[a], current.axisMeanMs2[a]) >=
        SAME_DAC_ABRUPT_PERCENT) changedAxes++;
  }
  return totalChange >= SAME_DAC_ABRUPT_PERCENT || changedAxes >= 2;
}

// ============================================================================
// HYBRID BRACKETED ROOT ACQUISITION
// ============================================================================

StablePoint chooseCloserPoint(const StablePoint &a, const StablePoint &b) {
  if (!a.valid) return b;
  if (!b.valid) return a;
  double ea = fabs(targetErrorPercent(a.amplitudeMs2));
  double eb = fabs(targetErrorPercent(b.amplitudeMs2));
  if (ea < eb - 1.0e-9) return a;
  if (eb < ea - 1.0e-9) return b;
  if (a.pairDriftPercent < b.pairDriftPercent - 0.1) return a;
  if (b.pairDriftPercent < a.pairDriftPercent - 0.1) return b;
  return a.dac <= b.dac ? a : b;
}

bool refreshBracket(StablePoint &low, StablePoint &high, uint16_t &recordCounter) {
  Serial.println("\nRefreshing bracket endpoints in the CURRENT plant state...");
  StablePoint lowNew = measureStablePoint(low.dac, "BRACKET_LOW_REFRESH", recordCounter);
  if (!lowNew.valid) return false;
  StablePoint highNew = measureStablePoint(high.dac, "BRACKET_HIGH_REFRESH", recordCounter);
  if (!highNew.valid) return false;

  if (!(lowNew.dac < highNew.dac &&
        lowNew.amplitudeMs2 < targetAmplitudeMs2 &&
        highNew.amplitudeMs2 > targetAmplitudeMs2)) {
    Serial.println("Bracket crossing moved during refresh.");
    return false;
  }

  low = lowNew;
  high = highNew;
  return true;
}

// Arduino 1.8.x preprocessor-safe local re-bracket result codes.
// Use uint8_t constants instead of a mid-file custom enum return type because
// the legacy Arduino prototype generator can emit a function prototype before
// seeing a locally-declared enum type.
static const uint8_t LOCAL_RB_FAILED = 0;
static const uint8_t LOCAL_RB_BRACKET_FOUND = 1;
static const uint8_t LOCAL_RB_CANDIDATE_FOUND = 2;
static const uint8_t LOCAL_RB_HARDWARE_FAULT = 3;
static const uint8_t LOCAL_RB_SAFETY_STOP = 4;
static const uint8_t LOCAL_RB_ABORTED = 5;

// Recover locally after a previously valid bracket stops crossing the target.
// The old bracket is used only to choose a starting DAC; every point used for
// the recovered bracket is freshly measured in the CURRENT plant state.
uint8_t tryLocalRebracket(const StablePoint &oldLow,
                                        const StablePoint &oldHigh,
                                        StablePoint &newLow,
                                        StablePoint &newHigh,
                                        StablePoint &candidate,
                                        uint16_t &recordCounter,
                                        uint16_t &qualityRejects) {
  Serial.println("\n--- LOCAL RE-BRACKET RECOVERY ---");
  Serial.println("Previous bracket no longer crosses the target.");
  Serial.println("Trying the previous local solution region before a full DAC scan.");

  if (checkEmergencyStop()) return LOCAL_RB_ABORTED;

  double seedDac = chooseCloserPoint(oldLow, oldHigh).dac;
  double oldSlope = 0.0;
  if (oldLow.valid && oldHigh.valid && oldHigh.dac > oldLow.dac + 1.0e-9) {
    oldSlope = (oldHigh.amplitudeMs2 - oldLow.amplitudeMs2) /
               (oldHigh.dac - oldLow.dac);
    if (isfinite(oldSlope) && oldSlope > MIN_VALID_SLOPE) {
      double root = oldLow.dac +
                    (targetAmplitudeMs2 - oldLow.amplitudeMs2) / oldSlope;
      if (root >= DAC_MIN && root <= DAC_MAX) seedDac = root;
    }
  }
  seedDac = quantizeDac(seedDac);
  if (seedDac < DAC_MIN) seedDac = DAC_MIN;
  if (seedDac > DAC_MAX) seedDac = DAC_MAX;

  Serial.print("LOCAL RE-BRACKET seed DAC: "); Serial.println(seedDac, 2);
  StablePoint seed = measureStablePoint(seedDac, "LOCAL_REBRACKET", recordCounter);
  if (seed.safetyExceeded) return LOCAL_RB_SAFETY_STOP;
  if (!seed.valid) {
    qualityRejects++;
    if (seed.hardwareFault) return LOCAL_RB_HARDWARE_FAULT;
    Serial.println("Local seed was not stably measurable -> use normal full restart.");
    return LOCAL_RB_FAILED;
  }

  candidate = seed;
  if (inTargetBand(seed.amplitudeMs2, PREFERRED_BAND_PERCENT)) {
    Serial.println("LOCAL RE-BRACKET: fresh seed is already in PREFERRED band.");
    return LOCAL_RB_CANDIDATE_FOUND;
  }

  // Move only in the direction that can restore a sign crossing if the local
  // DAC->amplitude slope remains positive. If that local assumption fails, the
  // bounded search simply gives up and the original full V5.1 restart runs.
  const int8_t direction = (seed.amplitudeMs2 < targetAmplitudeMs2) ? +1 : -1;
  StablePoint previous = seed;
  bool haveAcceptedFallback = inTargetBand(seed.amplitudeMs2, ACCEPTED_BAND_PERCENT);

  for (uint8_t step = 1; step <= LOCAL_REBRACKET_MAX_STEPS; step++) {
    if (checkEmergencyStop()) return LOCAL_RB_ABORTED;

    double offset = direction * LOCAL_REBRACKET_STEP_DAC * step;
    if (fabs(offset) > LOCAL_REBRACKET_RADIUS_DAC + 1.0e-9) break;
    double d = quantizeDac(seedDac + offset);
    if (d < DAC_MIN - 1.0e-9 || d > DAC_MAX + 1.0e-9) break;

    StablePoint p = measureStablePoint(d, "LOCAL_REBRACKET", recordCounter);
    if (p.safetyExceeded) return LOCAL_RB_SAFETY_STOP;
    if (!p.valid) {
      qualityRejects++;
      if (p.hardwareFault) return LOCAL_RB_HARDWARE_FAULT;
      continue;
    }

    candidate = chooseCloserPoint(candidate, p);
    if (inTargetBand(p.amplitudeMs2, ACCEPTED_BAND_PERCENT)) {
      haveAcceptedFallback = true;
    }

    if (inTargetBand(p.amplitudeMs2, PREFERRED_BAND_PERCENT)) {
      candidate = p;
      Serial.println("LOCAL RE-BRACKET: PREFERRED target recovered without a full scan.");
      return LOCAL_RB_CANDIDATE_FOUND;
    }

    if (direction > 0 && previous.amplitudeMs2 < targetAmplitudeMs2 &&
                        p.amplitudeMs2 > targetAmplitudeMs2 &&
                        previous.dac < p.dac) {
      newLow = previous;
      newHigh = p;
      Serial.println("LOCAL RE-BRACKET: fresh local sign bracket recovered.");
      return LOCAL_RB_BRACKET_FOUND;
    }
    if (direction < 0 && p.amplitudeMs2 < targetAmplitudeMs2 &&
                        previous.amplitudeMs2 > targetAmplitudeMs2 &&
                        p.dac < previous.dac) {
      newLow = p;
      newHigh = previous;
      Serial.println("LOCAL RE-BRACKET: fresh local sign bracket recovered.");
      return LOCAL_RB_BRACKET_FOUND;
    }

    previous = p;
  }

  if (haveAcceptedFallback && candidate.valid &&
      inTargetBand(candidate.amplitudeMs2, ACCEPTED_BAND_PERCENT)) {
    Serial.print("LOCAL RE-BRACKET: no crossing found, but retained fresh ACCEPTED candidate DAC ");
    Serial.print(candidate.dac, 2);
    Serial.print(" | err ");
    Serial.print(targetErrorPercent(candidate.amplitudeMs2), 2);
    Serial.println(" %.");
    return LOCAL_RB_CANDIDATE_FOUND;
  }

  Serial.println("LOCAL RE-BRACKET failed inside +/-3 DAC -> use normal full restart.");
  return LOCAL_RB_FAILED;
}

AcquisitionResult acquireTargetOnce() {
  AcquisitionResult out = {};
  out.status = AcquireStatus::NONSTATIONARY;

  Serial.println("\n============================================================");
  Serial.println("STAGE 1 - STABLE AUTHORITY SCAN + V5 HYBRID ROOT REFINEMENT");
  Serial.print("Frequency: "); Serial.print(testFrequencyHz, 5); Serial.println(" Hz");
  Serial.print("Axis: "); Serial.println(axisChar());
  Serial.print("Target: "); Serial.print(targetAmplitudeMs2, 5); Serial.println(" m/s^2 peak");
  Serial.print("Preferred band: +/-"); Serial.print(PREFERRED_BAND_PERCENT, 1); Serial.println(" %");
  Serial.print("Accepted band: +/-"); Serial.print(ACCEPTED_BAND_PERCENT, 1); Serial.println(" %");
  Serial.println("Accepted points are retained as safe fallbacks and interpolation is tried.");
  Serial.println("Every model point requires a stable same-DAC pair.");
  Serial.println("Phase/Sync diagnostics do not gate amplitude acquisition.");
  Serial.println("============================================================");

  StablePoint previous = {};
  bool havePrevious = false;
  StablePoint best = {};
  StablePoint low = {};
  StablePoint high = {};
  bool bracketFound = false;
  bool everBelowTarget = false;
  bool everAboveTarget = false;

  // V5.1 warm start: one fresh measurement at the last proven same-condition
  // solution. If it is not already accepted, abandon the hint immediately and
  // execute the unchanged full V5 authority scan.
  if (warmStartUsable()) {
    Serial.print("WARM START - rechecking previous proven DAC ");
    Serial.println(warmStartMemory.dac, 2);
    StablePoint warm = measureStablePoint(warmStartMemory.dac, "WARM_START", out.recordsMeasured);
    if (warm.valid && inTargetBand(warm.amplitudeMs2, ACCEPTED_BAND_PERCENT)) {
      out.success = true;
      out.status = inTargetBand(warm.amplitudeMs2, PREFERRED_BAND_PERCENT)
          ? AcquireStatus::OK : AcquireStatus::QUANTIZATION_LIMITED;
      out.candidate = warm;
      Serial.println("WARM START ACCEPTED after fresh measurement.");
      return out;
    }
    Serial.println("WARM START not valid for the current plant state -> full scan.");
  }

  for (double d = DAC_MIN; d <= DAC_MAX + 1.0e-9; d += COARSE_DAC_STEP) {
    if (checkEmergencyStop()) {
      out.status = AcquireStatus::ABORTED;
      return out;
    }

    StablePoint p = measureCoarseAdaptivePoint(d, "COARSE", out.recordsMeasured);
    if (p.safetyExceeded) {
      out.status = AcquireStatus::SAFETY_STOP;
      return out;
    }
    if (!p.valid) {
      out.qualityRejects++;
      if (p.hardwareFault) {
        out.status = AcquireStatus::HARDWARE_FAULT;
        return out;
      }
      continue;
    }

    if (havePrevious && previous.recordsUsed >= 2 && p.recordsUsed >= 2 &&
        commonPathCollapse(previous, p)) {
      Serial.println("COMMON-PATH COLLAPSE SUSPECTED - confirming same DAC before model update.");
      StablePoint confirm = measureStablePoint(p.dac, "COLLAPSE_CONFIRM", out.recordsMeasured);
      if (!confirm.valid) {
        out.status = confirm.hardwareFault ? AcquireStatus::HARDWARE_FAULT
                                           : AcquireStatus::NONSTATIONARY;
        return out;
      }
      if (commonPathCollapse(previous, confirm)) {
        Serial.println("Persistent common-path state change confirmed.");
        out.status = AcquireStatus::NONSTATIONARY;
        return out;
      }
      Serial.println("Transient collapse rejected; confirmation accepted.");
      p = confirm;
    }

    if (p.amplitudeMs2 < targetAmplitudeMs2) everBelowTarget = true;
    if (p.amplitudeMs2 > targetAmplitudeMs2) everAboveTarget = true;

    // Preserve useful local slope information even when a coarse point itself
    // lands directly in the preferred band. V5 could otherwise enter Stage 2
    // with a good target but no slope memory.
    if (havePrevious && p.dac > previous.dac &&
        previous.recordsUsed >= 2 && p.recordsUsed >= 2) {
      double localSlope = (p.amplitudeMs2 - previous.amplitudeMs2) /
                          (p.dac - previous.dac);
      pushSlope(localSlope);
    }

    StablePoint oldBest = best;
    best = chooseCloserPoint(best, p);
    bool becameBest = !oldBest.valid || fabs(targetErrorPercent(best.amplitudeMs2)) <
                                      fabs(targetErrorPercent(oldBest.amplitudeMs2)) - 1.0e-9;

    if (inTargetBand(p.amplitudeMs2, PREFERRED_BAND_PERCENT)) {
      out.success = true;
      out.status = AcquireStatus::OK;
      out.candidate = p;
      if (havePrevious && previous.dac < p.dac) {
        if (previous.amplitudeMs2 < targetAmplitudeMs2) out.low = previous;
        if (p.amplitudeMs2 > targetAmplitudeMs2) out.high = p;
      }
      return out;
    }

    if (becameBest && inTargetBand(best.amplitudeMs2, ACCEPTED_BAND_PERCENT)) {
      Serial.print("ACCEPTED FALLBACK SAVED: DAC "); Serial.print(best.dac, 2);
      Serial.print(" | amp "); Serial.print(best.amplitudeMs2, 5);
      Serial.print(" | err "); Serial.print(targetErrorPercent(best.amplitudeMs2), 2);
      Serial.println(" % - continuing to obtain a bracket for interpolation.");
    }

    // If the minimum DAC is already above target, no lower interpolation point
    // exists. Accept it only if it is inside the accepted band.
    if (!havePrevious && p.amplitudeMs2 > targetAmplitudeMs2) {
      out.candidate = p;
      if (inTargetBand(p.amplitudeMs2, ACCEPTED_BAND_PERCENT)) {
        out.success = true;
        out.status = AcquireStatus::QUANTIZATION_LIMITED;
      } else if (fabs(p.dac - DAC_MIN) < 1.0e-9) {
        // Only the actual minimum command can prove a true below-range target.
        out.status = AcquireStatus::TARGET_BELOW_RANGE;
      } else {
        Serial.println("Lower DAC points were not stably qualified; range cannot be proven.");
        out.status = AcquireStatus::NONSTATIONARY;
      }
      return out;
    }

    if (havePrevious && previous.amplitudeMs2 < targetAmplitudeMs2 &&
                        p.amplitudeMs2 > targetAmplitudeMs2 &&
                        previous.dac < p.dac) {
      low = previous;
      high = p;
      bracketFound = true;
      break;
    }

    previous = p;
    havePrevious = true;
  }

  if (!bracketFound) {
    out.candidate = best;
    if (best.valid && inTargetBand(best.amplitudeMs2, ACCEPTED_BAND_PERCENT)) {
      out.success = true;
      out.status = AcquireStatus::QUANTIZATION_LIMITED;
    } else if (everBelowTarget && everAboveTarget) {
      // The target was crossed somewhere but no stable increasing bracket
      // survived. Do not falsely call this an authority-limit failure.
      Serial.println("Target crossing observed but response was non-monotonic/nonstationary.");
      out.status = AcquireStatus::NONSTATIONARY;
    } else if (everBelowTarget && !everAboveTarget) {
      out.status = AcquireStatus::TARGET_ABOVE_RANGE;
    } else {
      out.status = AcquireStatus::NONSTATIONARY;
    }
    return out;
  }

  Serial.println("\n--- RAW SIGN BRACKET FOUND ---");
  printStablePoint("LOW", low);
  printStablePoint("HIGH", high);

  {
    StablePoint oldLow = low;
    StablePoint oldHigh = high;
    if (!refreshBracket(low, high, out.recordsMeasured)) {
      StablePoint localCandidate = {};
      uint8_t lr = tryLocalRebracket(oldLow, oldHigh, low, high,
                                                   localCandidate, out.recordsMeasured,
                                                   out.qualityRejects);
      if (lr == LOCAL_RB_CANDIDATE_FOUND) {
        out.candidate = localCandidate;
        out.success = true;
        out.status = inTargetBand(localCandidate.amplitudeMs2, PREFERRED_BAND_PERCENT)
            ? AcquireStatus::OK : AcquireStatus::QUANTIZATION_LIMITED;
        return out;
      }
      if (lr == LOCAL_RB_HARDWARE_FAULT) {
        out.status = AcquireStatus::HARDWARE_FAULT;
        return out;
      }
      if (lr == LOCAL_RB_SAFETY_STOP) {
        out.status = AcquireStatus::SAFETY_STOP;
        return out;
      }
      if (lr == LOCAL_RB_ABORTED) {
        out.status = AcquireStatus::ABORTED;
        return out;
      }
      if (lr != LOCAL_RB_BRACKET_FOUND) {
        out.status = AcquireStatus::NONSTATIONARY;
        return out;
      }
    }
  }

  out.low = low;
  out.high = high;
  best = chooseCloserPoint(low, high); // current-state fallback after refresh
  pushSlope((high.amplitudeMs2 - low.amplitudeMs2) / (high.dac - low.dac));

  for (uint8_t iteration = 0; iteration < MAX_REFINE_ITERATIONS; iteration++) {
    if (checkEmergencyStop()) {
      out.status = AcquireStatus::ABORTED;
      return out;
    }

    if (inTargetBand(best.amplitudeMs2, PREFERRED_BAND_PERCENT)) {
      out.success = true;
      out.status = AcquireStatus::OK;
      out.candidate = best;
      out.low = low;
      out.high = high;
      return out;
    }

    bool acceptedFallback = inTargetBand(best.amplitudeMs2, ACCEPTED_BAND_PERCENT);
    if (acceptedFallback) {
      Serial.print("ACCEPTED FALLBACK ACTIVE: DAC "); Serial.print(best.dac, 2);
      Serial.print(" | err "); Serial.print(targetErrorPercent(best.amplitudeMs2), 2);
      Serial.println(" % - attempting bounded interpolation toward PREFERRED.");
    }

    double width = high.dac - low.dac;
    if (width <= DAC_QUANTUM + 1.0e-9) {
      out.candidate = best;
      out.low = low;
      out.high = high;
      out.success = best.valid && inTargetBand(best.amplitudeMs2, ACCEPTED_BAND_PERCENT);
      out.status = out.success ? AcquireStatus::QUANTIZATION_LIMITED
                               : AcquireStatus::NONSTATIONARY;
      return out;
    }

    uint32_t now = millis();
    if ((now - low.timestampMs) > BRACKET_MAX_AGE_MS ||
        (now - high.timestampMs) > BRACKET_MAX_AGE_MS) {
      StablePoint oldLow = low;
      StablePoint oldHigh = high;
      if (!refreshBracket(low, high, out.recordsMeasured)) {
        StablePoint localCandidate = {};
        uint8_t lr = tryLocalRebracket(oldLow, oldHigh, low, high,
                                                     localCandidate, out.recordsMeasured,
                                                     out.qualityRejects);
        if (lr == LOCAL_RB_CANDIDATE_FOUND) {
          out.candidate = localCandidate;
          out.success = true;
          out.status = inTargetBand(localCandidate.amplitudeMs2, PREFERRED_BAND_PERCENT)
              ? AcquireStatus::OK : AcquireStatus::QUANTIZATION_LIMITED;
          return out;
        }
        if (lr == LOCAL_RB_HARDWARE_FAULT) {
          out.status = AcquireStatus::HARDWARE_FAULT;
          return out;
        }
        if (lr == LOCAL_RB_SAFETY_STOP) {
          out.status = AcquireStatus::SAFETY_STOP;
          return out;
        }
        if (lr == LOCAL_RB_ABORTED) {
          out.status = AcquireStatus::ABORTED;
          return out;
        }
        if (lr != LOCAL_RB_BRACKET_FOUND) {
          out.status = AcquireStatus::NONSTATIONARY;
          return out;
        }
      }
      // A bracket refresh represents the current plant state. Do not prefer a
      // stale old fallback over freshly remeasured endpoints.
      best = chooseCloserPoint(low, high);
      acceptedFallback = inTargetBand(best.amplitudeMs2, ACCEPTED_BAND_PERCENT);
    }

    double slope = (high.amplitudeMs2 - low.amplitudeMs2) / (high.dac - low.dac);
    double predicted = 0.5 * (low.dac + high.dac); // safe bisection default
    const char *refineMode = "BISECTION";

    if (isfinite(slope) && slope > MIN_VALID_SLOPE) {
      double secant = low.dac + (targetAmplitudeMs2 - low.amplitudeMs2) / slope;

      if (acceptedFallback) {
        // V5 requirement: once we already have an accepted fallback, explicitly
        // try the interpolated/root estimate rather than rejecting it merely for
        // lying near a bracket endpoint. Quantization/bounds still protect it.
        if (secant > low.dac && secant < high.dac) {
          predicted = secant;
          refineMode = "ACCEPTED_INTERPOLATION";
        }
      } else {
        double guard = SECANT_GUARD_FRACTION * width;
        if (secant > low.dac + guard && secant < high.dac - guard) {
          predicted = secant;
          refineMode = "SECANT";
        }
      }
    }

    double testDac = quantizeDac(predicted);
    if (testDac <= low.dac + 1.0e-9) testDac = quantizeDac(low.dac + DAC_QUANTUM);
    if (testDac >= high.dac - 1.0e-9) testDac = quantizeDac(high.dac - DAC_QUANTUM);

    Serial.print("\nREFINE "); Serial.print(iteration + 1);
    Serial.print(" | mode "); Serial.print(refineMode);
    Serial.print(" | bracket "); Serial.print(low.dac, 2); Serial.print("(");
    Serial.print(low.amplitudeMs2, 4); Serial.print(") -> ");
    Serial.print(high.dac, 2); Serial.print("("); Serial.print(high.amplitudeMs2, 4);
    Serial.print(") | slope "); Serial.print(slope, 6);
    Serial.print(" | predicted "); Serial.print(predicted, 3);
    Serial.print(" | test DAC "); Serial.println(testDac, 2);

    StablePoint savedBest = best;
    double savedBestAbsErr = fabs(targetErrorPercent(savedBest.amplitudeMs2));

    StablePoint p = measureStablePoint(testDac, "REFINE", out.recordsMeasured);
    if (!p.valid) {
      out.qualityRejects++;
      if (p.hardwareFault) {
        out.status = AcquireStatus::HARDWARE_FAULT;
        return out;
      }
      p = measureStablePoint(testDac, "REFINE_RETRY", out.recordsMeasured);
      if (!p.valid) {
        out.status = p.hardwareFault ? AcquireStatus::HARDWARE_FAULT
                                     : AcquireStatus::NONSTATIONARY;
        return out;
      }
    }

    double pAbsErr = fabs(targetErrorPercent(p.amplitudeMs2));
    if (pAbsErr < savedBestAbsErr - 1.0e-9) best = p;

    if (p.amplitudeMs2 < targetAmplitudeMs2) low = p;
    else high = p;

    if (high.dac > low.dac) {
      double newSlope = (high.amplitudeMs2 - low.amplitudeMs2) / (high.dac - low.dac);
      pushSlope(newSlope);
    }
    out.low = low;
    out.high = high;

    if (inTargetBand(p.amplitudeMs2, PREFERRED_BAND_PERCENT)) {
      best = p;
      Serial.println("REFINEMENT RESULT: PREFERRED band reached; keeping measured refinement.");
      continue; // top of loop performs clean success return
    }

    if (acceptedFallback) {
      if (pAbsErr < savedBestAbsErr - REFINEMENT_IMPROVEMENT_EPS_PERCENT) {
        Serial.print("REFINEMENT RESULT: improved accepted fallback by ");
        Serial.print(savedBestAbsErr - pAbsErr, 2); Serial.println(" percentage points; continuing.");
      } else {
        best = savedBest;
        Serial.println("REFINEMENT RESULT: no meaningful measured improvement.");
        Serial.print("Restoring accepted fallback DAC "); Serial.print(best.dac, 2);
        Serial.print(" | err "); Serial.print(targetErrorPercent(best.amplitudeMs2), 2);
        Serial.println(" % and ending acquisition without hunting.");
        out.candidate = best;
        out.success = true;
        out.status = AcquireStatus::QUANTIZATION_LIMITED;
        return out;
      }
    }
  }

  out.candidate = best;
  out.success = best.valid && inTargetBand(best.amplitudeMs2, ACCEPTED_BAND_PERCENT);
  out.status = out.success ? AcquireStatus::QUANTIZATION_LIMITED : AcquireStatus::NONSTATIONARY;
  return out;
}

AcquisitionResult acquireTargetWithRestart() {
  clearSlopeHistory();
  AcquisitionResult last = {};
  uint32_t acquisitionStartMs = millis();

  for (uint8_t restart = 0; restart <= MAX_ACQUISITION_RESTARTS; restart++) {
    if (restart > 0) {
      Serial.println("\n============================================================");
      Serial.print("ACQUISITION RESTART "); Serial.println(restart);
      Serial.println("Local re-bracket failed or no stable bracket survived; performing full scan.");
      Serial.println("============================================================");
      if (!interruptibleDelay(500)) break;
    }

    last = acquireTargetOnce();
    last.restarts = restart;
    last.elapsedMs = millis() - acquisitionStartMs;
    if (last.success) return last;
    if (last.status != AcquireStatus::NONSTATIONARY) return last;
    if (checkEmergencyStop()) return last;
  }
  last.elapsedMs = millis() - acquisitionStartMs;
  return last;
}

const char *acquireStatusText(AcquireStatus s) {
  switch (s) {
    case AcquireStatus::OK: return "PREFERRED_TARGET_ACQUIRED";
    case AcquireStatus::QUANTIZATION_LIMITED: return "ACCEPTED_QUANTIZATION_LIMITED";
    case AcquireStatus::TARGET_BELOW_RANGE: return "TARGET_BELOW_DAC_RANGE";
    case AcquireStatus::TARGET_ABOVE_RANGE: return "TARGET_ABOVE_DAC_RANGE";
    case AcquireStatus::NONSTATIONARY: return "NONSTATIONARY";
    case AcquireStatus::HARDWARE_FAULT: return "HARDWARE_FAULT";
    case AcquireStatus::SAFETY_STOP: return "SAFETY_STOP";
    default: return "ABORTED";
  }
}

void printAcquisitionSummary(const AcquisitionResult &r) {
  Serial.println("\n============================================================");
  Serial.println("ACQUISITION SUMMARY");
  Serial.print("Status: "); Serial.println(acquireStatusText(r.status));
  Serial.print("Success: "); Serial.println(r.success ? "YES" : "NO");
  Serial.print("Canonical records measured: "); Serial.println(r.recordsMeasured);
  Serial.print("Quality rejects: "); Serial.println(r.qualityRejects);
  Serial.print("Restarts: "); Serial.println(r.restarts);
  Serial.print("Acquisition time: "); Serial.print(r.elapsedMs / 1000.0, 3); Serial.println(" s");
  if (r.candidate.valid) {
    Serial.print("Candidate DAC: "); Serial.println(r.candidate.dac, 2);
    Serial.print("Candidate amplitude: "); Serial.print(r.candidate.amplitudeMs2, 5);
    Serial.print(" | error "); Serial.print(targetErrorPercent(r.candidate.amplitudeMs2), 2); Serial.println(" %");

  }
  Serial.println("============================================================");
}

void acceptAcquisition(const AcquisitionResult &r) {
  targetAcquired = r.success && r.candidate.valid;
  if (!targetAcquired) return;

  lockedPoint = r.candidate;
  lastBracketLow = r.low;
  lastBracketHigh = r.high;

  if (r.low.valid && r.high.valid && r.high.dac > r.low.dac) {
    pushSlope((r.high.amplitudeMs2 - r.low.amplitudeMs2) /
              (r.high.dac - r.low.dac));
  }
}

// ============================================================================
// V5.1 FINAL CANDIDATE CONFIRMATION
// ============================================================================

bool confirmCandidateForServo(AcquisitionResult &acq, ServoState &state) {
  Serial.println("\n============================================================");
  Serial.println("V5.1R CANDIDATE FIXED-DAC CONFIRMATION");
  Serial.println("Three fresh records; no DAC movement while stability is checked.");
  Serial.println("============================================================");

  ControlRecord valid[CANDIDATE_CONFIRM_RECORDS];
  uint8_t count = 0;
  for (uint8_t i = 0; i < CANDIDATE_CONFIRM_RECORDS; i++) {
    ControlRecord r = measureControlRecord(currentDacAmplitude, false);
    printControlRecord("CANDIDATE_CONFIRM", i + 1, r);
    if (r.safetyExceeded || r.communicationFault || r.rawClipped) return false;
    if (r.amplitudeValid && count < CANDIDATE_CONFIRM_RECORDS) valid[count++] = r;
  }

  if (count < CANDIDATE_CONFIRM_MIN_VALID) {
    Serial.println("CANDIDATE_NONSTATIONARY - too few valid confirmation records.");
    return false;
  }

  double amps[3];
  double mean = 0.0;
  double minAmp = 1.0e99, maxAmp = -1.0e99;
  for (uint8_t i = 0; i < count; i++) {
    amps[i] = valid[i].selectedMedianMs2;
    mean += amps[i];
    minAmp = fmin(minAmp, amps[i]);
    maxAmp = fmax(maxAmp, amps[i]);
  }
  mean /= count;
  double cv = count >= 2 ? 100.0 * sampleSdSmall(amps, count, mean) / fmax(mean, 1.0e-12) : 0.0;
  double spread = percentDifference(minAmp, maxAmp);

  Serial.print("Candidate confirmation mean: "); Serial.print(mean, 5);
  Serial.print(" | error "); Serial.print(targetErrorPercent(mean), 2);
  Serial.print(" % | inter-record CV "); Serial.print(cv, 2);
  Serial.print(" % | spread "); Serial.print(spread, 2); Serial.println(" %");

  if (!inTargetBand(mean, ACCEPTED_BAND_PERCENT) ||
      cv > CANDIDATE_CONFIRM_MAX_CV_PERCENT ||
      spread > CANDIDATE_CONFIRM_MAX_SPREAD_PERCENT) {
    Serial.println("CANDIDATE_NONSTATIONARY - do not let PI chase this state.");
    return false;
  }

  setPlantBaselineFromRecords(state.plantBaseline, valid, count);
  lockedPlantBaseline = state.plantBaseline;
  lockedPoint.dac = currentDacAmplitude;
  lockedPoint.amplitudeMs2 = mean;
  lockedPoint.valid = true;
  lockedPoint.stationary = true;
  for (uint8_t a = 0; a < 3; a++) lockedPoint.axisMeanMs2[a] = state.plantBaseline.axisMeanMs2[a];
  lockedPoint.totalMeanMs2 = state.plantBaseline.totalMeanMs2;
  acq.candidate = lockedPoint;

  Serial.println("CANDIDATE CONFIRMED STABLE.");
  return true;
}

// ============================================================================
// SLOW ADAPTIVE PI SERVO
// ============================================================================

void resetServoState(ServoState &s) {
  memset(&s, 0, sizeof(s));
  clearTrialState(s);
}
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
void loop() {
  while (Serial.available()) {
    char c = static_cast<char>(Serial.read());
    if (c == '\r') continue;

    if (c == '\n') {
      commandBuffer[commandLength] = '\0';
      processCommand(commandBuffer);
      commandLength = 0;
      commandBuffer[0] = '\0';
    } else if (commandLength + 1 < COMMAND_BUFFER_SIZE) {
      commandBuffer[commandLength++] = c;
    }
  }
  delay(2);
}
